destone28/Amelie2.0/docs/images/insieme.png

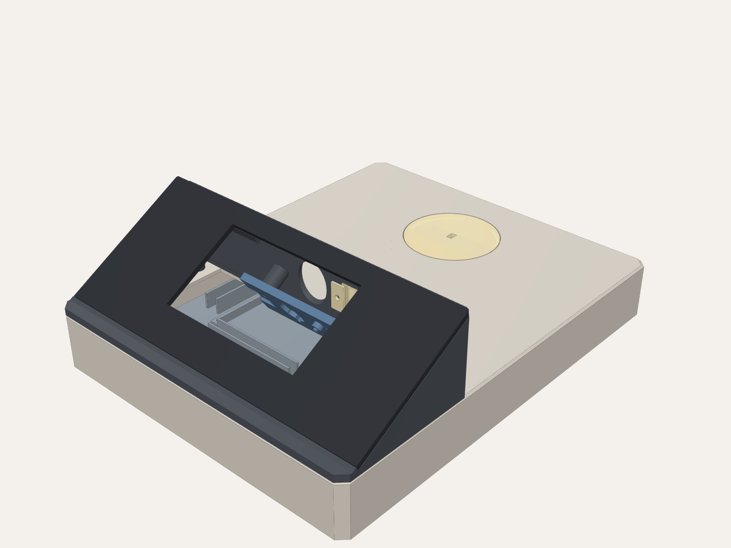
docs/images/insieme.png
