destone28/Amelie2.0/hardware/stl/FermoUno.stl

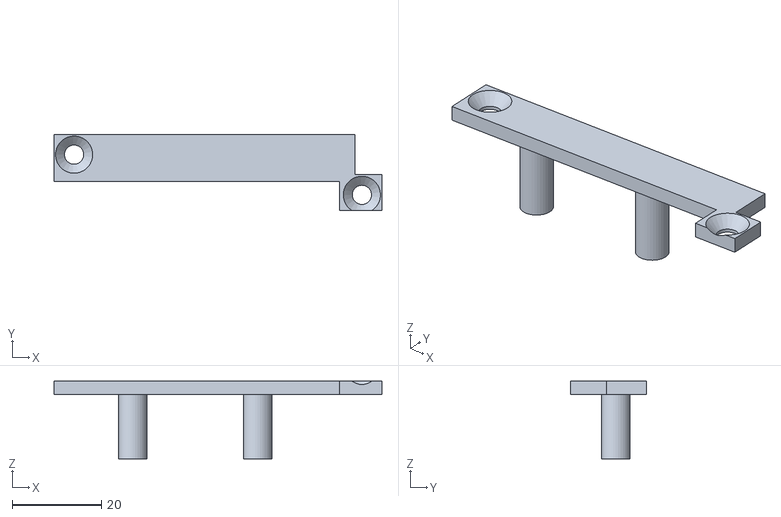
[picture p10: CAD file, 2026-09-26]
hardware/stl/FermoUno.stl
73.4 x 17.0 x 17.4
