destone28/Amelie2.0/hardware/stl/Piastra.stl

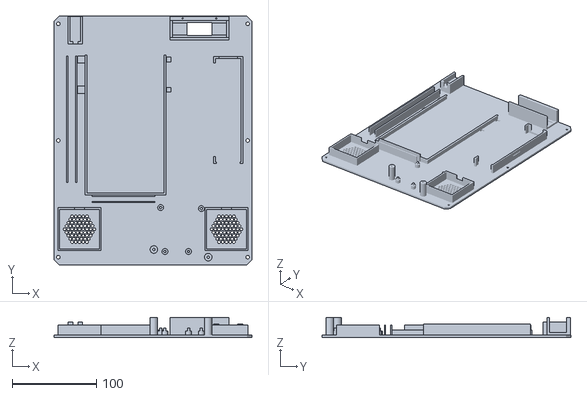
[picture p11: CAD file, 2026-09-26]
hardware/stl/Piastra.stl
234.4 x 294.4 x 24.0
