destone28/Amelie2.0/hardware/stl/FermoSwitch.stl

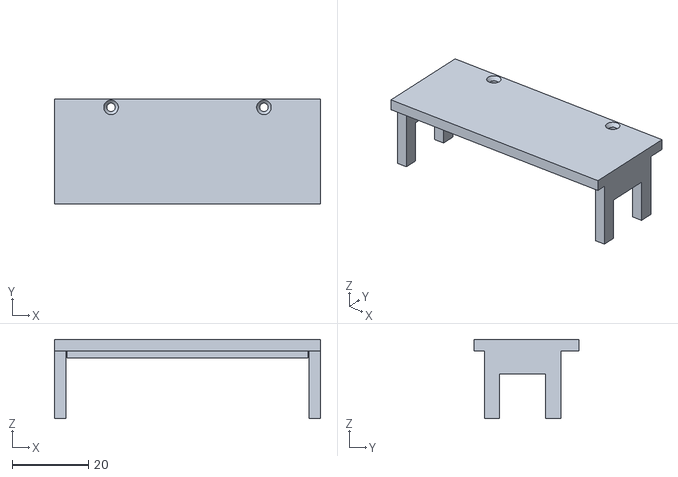
[picture p12: CAD file, 2026-09-26]
hardware/stl/FermoSwitch.stl
69.6 x 27.6 x 20.7
