destone28/Amelie2.0/hardware/stl/Frontale.stl

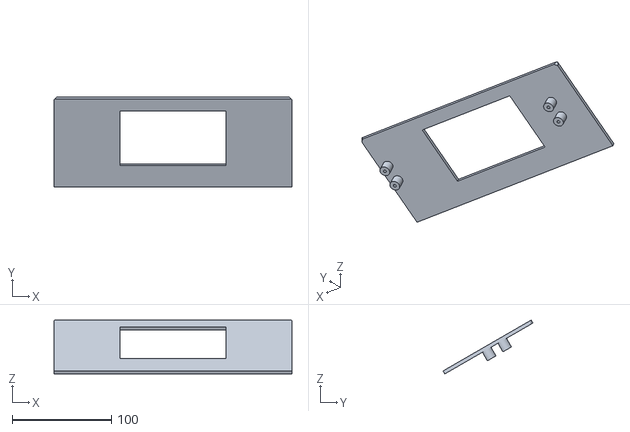
[picture p13: CAD file, 2026-09-26]
hardware/stl/Frontale.stl
239.4 x 90.4 x 54.2
