destone28/Amelie2.0/hardware/stl/VassoioLuce.stl

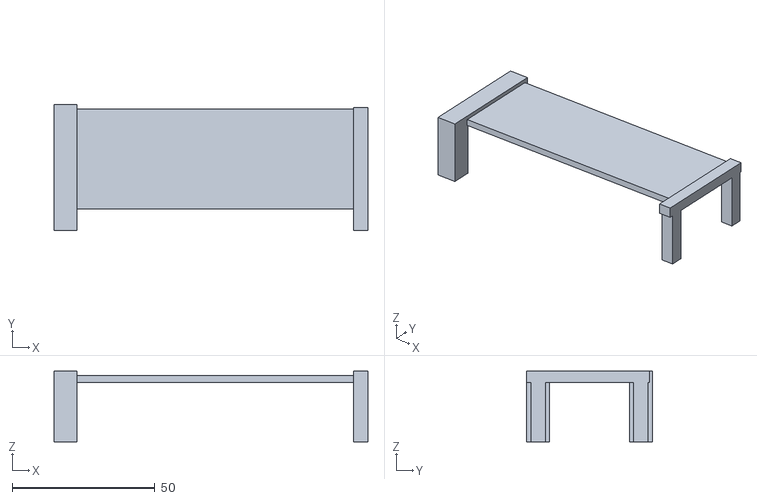
[picture p14: CAD file, 2026-09-26]
hardware/stl/VassoioLuce.stl
110.0 x 44.0 x 24.8
