destone28/Amelie2.0/hardware/stl/FermoHub.stl

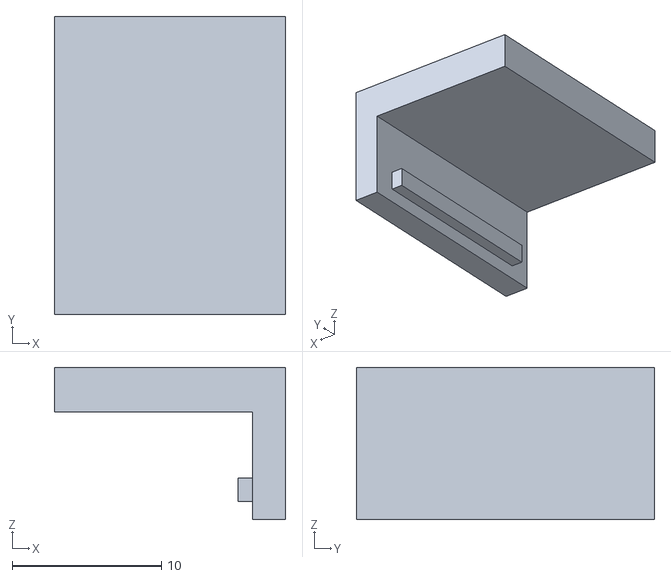
[picture p15: CAD file, 2026-09-26]
hardware/stl/FermoHub.stl
15.5 x 20.0 x 10.2
