destone28/Amelie2.0/hardware/stl/CerchioLuce.stl

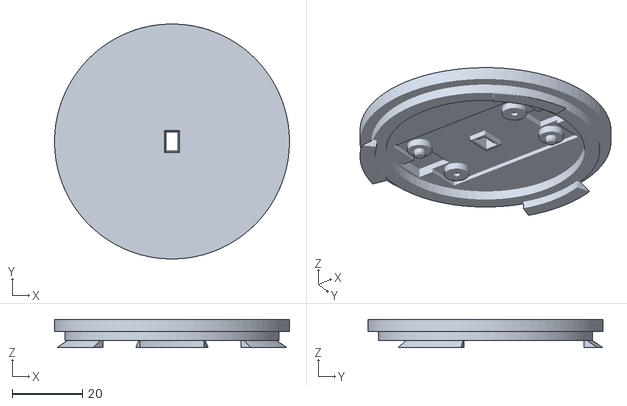
[picture p16: CAD file, 2026-09-26]
hardware/stl/CerchioLuce.stl
66.9 x 66.9 x 8.00
