destone28/Amelie2.0/hardware/stl/PlaccaLuce.stl

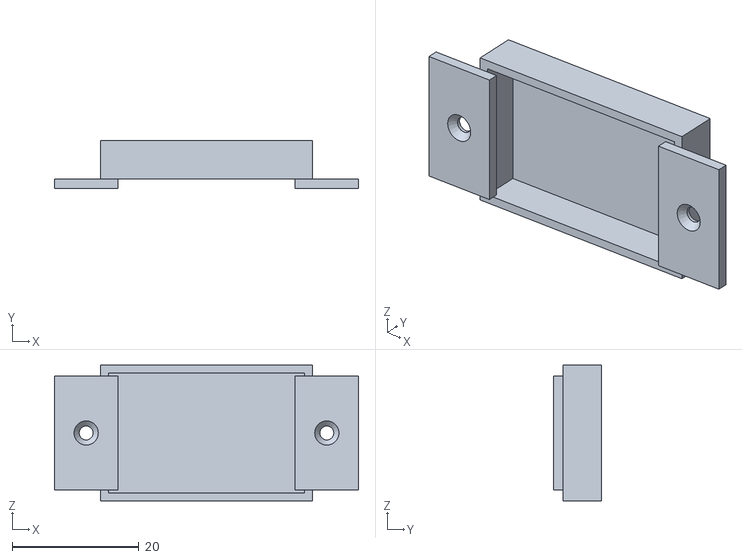
[picture p17: CAD file, 2026-09-26]
hardware/stl/PlaccaLuce.stl
48.0 x 7.50 x 21.4
