destone28/Amelie2.0/hardware/stl/Torre.stl

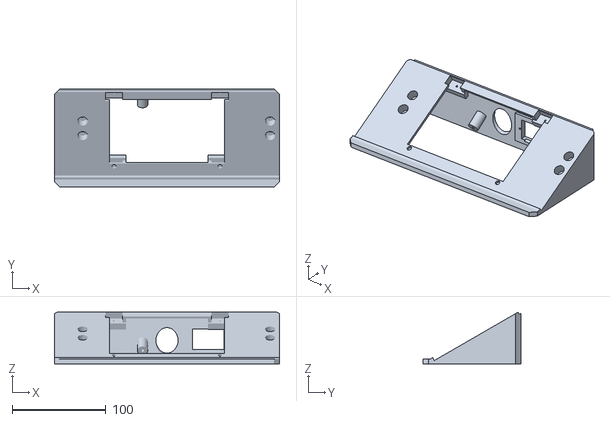
[picture p18: CAD file, 2026-09-26]
hardware/stl/Torre.stl
240.0 x 105.0 x 55.0
