destone28/Amelie2.0/hardware/stl/Base.stl

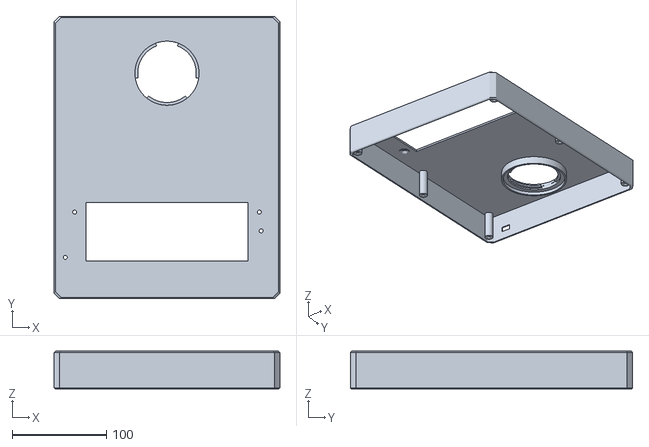
[picture p19: CAD file, 2026-09-26]
hardware/stl/Base.stl
240.0 x 300.0 x 40.0
