destone28/Amelie2.0/hardware/stl/PannelloOttico.stl

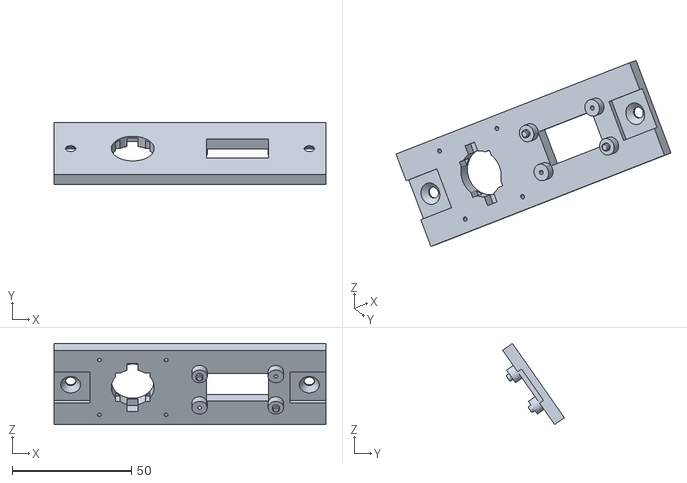
[picture p20: CAD file, 2026-09-26]
hardware/stl/PannelloOttico.stl
114.0 x 25.9 x 34.0
