destone28/Amelie2.0/src/amelie/app.py

"""L'orchestratore: mette insieme sensore, camera, riconoscimento, voce e schermo.

Un solo processo, un solo ciclo. Il lavoro pesante — cattura, OCR, generazione,
sintesi — gira in un thread separato, perché sono operazioni che bloccano per
secondi e il ciclo degli eventi deve restare libero di aggiornare lo schermo.

## La regola che decide l'architettura

**Niente gira in parallelo.** OCR, modello e voce si contendono gli stessi
quattro core, e su questa board sono tutti e tre al limite: farli concorrere li
rallenta tutti. La pipeline è quindi rigorosamente sequenziale, e questo risolve
gratis anche la contesa sul bus USB — lo stream della camera si chiude prima che
la voce cominci.

L'eccezione è una sola, ed è voluta: una bottiglia cambiata a racconto in corso
si legge mentre la voce parla ancora della precedente, per non far pesare
l'attesa (vedi `Amelie._anticipa`).

## Il tempo

Il momento in cui l'ospite appoggia la bottiglia è l'unica cosa che il
dispositivo non controlla. Da lì:

    innesco         0,15 s  il sensore di distanza, tre letture d'accordo
    scatto          ~0 s    il fotogramma si prende dal flusso gia' in moto
    OCR             0,5-1,5 s  il vero costo
    riconoscimento  ~0,05 s SQLite
    racconto        ~0 s    composto dai fatti; decine di secondi dal modello

I numeri sono misurati sul dispositivo. Lo scatto non costa quasi niente
perche' il flusso della camera e' gia' aperto, e il racconto si compone dai
fatti: il modello resta un'opzione, e costa l'attesa della generazione.
"""

from __future__ import annotations

import argparse
import asyncio
import csv
import json
import logging
import os
import threading
import time
from dataclasses import dataclass, field
from pathlib import Path
from typing import Any

from .batteria import Batteria
from .bridge import (
    LUCE, LUCE_ROSSA, LUCE_SPENTA,
    ErroreMCU, Luce, Ponte, PonteNonDisponibile, PonteSimulato,
    Presenza as PresenzaDistanza,
)
from .capture import (
    Camera, CameraNonDisponibile, PresenzaOttica, blocca_esposizione,
)
from .carta import Carta, CartaVuota
from .correzioni import Correzioni
from .giornale import Giornale
from .mirino import LetturaContinua, Mirino
from .matcher import Fatti, Livello, Matcher
from .narrator import Narratore, spezza_in_frasi, titolo_generico
from .ocr import Lettore, OCRNonDisponibile
from .speech import (
    VOCI, VOLUME_PREDEFINITO, ImpostazioniVoce, Riproduttore, Voce,
    VoceNonDisponibile, caratteri_al_secondo, per_la_voce,
)
from .state import (
    DURATE_S, EFFETTI_INGRESSO, TRANSIZIONI, Effetto, Evento, Macchina, Stato,
)

log = logging.getLogger("amelie")

RADICE = Path(__file__).resolve().parents[2]
STATICI = Path(__file__).resolve().parent / "ui" / "static"

# Come si vede ogni stato sullo schermo.
VISTA = {
    Stato.ATTESA: "attesa",
    Stato.ASSESTAMENTO: "lavoro",
    Stato.SCANSIONE: "lavoro",
    Stato.RICONOSCIMENTO: "lavoro",
    Stato.RACCONTO: "racconto",
    Stato.CONCLUSO: "racconto",
    Stato.RIPOSIZIONA: "avviso",
    Stato.GUASTO: "avviso",
}

# Dopo tre letture a vuoto si smette di riprovare.
TENTATIVI_MAX = 3
# Quanto si aspetta che finisca il lavoro precedente prima di dichiarare guasto.
ATTESA_DEL_LAVORO_S = 8.0

# Il ripristino da soli. Un guasto isolato scade in sei secondi e torna in
# attesa: non serve niente. Tre in tre minuti vogliono dire che qualcosa si e'
# inceppato davvero - la camera che non da' piu' fotogrammi, un lavoro che
# non torna - e ogni bottiglia finirebbe in guasto fino a spegnere e
# riaccendere. Allora si ripristina: vedi `Amelie.ripristina`.
GUASTI_PER_RIPRISTINO = 3
FINESTRA_GUASTI_S = 180.0
# Se i guasti tornano entro dieci minuti da un ripristino, ripristinare non e'
# bastato: si riavvia il servizio, che riparte da zero in una quarantina di
# secondi. E' quello che fa spegnere e riaccendere, senza spegnere.
DOPO_RIPRISTINO_S = 600.0

# Di quanto saltano i due pulsanti laterali. Cinque secondi: meno non si
# distingue da un tocco a vuoto, di piu' scavalca una frase intera.
SALTO_S = 5.0
# Quanto puo' durare al massimo un racconto prima che il thread di lavoro si
# liberi comunque. Serve al caso in cui qualcuno mette in pausa e si alza da
# tavola: la bottiglia tolta lo chiude subito, ma se nessuno la toglie il
# dispositivo non puo' restare occupato per sempre.
TETTO_RACCONTO_S = 900.0

# Il volume regolato a schermo sopravvive allo spegnimento: chi apre il
# ristorante non deve ritararlo ogni sera. Sta in `var`, che e' l'unica cartella
# del progetto che l'unita' systemd lascia scrivibile.
PERCORSO_VOLUME = RADICE / "var" / "volume"
# Come il dispositivo racconta. Tre modi, e la differenza fra loro non e' di
# stile: e' DA DOVE VIENE quello che dice. Il modo si ricorda come il volume,
# perche' e' una scelta di chi apre il locale, non un parametro di collaudo.
#
#   archivio    il racconto composto dai dati del registro UE e dal
#               disciplinare, senza modello. Istantaneo, e vero per
#               costruzione: e' il modo predefinito.
#   generativa  gli stessi dati, ma il testo lo scrive il modello sul momento
#               per QUELLA bottiglia. Costa l'attesa della generazione, e passa
#               dalla `verifica` del narratore.
#   carta       una carta dei vini scritta a mano, in un file. Solo i vini che
#               ci sono dentro, e per quelli il testo e' quello che ha scritto
#               una persona. Vedi `amelie.carta`.
MODI = ("archivio", "generativa", "carta")
PERCORSO_MODO = RADICE / "var" / "modo"
# L'interruttore «Aggiungi correzioni»: acceso, su ogni racconto compare il
# pulsante per correggere la bottiglia. Resta com'e' anche dopo un riavvio.
PERCORSO_CORREZIONI_ATTIVE = RADICE / "var" / "correzioni_attive"
# Il servizio di sistema che tiene su il modello linguistico. Lo accende e lo
# spegne il modo di racconto: vedi `Amelie._accendi_il_modello`.
SERVIZIO_MODELLO = "amelie-llm.service"
PERCORSO_BATTERIA = RADICE / "var" / "batteria.json"
# Il piatto vuoto, com'e' quando non c'e' niente sopra. E' una proprieta'
# dell'installazione, non del processo: senza ricordarlo, un dispositivo acceso
# con la bottiglia gia' posata imparerebbe quella come sfondo, e finche' non la
# si toglie il riquadro della sua etichetta non si troverebbe. Vedi
# `PresenzaOttica.ricorda`.
PERCORSO_SFONDO = RADICE / "var" / "sfondo.npy"
# Il giornale di bordo: una riga per scansione e il fotogramma che l'ha
# prodotta. Vedi `amelie.giornale`.
CARTELLA_GIORNALE = RADICE / "var" / "scansioni"
# Ogni quanto si puo' riscrivere lo sfondo, e di quanto deve essere cambiato
# perche' valga la pena. La memoria della board e' flash: un aggiornamento al
# minuto sarebbero settanta megabyte al giorno per un file che quasi non cambia.
RIPOSO_SFONDO_S = 600.0
# Quanto puo' restare aperto l'editor di una correzione prima che lo si chiuda
# da soli. Dieci minuti: scrivere una descrizione vera ne chiede cinque, e oltre
# c'e' un tavolo che aspetta.
CORREZIONE_TETTO_S = 600.0
# Quanto resta a schermo un racconto finito che si puo' correggere. Di norma
# sono i due secondi di CONCLUSO; ma sulla bottiglia fuori archivio l'ultima
# frase dice che la descrizione si e' fatta da se', ed e' li' che viene voglia
# di correggerla. Due secondi non bastano ad arrivare al pulsante: il tocco
# cadrebbe sulla schermata d'invito. Dodici lasciano il tempo di arrivarci.
CONCLUSO_CON_CORREZIONE_S = 12.0
# Quanto resta la schermata finale dopo un cambio di lingua: il tempo di
# annunciare la lingua e di far ripartire il racconto (`_riprendi_racconto`
# aspetta al massimo 5 + 6 secondi), con un margine.
LINGUA_A_RACCONTO_FINITO_S = 15.0
SFONDO_DA_RISCRIVERE = 0.20
# Quanti punti dell'etichetta, ritrovati nella foto nuova, bastano a dire che
# la bottiglia rimessa sul piatto e' la stessa che si sta raccontando. Misurato
# su 75 scansioni vere del dispositivo, cinque bottiglie, confrontando la zona
# dell'etichetta di una foto con l'intera foto dell'altra: fra bottiglie
# diverse mai oltre 17 punti su 4.022 coppie; fra foto della stessa bottiglia
# 25 o piu' nella meta' delle 1.528 coppie. Il contrario la foto non lo sa
# dire: una bottiglia su quattro, rimessa girata, ritrova meno di 10 punti. Per
# dire «e' un'altra» serve il testo.
STESSA_A_OCCHIO = 25
# Quanto vale una lettura fatta in anticipo, se nessuno la usa subito.
ANTICIPO_VALIDO_S = 30.0
# Quanto si aspetta prima di far sentire il colpetto di ritorno. Chi tara il
# volume preme piu' volte di fila, e un colpetto per pressione sarebbe un
# tambureggiamento: si suona quando la mano si e' fermata.
RIPOSO_VOLUME_S = 0.35

# Il tono di ogni schermata: con lo stesso oro per tutte, un guasto avrebbe
# l'aria di un invito. Il rosso e' lo stesso dell'anello.
TONO = {
    Stato.RIPOSIZIONA: "invito",     # ambra: si chiede una cosa
    Stato.GUASTO: "errore",          # rosso: qualcosa non ha funzionato
    Stato.CONCLUSO: "neutro",
}

# La luce dell'anello per ogni effetto: bianca e gialla quando il dispositivo
# lavora, rossa per un guasto. In attesa diventa rossa anche a batteria
# scarica: vedi `_luce_per`.
LUCE_ANELLO: dict[Effetto, Luce] = {
    Effetto.ANELLO_RESPIRO: LUCE,
    Effetto.ANELLO_ACCESO: LUCE,
    Effetto.ANELLO_LAVORO: LUCE,
    Effetto.ANELLO_ATTENZIONE: LUCE_ROSSA,
    Effetto.ANELLO_SPENTO: LUCE_SPENTA,
}


@dataclass
class _Anticipo:
    """Una bottiglia arrivata mentre si raccontava la precedente, e la sua lettura."""

    apparsa: float
    annullata: threading.Event = field(default_factory=threading.Event)
    scatto: Any = None
    lettura: Any = None
    allargata: Any = None
    durata_scatto: float = 0.0
    letta: float = 0.0


@dataclass
class Configurazione:
    simula_mcu: bool = False
    senza_camera: bool = False
    senza_voce: bool = False
    # Il modello linguistico e' un'opzione. Il modo predefinito e' il racconto
    # composto dai fatti, vero per costruzione e istantaneo: un modello piccolo
    # che scrive da se' puo' sbagliare un fatto o una parola, e la verifica
    # non li prende tutti. Con --con-modello il modo «generativa» diventa
    # sceglibile dalle impostazioni: il modello scrive per primo, verificato,
    # e ripiega sul racconto pronto per quel record e poi sulla composizione.
    senza_modello: bool = True
    # Il modello caricato e' quello affinato su questo progetto? Cambia la
    # FORMA del prompt, non solo il contenuto: il modello addestrato vuole i
    # fatti compatti e una riga di istruzione, quello generico le istruzioni
    # per esteso. Darne una per l'altra costa il doppio del tempo e la
    # qualita' che l'addestramento aveva comprato.
    modello_addestrato: bool = False
    device_audio: str = "plughw:0,3"
    porta: int = 8080
    # Il battito, ed e' lui a vedere arrivare la bottiglia: il sensore di
    # distanza risponde in sei millesimi e vuole tre letture d'accordo per dire
    # che c'e' qualcuno, quindi il ritardo dell'innesco e' tre battiti. A 0,05 s
    # sono centocinquanta millesimi, e costano il dodici per cento di un core a
    # non far niente; a 0,15 s sarebbero quattrocentocinquanta, meta' del
    # secondo che c'e' in tutto.
    periodo_sensore_s: float = 0.05
    # Ogni quanto si guarda il piatto. Col guardiano in moto il fotogramma c'e'
    # gia' e la sbirciata costa la conversione in grigio, una decina di
    # millesimi; a stream fermo sarebbero novanta millesimi di camera. La
    # sbirciata non decide se c'e' una bottiglia - lo dice il sensore, vedi
    # `Amelie._chi_c_e` - ma tiene aggiornati il riquadro dell'etichetta e lo
    # sfondo del piatto vuoto.
    periodo_sbirciata_s: float = 0.25
    # Una carta dei vini al posto dell'archivio: un CSV con titolo e
    # descrizione, e nel modo «carta» il dispositivo legge quella invece di
    # comporre dai dati. Vedi `amelie.carta`.
    carta: str | None = None
    # La lingua di partenza. Si cambia a schermo, con un tocco, e il
    # dispositivo torna a questa quando la bottiglia viene tolta: il tavolo
    # dopo trova il dispositivo come lo trova sempre.
    lingua: str = "it"
    # Il volume di partenza, che il file in `var` sovrascrive se c'e'. 100 e'
    # il fondo scala del PCM: sopra non si puo' andare, vedi speech.guadagno_di.
    volume: int = VOLUME_PREDEFINITO


class Amelie:
    def __init__(self, cfg: Configurazione) -> None:
        self.cfg = cfg
        self.macchina = Macchina(su_transizione=self._su_transizione)
        self.ponte: Ponte = PonteSimulato() if cfg.simula_mcu else Ponte()
        # Due modi di guardare il piatto, e fanno due lavori diversi.
        #
        # Il sensore di distanza dice SE e QUANDO, e lo dice in millesimi: e'
        # lui l'innesco, perche' e' l'unico abbastanza rapido perche' il testo
        # compaia entro un secondo da quando il vetro tocca il piatto. Vedi
        # `_chi_c_e`.
        #
        # La camera dice DOVE: e' da lei che viene il riquadro dell'etichetta,
        # che cambia con la forma della bottiglia.
        self.presenza = PresenzaOttica()
        self.distanza = PresenzaDistanza()
        # Quando la bottiglia e' comparsa: lo scatto deve essere di DOPO.
        self._apparsa = 0.0
        # C'e' una bottiglia adesso, secondo il sensore.
        self._presente = False
        # Il sensore ha visto andare via o arrivare qualcosa mentre si
        # raccontava: finito il racconto, si legge di nuovo.
        self._cambiata_durante_il_racconto = False
        self.camera = None if cfg.senza_camera else Camera()
        self.lettore = None if cfg.senza_camera else Lettore()
        self.giornale = Giornale(CARTELLA_GIORNALE)
        self.batteria = Batteria(PERCORSO_BATTERIA)
        # Com'era la batteria l'ultima volta che si e' scelta la luce: vedi
        # `_ricontrolla_la_luce`.
        self._batteria_era_scarica = False
        self.carta = self._apri_carta(cfg.carta)
        # La voce della carta scelta per questa bottiglia, in attesa di essere
        # raccontata. Sostituisce i fatti per tutto il giro.
        self._voce: object | None = None
        self.matcher = Matcher()
        # Le bottiglie corrette a mano da chi sta in sala: si riconoscono prima
        # dell'archivio e prima della carta, in qualunque modo di racconto.
        self.correzioni = Correzioni()
        # La correzione riconosciuta per la bottiglia che c'e' adesso, se c'e'.
        self._correzione = None
        # L'editor aperto: la lettura da correggere, tenuta ferma. Finche' non
        # e' None il dispositivo non guarda il piatto - vedi `_un_battito`.
        self._correggendo: dict | None = None
        # Le righe dell'OCR con il loro quadrilatero: servono a sapere dove sta
        # l'etichetta nella foto. `_righe` ne tiene solo il testo.
        self._righe_lette: list = []
        self.voce = None if cfg.senza_voce else Voce(
            ImpostazioniVoce(device_alsa=cfg.device_audio))
        self.narratore = Narratore(modello_addestrato=cfg.modello_addestrato,
                                   genera=self._genera if not cfg.senza_modello else None,
                                   lingua=cfg.lingua,
                                   # La gabbia e' spenta: su duecentodieci
                                   # bottiglie stratificate perde otto testi
                                   # e sui record poveri scrive italiano
                                   # rotto. Vedi `amelie.gabbia`.
                                   gabbia=False)
        self.lex = self.narratore.lex
        self.lingua = cfg.lingua

        self._ascoltatori: set[asyncio.Queue] = set()
        self._loop: asyncio.AbstractEventLoop | None = None
        self._lavoro: threading.Thread | None = None
        self._scadenza: float | None = None
        self._fatti: Fatti = Fatti()
        self._candidati: list[str] = []
        # I tentativi andati a vuoto con questa bottiglia: letture senza
        # parole, letture senza riscontro, rilanci dall'attesa. Senza un tetto,
        # un oggetto illeggibile lasciato sul piatto fa lampeggiare l'anello e
        # girare l'OCR per tutta la sera, su una board senza ventola.
        self._tentativi = 0
        self._ferma_voce = threading.Event()
        # Il racconto in riproduzione, se ce n'e' uno. Lo tocca il thread di
        # lavoro che lo crea e lo toccano le richieste HTTP dei pulsanti: due
        # padroni, quindi un lucchetto.
        self._lettore: Riproduttore | None = None
        self._lucchetto_lettore = threading.Lock()
        # Gli annunci si fanno UNO ALLA VOLTA, da un thread solo. Chi tocca
        # mentre uno sta parlando lo interrompe e lascia detto quale lingua
        # vuole sentire, e i tocchi che si accumulano nel frattempo si riducono
        # a quell'unica richiesta. Vedi `_chiedi_annuncio`.
        self._lucchetto_annuncio = threading.Lock()
        # I guasti recenti, e quando si e' ripristinato l'ultima volta.
        self._guasti: list[float] = []
        self._ultimo_ripristino: float | None = None
        self._da_ripristinare: str | None = None
        self._lingua_da_annunciare: str | None = None
        self._annunciatore_vivo = False
        # Il colpetto di ritorno del volume, rimandato finche' la mano si ferma.
        self._lucchetto_volume = threading.Lock()
        self._rinvio_colpetto: threading.Timer | None = None
        # Vero quando il dispositivo ha finito di prepararsi. La schermata
        # d'avvio guarda questo per sapere quando lasciare il posto: prima le
        # voci non sono caricate, e la prima frase uscirebbe con quindici
        # secondi di ritardo proprio davanti al primo ospite.
        self._pronta = False
        # Una bottiglia finta, per il banco e per i test: vedi l'endpoint
        # /prova. Quando c'e' prende il posto di quello che dice il sensore, e
        # il resto del battito la tratta come una bottiglia vera.
        self._bottiglia_finta: bool | None = None
        # Quando tocca guardare di nuovo il piatto.
        self._prossima_sbirciata = 0.0
        # Lo sfondo scritto su disco, e quando si potra' riscrivere.
        self._sfondo_scritto = None
        self._prossimo_sfondo = 0.0
        # Il mirino, quando e' acceso. Non si costruisce qui: ha bisogno del
        # matcher e del lettore gia' aperti, e finche' nessuno lo chiede non
        # deve esistere. Vedi `imposta_mirino`.
        self.mirino: Mirino | None = None
        # Quello che si sa della scansione in corso, da annotare quando
        # finisce. Vedi `_annota`.
        self._scansione: dict[str, Any] = {}
        # Questa bottiglia e' gia' stata servita: si e' raccontata fino in
        # fondo, oppure l'ospite ha annullato. Finche' e' alzata, il ciclo non
        # riparte da solo: la schermata conclusa torna da sola all'invito, e in
        # attesa, con la bottiglia ancora sul piatto, il rilancio in
        # `_un_battito` farebbe ripartire una seconda lettura, e poi una terza.
        # Si abbassa quando la bottiglia viene tolta davvero - che e' il modo
        # in cui l'ospite dice "ho finito".
        self._bottiglia_chiusa = False
        # La bottiglia arrivata a racconto in corso: la lettura in corso, e
        # quella finita e riconosciuta come un'altra bottiglia, in attesa che
        # la scansione la prenda. Vedi `_anticipa`.
        self._anticipo: _Anticipo | None = None
        self._anticipata: _Anticipo | None = None
        self.volume = self._volume_salvato(cfg.volume)
        if self.voce is not None:
            self.voce.volume = self.volume
        # Spente di partenza: un dispositivo appena acceso deve rispondere
        # subito. Chi vuole la generazione dal vivo la accende sapendo che
        # costa un'attesa.
        self.modo = self._modo_salvato()
        self.correzioni_attive = self._correzioni_attive_salvate()

    @staticmethod
    def _apri_carta(percorso: str | None):
        """La carta dei vini, se ne e' stata chiesta una.

        Un file illeggibile non deve impedire al dispositivo di accendersi: si
        dice perche', e si torna all'archivio - che c'e' sempre.
        """
        if not percorso:
            return None
        try:
            return Carta(percorso)
        except (OSError, CartaVuota, KeyError, ValueError, csv.Error) as e:
            log.error("carta dei vini non caricata (%s): uso l'archivio", e)
            return None

    # --------------------------------------------------------- comunicazione

    def _pubblica(self, messaggio: dict[str, Any]) -> None:
        """Manda un messaggio a tutte le pagine aperte. Non blocca mai."""
        if self._loop is None:
            return
        dati = json.dumps(messaggio, ensure_ascii=False)
        for coda in list(self._ascoltatori):
            try:
                self._loop.call_soon_threadsafe(coda.put_nowait, dati)
            except (asyncio.QueueFull, RuntimeError):
                pass

    def _su_transizione(self, t) -> None:
        # Anche un rientro nello stesso stato ridisegna e rimette il tetto: e'
        # una transizione dichiarata, non un evento caduto nel vuoto.
        if t.cambia_stato or t.rientro:
            log.info("%s -> %s", t.da.value, t.a.value)
            if t.a is Stato.GUASTO and t.cambia_stato:
                self._conta_il_guasto()
            self._scadenza = (time.monotonic() + t.durata_s) if t.durata_s else None
            if t.a is Stato.CONCLUSO and self._azione_correzione() is not None:
                self._scadenza = time.monotonic() + CONCLUSO_CON_CORREZIONE_S
            elif t.a is Stato.CONCLUSO and self._niente_raccontato():
                # Col pulsante per insegnarla si lascia il tempo di arrivarci;
                # senza, non c'e' niente da guardare e si torna all'invito.
                self._scadenza = time.monotonic() + (
                    CONCLUSO_CON_CORREZIONE_S if self._aiuto_possibile() else 0.0)
            # Il tavolo e' finito: si torna alla lingua di casa PRIMA di
            # ridisegnare, cosi' la schermata d'attesa esce gia' nella lingua
            # giusta invece di cambiare sotto gli occhi di chi arriva.
            # Ma solo se sul piatto non c'e' piu' niente. Un racconto finito,
            # o annullato, con la bottiglia ancora li' vuol dire le stesse
            # persone: chi ha scelto l'inglese dovrebbe ricercarsi la
            # bandierina a ogni bottiglia. La lingua torna a casa quando la
            # bottiglia viene TOLTA, che e' il momento in cui il tavolo cambia
            # davvero: qui se e' gia' stata tolta (anche durante il racconto,
            # e poi si e' annullato), in `_un_battito` se la si toglie ad
            # attesa gia' raggiunta.
            if t.cambia_stato and t.a is Stato.ATTESA and not self._presente:
                self._torna_alla_lingua_di_casa()
            # Questa bottiglia e' finita, comunque sia finita: perche' il
            # racconto e' arrivato in fondo, o perche' l'ospite ha annullato.
            # In tutti e due i casi il ciclo NON deve ripartire da solo con la
            # bottiglia ancora sul piatto - vedi il ramo di rilancio in
            # `_un_battito`, che senza questa bandiera rilancerebbe al primo
            # battito, cioe' un istante dopo il tocco.
            if t.a is Stato.CONCLUSO or t.evento is Evento.ANNULLA:
                # A meno che il sensore non abbia visto la bottiglia andare
                # via o arrivarne una mentre si raccontava: allora quella sul
                # piatto puo' essere un'altra, e in attesa la si rilegge.
                self._bottiglia_chiusa = not self._cambiata_durante_il_racconto
                self._cambiata_durante_il_racconto = False
            # Una scansione rimasta senza esito qui ha finito comunque, e va a
            # giornale con il modo in cui e' finita. Succede quando l'ospite
            # annulla, o toglie la bottiglia a meta': senza questa riga, proprio
            # i casi piu' interessanti sarebbero gli unici a non lasciare traccia.
            if self._scansione and t.a in (Stato.ATTESA, Stato.CONCLUSO):
                self._annota(f"chiuso da {t.evento.value}")
            self._mostra(t.a)
        for e in t.effetti:
            self._esegui(e)

    def _torna_alla_lingua_di_casa(self) -> None:
        """Tolta la bottiglia, la lingua torna quella di partenza.

        Il tavolo dopo deve trovare il dispositivo come lo trova sempre: chi si
        siede non ha modo di sapere che l'inglese ce l'ha lasciato qualcun
        altro, ne' che la bandierina si tocca per cambiarlo.

        Senza voce e senza annuncio: qui non c'e' nessuno a cui dirlo, e un
        dispositivo che parla da solo a tavolo vuoto in un ristorante e' una
        cosa inaccettabile in sala.
        """
        if self.lingua == self.cfg.lingua:
            return
        log.info("tavolo finito, torno alla lingua di casa: %s -> %s",
                 self.lingua, self.cfg.lingua)
        self.lingua = self.cfg.lingua
        self.narratore.lingua = self.cfg.lingua
        if self.voce is not None:
            self.voce.per_lingua(self.cfg.lingua)
        self._manda_lingua()

    def _mostra(self, stato: Stato) -> None:
        """Che cosa vede l'ospite. Le frasi vengono dal lessico, non da qui.

        Cablarle nel codice vorrebbe dire avere lo schermo in italiano e il
        racconto in inglese, che e' il modo peggiore di essere bilingui.
        """
        def frase(chiave: str) -> str:
            return self.lex.frase("schermo", chiave, lingua=self.lingua)

        if stato is Stato.CONCLUSO and self._niente_raccontato():
            # Ci si arriva dopo aver rinunciato a leggere l'etichetta: la vista
            # "racconto" mostrerebbe un titolo vuoto e nessun testo, cioe' uno
            # schermo nero con una bottiglia ancora appoggiata sopra.
            #
            # Chiedere di togliere la bottiglia non servirebbe a niente. Se la
            # bottiglia si puo' insegnare al dispositivo - correzioni accese, e
            # qualche parola letta - si dice che non la si e' riconosciuta e si
            # offre il pulsante per farlo; se no si torna subito all'invito, e
            # la macchina ci arriva un istante dopo (vedi `_su_transizione`).
            if self._aiuto_possibile():
                self._pubblica({"tipo": "stato", "vista": "avviso", "simbolo": "?",
                                "tono": "neutro", "frase": frase("non_riconosciuta"),
                                "aiuta": True,
                                "voce_muta": not self._voce_disponibile()})
            else:
                self._pubblica({"tipo": "stato", "vista": "attesa",
                                "voce_muta": not self._voce_disponibile()})
            return

        m: dict[str, Any] = {"tipo": "stato", "vista": VISTA[stato],
                             # Lo schermo e l'anello devono dire la stessa cosa:
                             # se il LED e' rosso, il simbolo a schermo non puo'
                             # essere dello stesso oro dell'invito.
                             "tono": TONO.get(stato, "invito"),
                             "voce_muta": not self._voce_disponibile()}
        if stato in (Stato.RACCONTO, Stato.CONCLUSO):
            f = self._fatti
            m["correzione"] = self._azione_correzione()
            if self._correzione_parla_ora():
                m["titolo"] = self._correzione.testo_in(self.lingua)["titolo"]
                m["sottotitolo"] = ""
            elif self._la_carta_parla_ora():
                # Quando a raccontare e' la carta, il titolo e' il suo. I fatti
                # dell'archivio, in modo carta, servono solo da ripiego per le
                # altre lingue e possono nominare un altro vino: titolo dai
                # fatti vorrebbe dire un «Garda Cabernet 2008» scritto sopra la
                # descrizione di un Lambrusco Grasparossa.
                m["titolo"] = self._voce.titolo_in(self.lingua)
                m["sottotitolo"] = ""
            else:
                m["titolo"] = f.nome or f.tipologia or f.denominazione or (
                    f.vitigni[0] if f.vitigni else "")
                if not m["titolo"]:
                    # Al livello GENERICO non c'e' nessun nome da mettere - e'
                    # il livello in cui non si e' riconosciuto il vino - e
                    # senza titolo il testo salirebbe in cima, sotto le
                    # linguette della lingua, e l'ospite leggerebbe una
                    # descrizione senza sapere di CHE COSA.
                    #
                    # Il titolo c'e' lo stesso, ed e' quello che si e' letto
                    # sul vetro: «Spumante rosato brut». Sono le stesse parole
                    # con cui il racconto apre, e non ne aggiunge nessuna.
                    m["titolo"] = titolo_generico(f, self.lex, self.lingua)
                pezzi = [x for x in (f.cantina,
                                     str(f.annata) if f.annata else None) if x]
                m["sottotitolo"] = " · ".join(pezzi)
            # CONCLUSO mostra la stessa schermata del racconto - la vista non
            # cambia - e il racconto e' lo stesso: il testo NON va svuotato.
            # Senza questa riga, alla fine di ogni racconto l'ospite
            # guarderebbe due secondi di schermo vuoto con sopra il solo
            # pulsante: titolo, testo e barra sparirebbero tutti insieme,
            # perche' il client ripulisce a ogni messaggio di stato con vista
            # «racconto».
            m["stesso_racconto"] = stato is Stato.CONCLUSO
        elif stato is Stato.SCANSIONE:
            m["frase"] = frase("sto_leggendo")
        elif stato is Stato.RICONOSCIMENTO:
            m["frase"] = frase("un_attimo")
        elif stato is Stato.ASSESTAMENTO:
            m["frase"] = frase("fammi_guardare")
        elif stato is Stato.RIPOSIZIONA:
            m["simbolo"] = "↻"
            m["frase"] = frase("invito_a_girare")
            # Fra un tentativo e l'altro si puo' gia' insegnare la bottiglia,
            # senza aspettare che il dispositivo si arrenda.
            m["aiuta"] = self._aiuto_possibile()
        elif stato is Stato.GUASTO:
            m["simbolo"] = "⚠"
            m["frase"] = frase("guasto")
        self._pubblica(m)

    def _manda_lingua(self) -> None:
        """Le scritte fisse della pagina: quelle che nessun evento porta con se'."""
        self._pubblica({
            "tipo": "lingua",
            "lingua": self.lingua,
            "disponibili": list(self.lex.lingue),
            "voce_muta": not self._voce_disponibile(),
            "avviso_muto": self.lex.frase("schermo", "voce_assente",
                                          lingua=self.lingua),
            "annulla": self.lex.frase("schermo", "annulla", lingua=self.lingua),
            # Le scritte dell'editor della correzione, e della sua tastiera.
            "correzione": {
                # `n` resta segnaposto: «altre {n}» lo riempie la pagina.
                chiave: self.lex.frase("schermo", chiave, lingua=self.lingua, n="{n}")
                for chiave in ("correggi_descrizione", "modifica_descrizione",
                               "campo_titolo", "campo_descrizione", "salva",
                               "titolo_vuoto", "descrizione_vuota",
                               "correzione_spiega", "correzione_salvata",
                               "correzione_vicine", "tasto_spazio", "annulla",
                               "correzione_collegata", "descrizione_facoltativa",
                               "nessuna_di_queste", "altre_proposte",
                               "nessuna_scrivo_io", "aiutami", "si_scrivo",
                               "no_grazie")
            },
            # La frase sotto il nome, e che cosa si fa in tre passi, sulla
            # schermata d'attesa: il verbo, che la pagina scrive in grassetto,
            # e il resto della frase.
            "motto": self.lex.frase("schermo", "motto", lingua=self.lingua),
            "passi": [
                {"verbo": self.lex.frase("schermo", f"passo_{p}", lingua=self.lingua),
                 "resto": self.lex.frase("schermo", f"passo_{p}_resto",
                                         lingua=self.lingua)}
                for p in ("scegli", "posa", "ascolta")
            ],
            # Che cosa scrivere al posto del racconto mentre lo si scrive.
            # Sta qui, con le altre scritte fisse, perche' segua la lingua da
            # sola: il messaggio si rimanda a ogni cambio.
            "sto_scrivendo": self.lex.frase("schermo", "sto_scrivendo",
                                            lingua=self.lingua),
            # Le scritte del pannello delle impostazioni stanno QUI e non nel
            # messaggio «impostazioni», che porta i valori: cosi' seguono la
            # lingua da sole, perche' questo messaggio si rimanda a ogni cambio.
            "impostazioni": {
                chiave: self.lex.frase("schermo", chiave, lingua=self.lingua)
                for chiave in ("impostazioni", "descrizioni_generate",
                               "generate_spiega", "stato_tecnico", "chiudi",
                               "mirino", "mirino_spiega", "mirino_torna",
                               "mirino_legge", "mirino_trova", "mirino_niente",
                               "modo_titolo", "modo_archivio",
                               "modo_archivio_spiega", "modo_generativa",
                               "modo_generativa_spiega", "modo_carta",
                               "modo_carta_spiega", "batteria_ricaricata",
                               "batteria_spiega", "aggiungi_correzioni",
                               "aggiungi_correzioni_spiega", "ripristina",
                               "ripristina_spiega")
            },
        })

    # -------------------------------------------------------------- volume

    def _volume_salvato(self, ripiego: int) -> int:
        """Il volume dell'ultima volta, se c'e' ed e' un numero sensato.

        Non solleva mai: un file illeggibile deve costare il volume
        predefinito, non un dispositivo che non si accende.
        """
        try:
            valore = int(PERCORSO_VOLUME.read_text(encoding="utf-8").strip())
        except (OSError, ValueError):
            return max(0, min(100, int(ripiego)))
        return max(0, min(100, valore))

    @staticmethod
    def _scrivi_durevole(percorso: Path, valore: str, cosa: str) -> None:
        """Scrive in modo che sopravviva alla spina staccata.

        Questo dispositivo non si spegne con un comando: si toglie corrente a
        fine servizio. Fra la `rename` e il disco possono passare secondi, e in
        quei secondi il valore appena regolato non esiste da nessuna parte -
        chi ha appena tarato il volume e ha spento lo ritroverebbe com'era. Da
        qui i due `fsync`: uno per il contenuto, uno per la cartella, che e'
        cio' che rende durevole il nome nuovo.
        """
        try:
            percorso.parent.mkdir(parents=True, exist_ok=True)
            # Scrittura atomica: un file troncato da uno spegnimento tornerebbe
            # come valore illeggibile, e si ripartirebbe dal predefinito.
            tmp = percorso.with_suffix(".parziale")
            with open(tmp, "w", encoding="utf-8") as f:
                f.write(f"{valore}\n")
                f.flush()
                os.fsync(f.fileno())
            tmp.replace(percorso)
            cartella = os.open(percorso.parent, os.O_RDONLY)
            try:
                os.fsync(cartella)
            finally:
                os.close(cartella)
        except OSError as e:
            log.warning("%s non salvato: %s", cosa, e)

    def _salva_volume(self, valore: int) -> None:
        self._scrivi_durevole(PERCORSO_VOLUME, str(valore), "volume")

    # ------------------------------------------------------------- sfondo

    def _sfondo_ricordato(self):
        """Il piatto vuoto dell'ultima volta, se c'è ed è ancora della forma giusta.

        Non solleva mai: un file illeggibile, o scritto quando la fascia era
        grande diversamente, deve costare uno sfondo da reimparare, non un
        dispositivo che non si accende.
        """
        try:
            import numpy as np

            sfondo = np.load(PERCORSO_SFONDO)
        except Exception as e:                              # noqa: BLE001
            log.info("nessuno sfondo ricordato (%s): si impara dal piatto vuoto", e)
            return None
        atteso = (self.camera.imp.sbirciata[1], self.camera.imp.sbirciata[0])
        if sfondo.shape != atteso:
            log.warning("sfondo ricordato di forma %s invece di %s: lo ignoro",
                        sfondo.shape, atteso)
            return None
        return sfondo.astype("float32")

    def _ricorda_sfondo(self) -> None:
        """Scrive il piatto vuoto, ma solo se è cambiato e non troppo spesso."""
        import numpy as np

        from .capture import quanto_diverso

        sfondo = self.presenza.sfondo
        if sfondo is None or time.monotonic() < self._prossimo_sfondo:
            return
        if (self._sfondo_scritto is not None
                and quanto_diverso(self._sfondo_scritto, sfondo) < SFONDO_DA_RISCRIVERE):
            return
        try:
            PERCORSO_SFONDO.parent.mkdir(parents=True, exist_ok=True)
            tmp = PERCORSO_SFONDO.with_suffix(".parziale.npy")
            with open(tmp, "wb") as f:
                np.save(f, sfondo)
                f.flush()
                os.fsync(f.fileno())
            tmp.replace(PERCORSO_SFONDO)
            cartella = os.open(PERCORSO_SFONDO.parent, os.O_RDONLY)
            try:
                os.fsync(cartella)
            finally:
                os.close(cartella)
        except OSError as e:
            log.warning("sfondo non salvato: %s", e)
            return
        self._sfondo_scritto = sfondo
        self._prossimo_sfondo = time.monotonic() + RIPOSO_SFONDO_S
        log.info("sfondo del piatto vuoto aggiornato")

    # ------------------------------------------------------- impostazioni

    @staticmethod
    def _correzioni_attive_salvate() -> bool:
        """Spento se non c'e' niente di salvato: gli ospiti non devono trovare
        un pulsante per correggere, lo accende chi gestisce il locale."""
        try:
            return PERCORSO_CORREZIONI_ATTIVE.read_text(encoding="utf-8").strip() == "1"
        except OSError:
            return False

    def imposta_correzioni(self, attive: bool) -> dict[str, Any]:
        """L'interruttore «Aggiungi correzioni», dalle impostazioni.

        Vale subito, anche sul racconto a schermo: il pulsante compare o
        sparisce senza rifare niente. Spegnendo con l'editor aperto, l'editor
        si chiude senza salvare. Le correzioni gia' salvate restano e si
        riconoscono comunque: l'interruttore decide solo se se ne possono
        scrivere.
        """
        self.correzioni_attive = bool(attive)
        self._scrivi_durevole(PERCORSO_CORREZIONI_ATTIVE,
                              "1" if attive else "0", "l'interruttore delle correzioni")
        if not attive and self._correggendo is not None:
            self.chiudi_correzione()
            self._pubblica({"tipo": "correzione", "aperta": False})
        self._manda_impostazioni()
        if self.macchina.stato in (Stato.RACCONTO, Stato.CONCLUSO):
            self._pubblica({"tipo": "correzione", "azione": self._azione_correzione()})
        log.info("correzioni dal vetro: %s", "accese" if attive else "spente")
        return {"ok": True, "correzioni": self.correzioni_attive}

    def _modo_salvato(self) -> str:
        """Come raccontava l'ultima volta.

        Come il volume, non solleva mai: un file illeggibile deve costare le
        impostazioni predefinite, non un dispositivo che non si accende. E un
        modo salvato che non si puo' servire - la carta, quando il file manca -
        torna all'archivio invece di lasciare il dispositivo muto: l'archivio
        c'e' sempre.
        """
        try:
            salvato = PERCORSO_MODO.read_text(encoding="utf-8").strip()
        except OSError:
            salvato = ""
        if salvato not in MODI:
            salvato = "archivio"
        if salvato == "carta" and self.carta is None:
            log.warning("modo «carta» salvato ma la carta non c'e': uso l'archivio")
            return "archivio"
        if salvato == "generativa" and self.narratore.genera is None:
            return "archivio"
        return salvato

    @property
    def genera_racconti(self) -> bool:
        """Il modello scrive sul momento? È il modo «generativa» detto come un
        si' o un no: lo chiedono il narratore e i test."""
        return self.modo == "generativa"

    def imposta_modo(self, modo: str) -> dict[str, Any]:
        """Il selettore di come raccontare.

        Non tocca il racconto in corso: cambiare a meta' di una lettura
        significherebbe interromperla, e chi sta ascoltando non ha chiesto
        nulla. Vale dalla bottiglia dopo.
        """
        if modo not in MODI:
            return {"ok": False, "motivo": f"modi: {', '.join(MODI)}"}
        if modo == "carta" and self.carta is None:
            return {"ok": False, "motivo": "nessuna carta caricata"}
        if modo == "generativa" and self.narratore.genera is None:
            return {"ok": False, "motivo": "nessun modello caricato"}
        self.modo = modo
        self._scrivi_durevole(PERCORSO_MODO, modo, "il modo di raccontare")
        self._manda_impostazioni()
        log.info("modo di racconto: %s", modo)
        self._accendi_il_modello(modo == "generativa")
        return {"ok": True, "modo": modo}

    def _accendi_il_modello(self, acceso: bool, riavvia: bool = False) -> None:
        """Il servizio del modello linguistico si accende solo se serve.

        Misurato sul dispositivo: `llama-server` fermo, senza nessuna richiesta,
        sta all'88% di un core - e sono i quattro core su cui l'OCR deve
        leggere un'etichetta in meno di un secondo. Tenuto acceso con la
        generazione spenta dalle impostazioni, quel core e' regalato a nessuno:
        la rilevazione del testo passa da 274 a 750 millesimi.

        Si accende e si spegne col modo, in un thread perche' avviarlo carica
        ottocento megabyte e nessuno deve aspettarlo. Se il comando fallisce si
        registra e basta: un dispositivo senza modello racconta dall'archivio,
        un dispositivo bloccato non racconta niente.

        Senza `sudo`, di proposito: l'applicazione gira sotto
        `NoNewPrivileges=yes` e `sudo` non puo' alzare niente - fallisce con
        exit 1 e nessun altro segno. Il permesso sta in una regola polkit
        (`scripts/systemd/50-amelie-llm.rules`) che lascia all'utente
        `arduino` QUESTA unita' e nessun'altra.
        """
        if self.cfg.senza_modello:
            return

        def esegui() -> None:
            import subprocess
            verbo = ("restart" if riavvia else "start") if acceso else "stop"
            try:
                subprocess.run(["systemctl", verbo, SERVIZIO_MODELLO],
                               check=True, capture_output=True, timeout=30)
                log.info("modello linguistico: %s", "acceso" if acceso else "spento")
            except Exception as e:                          # noqa: BLE001
                log.warning("modello linguistico, %s fallito: %s", verbo, e)

        threading.Thread(target=esegui, name="modello", daemon=True).start()

    # --------------------------------------------------------------- mirino

    def imposta_mirino(self, acceso: bool) -> dict[str, Any]:
        """L'interruttore del mirino: il dispositivo smette di raccontare e guarda.

        Sono due modi di usare la stessa camera e non possono convivere: la
        camera si apre un processo per volta, e mentre il mirino tiene lo
        stream per mostrare cosa vede, una scansione non può scattare. Quindi
        accendere il mirino **ferma il ciclo**: niente sbirciate al piatto,
        niente racconti, niente timer. Si spegne dallo stesso interruttore, e
        il dispositivo torna quello di prima.

        Non si ricorda fra un avvio e l'altro, ed è voluto: questa è una
        modalità di taratura, e un dispositivo che si riaccende in sala deve
        riaccendersi come un dispositivo che racconta vini. Chi l'ha lasciata
        accesa la sera prima non se ne ricorderà.

        L'anello va a bianco come durante la raffica, e la posa si cerca una
        volta all'accensione: si tara l'inquadratura con la luce e la posa che
        ci saranno davvero, non con quelle della stanza.
        """
        acceso = bool(acceso)
        if acceso == (self.mirino is not None and self.mirino.acceso):
            return self._stato_mirino()
        if acceso:
            self._accendi_mirino()
        else:
            self._spegni_mirino()
        stato = self._stato_mirino()
        # Si dichiara com'e' andata, non cosa si e' chiesto: senza camera
        # l'accensione non succede, e un giornale che dice «acceso» mentre lo
        # schermo resta nero manda a cercare il guasto dalla parte sbagliata.
        log.info("mirino: %s", "acceso" if stato["acceso"] else "spento")
        self._manda_mirino()
        return stato

    def _accendi_mirino(self) -> None:
        if self.camera is None or self.lettore is None:
            log.warning("mirino senza camera: non c'è niente da inquadrare")
            return
        # Prima si chiude quello che c'era: un racconto che continua a parlare
        # mentre lo schermo mostra il mirino è un dispositivo in due posti.
        self._ferma_racconto()
        self._bottiglia_chiusa = False
        # «La bottiglia non c'e' piu'» e' proprio la notizia giusta: e' il modo
        # in cui si dichiara che il giro e' finito, e riporta in attesa da
        # qualunque stato. Non serve una scorciatoia che gli somigli.
        self.macchina.invia(Evento.BOTTIGLIA_ASSENTE)
        try:
            self.ponte.luce(LUCE)
        except (PonteNonDisponibile, ErroreMCU):
            pass
        if self.mirino is None:
            # Il mirino apre il SUO lettore e il SUO matcher. Prestargli quelli
            # del dispositivo sembrerebbe un risparmio, ed e' una corsa: se
            # una scansione e' ancora in corso quando si accende il mirino, due
            # fili finiscono dentro allo stesso motore ONNX e alla stessa
            # connessione SQLite. Vedi `LetturaContinua`.
            self.mirino = Mirino(self.camera, LetturaContinua(),
                                 presenza=self.presenza)
        self.mirino.accendi()

    def _spegni_mirino(self) -> None:
        if self.mirino is not None:
            self.mirino.spegni()
        # Lo stream si chiude: la prima sbirciata lo riaccende, e cosi' la
        # camera riparte pulita invece che da uno stream che il mirino stava
        # leggendo a raffica.
        if self.camera is not None:
            self.camera.chiudi()
        # Il piatto vuoto si ripesca da dove sta scritto, invece di
        # reimpararlo da quello che c'e' davanti adesso. Chi tara il mirino ha
        # una bottiglia in mano: reimparando, quella bottiglia diventerebbe lo
        # sfondo, e il dispositivo resterebbe a guardarla senza vederla.
        sfondo = self._sfondo_ricordato() if self.camera is not None else None
        if sfondo is not None:
            self.presenza.ricorda(sfondo)
        else:
            self.presenza.reimposta()
        # E si torna alla schermata dello stato in cui si e', che il mirino
        # copriva. Se sul piatto c'e' una bottiglia - e chi tara l'inquadratura
        # ce l'ha davanti per definizione - non serve chiedere niente: il
        # sensore la vede, e il battito la rilegge da solo (vedi
        # `_un_battito`). E' cio' che chi ha appena spostato la camera vuole:
        # la prova che l'aggiustamento ha funzionato, senza doverla chiedere.
        self._mostra(self.macchina.stato)

    def _stato_mirino(self) -> dict[str, Any]:
        acceso = self.mirino is not None and self.mirino.acceso
        return {"ok": True, "acceso": acceso,
                "disponibile": self.camera is not None and self.lettore is not None,
                "nitidezza": round(self.mirino.nitidezza) if acceso else 0}

    def _manda_mirino(self) -> None:
        self._pubblica({"tipo": "mirino", **self._stato_mirino()})

    # -------------------------------------------------------- giornale

    def _annota(self, esito: str) -> None:
        """Mette a giornale la scansione appena conclusa, com'è andata.

        Si chiama dove la scansione FINISCE - senza niente da leggere, senza
        riscontro, con un racconto pronto, con una correzione salvata, o chiusa
        a metà - e l'esito dice quale. Quello che si sa si è accumulato per
        strada in `_scansione`.
        """
        voce = dict(self._scansione)
        self._scansione = {}
        if not voce:
            return
        voce["esito"] = esito
        voce["lingua"] = self.lingua
        self.giornale.annota(voce, getattr(self, "_ultimo_scatto", None))

    def _manda_impostazioni(self) -> None:
        self._pubblica({"tipo": "impostazioni",
                        "modo": self.modo,
                        # Un modo che non si puo' servire non si mostra: un
                        # comando che non fa niente e' peggio di nessun comando.
                        "modi": [m for m in MODI if self._modo_servibile(m)],
                        "generati": self.genera_racconti,
                        "correzioni": self.correzioni_attive,
                        # Senza un modello acceso l'interruttore non si mostra:
                        # un comando che non fa niente e' peggio di nessun
                        # comando. E' lo stesso criterio del volume senza voce.
                        "modello": self.narratore.genera is not None,
                        # Il livello della batteria viaggia anche qui perche'
                        # questo messaggio arriva a ogni pagina che si collega:
                        # la spia di salute passa ogni venti secondi, e venti
                        # secondi di icona vuota all'accensione sono un
                        # allarme falso.
                        "batteria": self._batteria_a_schermo()})

    def _modo_servibile(self, modo: str) -> bool:
        if modo == "carta":
            return self.carta is not None
        if modo == "generativa":
            return self.narratore.genera is not None
        return True

    def imposta_volume(self, valore: int) -> int:
        """Il livello scelto col cursore del volume. Restituisce quello effettivo."""
        nuovo = max(0, min(100, int(valore)))
        if nuovo == self.volume:
            # Ridare il livello che c'e' gia' - il cursore in fondo, toccato di
            # nuovo - non cambia niente, ma il colpetto si fa lo stesso: senza,
            # il tocco sembrerebbe perso invece che arrivato in fondo.
            self._programma_colpetto()
            return self.volume
        self.volume = nuovo
        if self.voce is not None:
            self.voce.volume = nuovo
        self._salva_volume(nuovo)
        self._manda_volume()
        self._programma_colpetto()
        return nuovo

    def _manda_volume(self) -> None:
        self._pubblica({"tipo": "volume", "valore": self.volume,
                        # Senza voce del tutto il comando non si mostra: un
                        # livello che non muove niente e' peggio di nessun
                        # livello.
                        "attivo": self.voce is not None})

    def _programma_colpetto(self) -> None:
        """Fa sentire il livello, ma solo quando la mano si e' fermata."""
        with self._lucchetto_volume:
            if self._rinvio_colpetto is not None:
                self._rinvio_colpetto.cancel()
            t = threading.Timer(RIPOSO_VOLUME_S, self._colpetto)
            t.daemon = True
            self._rinvio_colpetto = t
            t.start()

    def _colpetto(self) -> None:
        """Il ritorno sonoro del volume, se non c'e' gia' qualcosa da sentire.

        Mentre il dispositivo racconta o annuncia una lingua il livello si sente
        gia' da solo, e un colpetto in mezzo a una frase sarebbe un disturbo.
        """
        if self.voce is None or self._annunciatore_vivo:
            return
        with self._lucchetto_lettore:
            occupato = self._lettore is not None
        if occupato:
            return
        self.voce.colpetto()

    def _voce_disponibile(self) -> bool:
        """C'e' una voce per la lingua a schermo?

        Non e' la stessa cosa che «l'audio funziona»: la voce puo' esserci e
        l'altoparlante no. Qui si risponde solo alla prima domanda, che e'
        quella che cambia col tocco dell'ospite.
        """
        return self.voce is None or getattr(
            self.voce, "disponibile_per_lingua", True)

    def cambia_lingua(self, codice: str) -> bool:
        """L'ospite ha toccato la bandierina.

        Il dispositivo RISPONDE A VOCE - «Lingua italiana», «English language» -
        e solo dopo, se un racconto era in corso, lo rifà nella lingua nuova.
        L'annuncio non è un vezzo: è la conferma che la lingua è cambiata *e*
        che l'audio funziona, ed è il modo più rapido di provare amplificatore
        e casse senza appoggiare una bottiglia.

        Il racconto riparte SUBITO nella lingua nuova, senza chiedere di
        rimettere la bottiglia: i fatti sono già in mano e si portano dietro
        tutte le lingue proprio per questo.
        """
        if codice not in self.lex.lingue:
            return False

        if codice == self.lingua:
            # Toccare la lingua già attiva non cambia niente, ma l'annuncio si
            # fa lo stesso: è l'unico modo di riprovare l'audio con un tocco
            # solo, invece di dover alternare avanti e indietro.
            self._parla_dopo(annuncia=True, riprendi=False)
            return False

        log.info("lingua: %s -> %s", self.lingua, codice)
        self.lingua = codice
        self.narratore.lingua = codice
        if self.voce is not None:
            self.voce.per_lingua(codice)
        self._manda_lingua()
        self._mostra(self.macchina.stato)

        riprendi = self.macchina.stato in (Stato.RACCONTO, Stato.CONCLUSO)
        if riprendi:
            self._ferma_racconto()
        if self.macchina.stato is Stato.CONCLUSO:
            # Il racconto riparte solo dopo l'annuncio: senza allungare la
            # schermata finale, questa scadrebbe prima, si tornerebbe
            # all'invito e il racconto nella lingua nuova non ripartirebbe
            # piu'. Un tetto resta, se il racconto per qualche ragione non
            # riparte.
            self._scadenza = time.monotonic() + LINGUA_A_RACCONTO_FINITO_S
        self._parla_dopo(annuncia=True, riprendi=riprendi)
        return True

    def _parla_dopo(self, *, annuncia: bool, riprendi: bool) -> None:
        """Annuncia e semmai fa ripartire il racconto, fuori dal filo HTTP.

        Sono cose lente - una sintesi, l'attesa di un thread - e chi ha toccato
        lo schermo non deve aspettarle: il tocco deve rispondere subito.
        """
        if annuncia:
            self._chiedi_annuncio(self.lingua)
        if riprendi:
            threading.Thread(target=self._riprendi_racconto, daemon=True).start()

    def _chiedi_annuncio(self, lingua: str) -> None:
        """Chiede di annunciare una lingua, SUBITO, tagliando quella in corso.

        Chi tocca una bandierina mentre il dispositivo sta annunciando l'altra
        ha cambiato idea: sentirsi finire la frase di prima, e solo dopo quella
        chiesta, fa sembrare il tocco perso.

        Interrompere funziona perche' il flusso audio resta APERTO (vedi
        `speech.Uscita`). Il DSP di questa board impiega due secondi ad
        avviarsi: con un flusso aperto e chiuso a ogni frase, una frase da un
        secondo sparirebbe dentro quei due, gli annunci si taglierebbero a
        vicenda e non si sentirebbe NIENTE, come un guasto dell'amplificatore.
        Col flusso aperto, interrompere fa esattamente quello che sembra: tace
        e riparte.
        """
        with self._lucchetto_annuncio:
            self._lingua_da_annunciare = lingua
            gia_in_corso = self._annunciatore_vivo
            self._annunciatore_vivo = True
        if gia_in_corso:
            # Si butta via cio' che non e' ancora uscito: l'annuncio in corso
            # smette di aspettare la propria coda e torna, e il ciclo trova
            # subito la lingua nuova.
            if self.voce is not None:
                self.voce.zittisci()
            self._didascalia("")
            return
        threading.Thread(target=self._ciclo_annunci, daemon=True).start()

    def _ciclo_annunci(self) -> None:
        while True:
            with self._lucchetto_annuncio:
                lingua = self._lingua_da_annunciare
                self._lingua_da_annunciare = None
                if lingua is None:
                    self._annunciatore_vivo = False
                    return
            self._annuncia_lingua(lingua)

    def _riprendi_racconto(self) -> None:
        # Il thread del racconto vecchio deve essere USCITO prima di chiedere
        # quello nuovo: se ne trova uno vivo, `_avvia` mette il nuovo in coda
        # dietro al vecchio, e se il vecchio non esce in tempo dichiara guasto.
        # Un cambio di lingua non deve mai finire cosi'.
        self._attendi_lavoro(5.0)
        # E l'annuncio deve aver FINITO DI PARLARE. Scrivono tutti e due nello
        # stesso flusso audio: partendo insieme, «English language» e la prima
        # frase del racconto uscirebbero sovrapposte, e non si capirebbe ne'
        # l'una ne' l'altra. L'ordine giusto e' quello che ci si aspetta
        # sentendolo: prima la lingua, poi il vino in quella lingua.
        self._attendi_annuncio(6.0)
        self.macchina.invia(Evento.RIPETI)

    def _attendi_annuncio(self, secondi: float) -> None:
        """Aspetta che l'annunciatore abbia smesso di parlare. Mai per sempre."""
        scadenza = time.monotonic() + secondi
        while self._annunciatore_vivo and time.monotonic() < scadenza:
            time.sleep(0.05)

    def _prepara(self) -> None:
        """Scalda le voci, e in ogni caso dichiara finita la preparazione.

        La rete di sicurezza sotto la schermata d'avvio: se il caricamento va
        storto - un modello mancante, il disco pieno - il dispositivo deve
        arrivare comunque alla sua schermata e dire li' cosa non va, invece di
        restare sul marchio a tempo indeterminato senza spiegare niente.
        """
        try:
            self._scalda_voci()
        finally:
            self._pronta = True
            # Il respiro dell'accensione dice «mi sto avviando»: da pronti, la
            # luce e' quella fissa dell'attesa, senza aspettare la prima
            # bottiglia per prendere il comando.
            if self.macchina.stato is Stato.ATTESA:
                self._esegui(Effetto.ANELLO_RESPIRO)

    def _scalda_voci(self) -> None:
        """Carica le voci e pre-sintetizza le frasi che si dicono sempre.

        L'annuncio della lingua è una frase fissa, e sintetizzarla al momento
        costerebbe un secondo di silenzio proprio dopo il tocco: la si mette in
        cache all'avvio, dove il tempo non lo vede nessuno.
        """
        if self.voce is None:
            self._pronta = True
            return
        # Il flusso audio si apre ADESSO e non si chiude piu'. Il DSP di questa
        # board impiega circa due secondi a cominciare a rendere il suono dopo
        # l'apertura, e pagarli qui - all'accensione, mentre nessuno ascolta -
        # e' l'unico modo perche' ogni frase dopo esca all'istante.
        try:
            self.voce.uscita()
        except Exception as e:                              # noqa: BLE001
            log.warning("uscita audio non aperta: %s", e)
        self.voce.scalda()
        for lingua in self.lex.lingue:
            frase = self.lex.frase("voce", "conferma_lingua", lingua=lingua)
            if not frase or not self.voce.per_lingua(lingua):
                continue
            # Una frase per volta, come le dice `_annuncia_lingua`: la cache e'
            # per frase, e l'annuncio intero come chiave non servirebbe a
            # niente - il primo tocco sintetizzerebbe al momento.
            for pezzo in spezza_in_frasi(frase):
                try:
                    self.voce.sintetizza(pezzo)
                except Exception as e:                      # noqa: BLE001
                    log.warning("frase fissa non pre-sintetizzata (%s): %s",
                                lingua, e)
        self.voce.per_lingua(self.lingua)      # si torna alla lingua a schermo
        # Da adesso il dispositivo e' pronto davvero: le voci sono in memoria e
        # la prima frase esce subito. La schermata d'avvio aspetta questo, non
        # il server che risponde: fra le due cose ci sono trenta secondi di
        # caricamento, e sono esattamente quelli in cui il dispositivo sembra
        # pronto e non lo e'.
        self._pronta = True

    def _annuncia_lingua(self, lingua: str | None = None) -> None:
        lingua = lingua or self.lingua
        frase = self.lex.frase("voce", "conferma_lingua", lingua=lingua)
        if not frase or self.voce is None:
            return
        # La voce si allinea qui: fra il tocco e il turno di parola la lingua
        # puo' essere gia' cambiata di nuovo.
        if not self.voce.per_lingua(lingua):
            return
        log.info("annuncio [%s]: %r", lingua, frase)
        try:
            # Le frasi si dicono una per volta perche' la didascalia le segua:
            # una frase intera a schermo mentre se ne sente mezza non e'
            # sincronia, e' un sottotitolo scritto in anticipo.
            self.voce.parla(spezza_in_frasi(frase), su_frase=self._didascalia)
        except Exception as e:                              # noqa: BLE001
            log.warning("annuncio della lingua non riuscito: %s", e)
        finally:
            self._didascalia("")
            # Si torna alla lingua a schermo, che puo' essere un'altra.
            self.voce.per_lingua(self.lingua)

    def _didascalia(self, testo: str) -> None:
        """Che cosa il dispositivo sta dicendo, adesso."""
        self._pubblica({"tipo": "didascalia", "testo": testo})

    def _ferma_racconto(self) -> None:
        """Ferma la riproduzione in corso e chi la stava aspettando.

        La bandiera si alza SOTTO il lucchetto del riproduttore, non prima: e'
        cio' che rende impossibile passare fra il controllo e l'assegnazione in
        `_racconta` e lasciar partire un racconto gia' annullato.
        """
        with self._lucchetto_lettore:
            self._ferma_voce.set()
            lettore, self._lettore = self._lettore, None
        if lettore is not None:
            lettore.ferma()
        if self.voce is not None:
            self.voce.zittisci()

    # ------------------------------------------------------------ ripristino

    def _conta_il_guasto(self) -> None:
        ora = time.monotonic()
        self._guasti = [t for t in self._guasti if ora - t < FINESTRA_GUASTI_S] + [ora]
        if len(self._guasti) >= GUASTI_PER_RIPRISTINO and self._da_ripristinare is None:
            log.warning("%d guasti in %.0f s: ripristino al prossimo battito",
                        len(self._guasti), FINESTRA_GUASTI_S)
            self._da_ripristinare = f"{len(self._guasti)} guasti di fila"

    def _ripristina_da_solo(self, motivo: str) -> None:
        """Il primo passo e' il ripristino; se i guasti tornano subito, il
        riavvio del servizio."""
        if (self._ultimo_ripristino is not None
                and time.monotonic() - self._ultimo_ripristino < DOPO_RIPRISTINO_S):
            self.riavvia_servizio(f"{motivo}, anche dopo un ripristino")
            return
        self.ripristina(motivo)

    def ripristina(self, motivo: str = "a mano") -> dict[str, Any]:
        """Rimette in moto il dispositivo senza spegnerlo.

        Contro un guasto che si ripete rifa', pezzo per pezzo, cio' che
        farebbe staccare la corrente:

        - si ferma il racconto, l'annuncio e l'editor aperto;
        - il lavoro in corso ha cinque secondi per uscire, e se non esce lo si
          lascia andare: un thread non si uccide, ma non deve piu' tenere
          occupata la pipeline (vedi `_avvia`, che con un lavoro «in corso»
          dichiara guasto a ogni bottiglia);
        - la camera torna come all'accensione: stream spento, posa di
          partenza, device ricercato. E' il pezzo che conta di piu': una posa
          che ferma la camera basta a tenere il dispositivo in guasto per ore
          (vedi `ImpostazioniCamera.posa_massima`);
        - l'uscita audio si chiude e si riapre;
        - la connessione col router si chiude, e la prossima chiamata la riapre;
        - col modo generativo, il modello si riavvia;
        - i contatori dei tentativi si azzerano, e si torna all'invito: una
          bottiglia gia' sul piatto si rilegge.

        Lo si chiama dalle impostazioni, o da soli dopo tre guasti in tre
        minuti (vedi `_conta_il_guasto`).
        """
        log.warning("ripristino (%s)", motivo)
        self._ultimo_ripristino = time.monotonic()
        self._guasti.clear()
        self._scadenza = None
        self._ferma_racconto()
        with self._lucchetto_annuncio:
            self._lingua_da_annunciare = None
        if self._correggendo is not None:
            self._correggendo = None
            self._pubblica({"tipo": "correzione", "aperta": False})
        if self.mirino is not None and self.mirino.acceso:
            self._spegni_mirino()
        self._attendi_lavoro(5.0)
        lavoro = self._lavoro
        if (lavoro is not None and lavoro.is_alive()
                and lavoro is not threading.current_thread()):
            log.warning("il lavoro non e' uscito: lo si lascia andare")
            self._lavoro = None
        if self.camera is not None:
            try:
                self.camera.ripristina()
            except Exception as e:                          # noqa: BLE001
                log.warning("camera non ripristinata: %s", e)
        if self.voce is not None:
            try:
                self.voce.chiudi()
                self.voce.uscita()
            except Exception as e:                          # noqa: BLE001
                log.warning("uscita audio non riaperta: %s", e)
        try:
            self.ponte.chiudi()
        except Exception as e:                              # noqa: BLE001
            log.warning("connessione col router non chiusa: %s", e)
        if self.modo == "generativa":
            self._accendi_il_modello(True, riavvia=True)
        self._tentativi = 0
        self._bottiglia_chiusa = False
        self._cambiata_durante_il_racconto = False
        self._annulla_anticipo()
        self.macchina.reimposta()
        self._mostra(Stato.ATTESA)
        for e in EFFETTI_INGRESSO[Stato.ATTESA]:
            self._esegui(e)
        return {"ok": True, "motivo": motivo}

    def riavvia_servizio(self, motivo: str) -> None:
        """L'ultimo passo prima di spegnere: il processo esce, e systemd lo
        riavvia (Restart=always) in una quarantina di secondi, voci comprese.
        Solo sotto systemd - che lo fa sapere con INVOCATION_ID -: lanciato a
        mano, uscire vorrebbe dire spegnersi e basta, e si ripristina e basta."""
        import os
        if not os.environ.get("INVOCATION_ID"):
            log.warning("riavvio chiesto (%s) ma non sotto systemd: ripristino", motivo)
            self.ripristina(motivo)
            return
        log.error("riavvio del servizio: %s", motivo)
        self._ferma_racconto()
        if self.camera is not None:
            try:
                self.camera.chiudi()
            except Exception:                               # noqa: BLE001
                pass
        os._exit(75)

    def _attendi_lavoro(self, secondi: float) -> None:
        """Aspetta che il thread di lavoro esca. Mai se stessi."""
        lavoro = self._lavoro
        if lavoro is not None and lavoro is not threading.current_thread():
            lavoro.join(timeout=secondi)
            if lavoro.is_alive():
                log.warning("il lavoro precedente non è uscito in %.0f s", secondi)

    # -------------------------------------------------------------- effetti

    def _luce_per(self, effetto: Effetto) -> Luce:
        """La luce di un effetto, adesso.

        L'attesa e' l'unico stato in cui la luce dice anche come sta la
        batteria: e' quando il dispositivo e' fermo sul tavolo e chi lavora in
        sala lo guarda passando. Negli stati della lettura resta bianca e
        gialla anche a batteria scarica, perche' illumina l'etichetta.
        """
        if effetto is Effetto.ANELLO_RESPIRO and self.batteria.scarica:
            return LUCE_ROSSA
        return LUCE_ANELLO[effetto]

    def _ricontrolla_la_luce(self) -> None:
        """Rimette la luce dello stato se la batteria e' diventata scarica, o e'
        stata ricaricata, mentre il dispositivo era fermo in attesa: senza un
        cambio di stato nessuno la riaccenderebbe del colore giusto."""
        scarica = self.batteria.scarica
        if scarica == self._batteria_era_scarica:
            return
        self._batteria_era_scarica = scarica
        if scarica:
            log.warning("batteria quasi scarica: in attesa la luce e' rossa")
        if self.macchina.stato is Stato.ATTESA:
            self._esegui(Effetto.ANELLO_RESPIRO)

    def _esegui(self, e: Effetto) -> None:
        try:
            if e in LUCE_ANELLO:
                self.ponte.luce(self._luce_per(e))
            elif e is Effetto.ILLUMINA_E_SCATTA:
                self._avvia(self._scatta_e_leggi)
            elif e is Effetto.INTERROGA_DATABASE:
                self._avvia(self._riconosci)
            elif e is Effetto.AVVIA_RACCONTO:
                # Lo stream della camera si spegne PRIMA di parlare. Con il
                # DisplayPort attivo il link USB scende a 2.0 e camera e audio
                # si dividono un bus solo: la camera resta accesa per guardare
                # il piatto, ma non mentre si parla. Si riaccende da sola alla
                # prima sbirciata dopo il racconto.
                if self.camera is not None:
                    self.camera.chiudi()
                self._avvia(self._racconta)
            elif e is Effetto.FERMA_RACCONTO:
                # Non una copia: la fermata e' UNA, e alza la bandiera DENTRO
                # il lucchetto del riproduttore. Una seconda copia qui - la via
                # dell'annullamento e del cambio di bottiglia - che la alzasse
                # fuori riaprirebbe la finestra descritta in `_racconta`. Una
                # sola copia, un solo invariante.
                self._ferma_racconto()
        except Exception as ex:                             # noqa: BLE001
            # Un effetto che fallisce non deve MAI fermare la macchina a stati:
            # un errore dell'MCU deve costare un anello spento, non il
            # dispositivo.
            log.warning("effetto %s fallito: %s", e.value, ex)

    def _avvia(self, funzione) -> None:
        """Esegue in un thread. Uno alla volta: la pipeline è sequenziale."""
        # Il passo successivo della pipeline viene avviato DAL thread di lavoro
        # stesso: _scatta_e_leggi manda LETTURA_RIUSCITA, che innesca
        # INTERROGA_DATABASE, che richiama _avvia mentre siamo ancora dentro
        # quel thread. Confrontare con `is_alive()` senza escludere il chiamante
        # significa trovarsi sempre occupati, e quindi non raccontare mai nulla.
        occupato = (self._lavoro is not None
                    and self._lavoro.is_alive()
                    and self._lavoro is not threading.current_thread())
        if occupato:
            # Succede quando la bottiglia «sparisce» per un istante durante una
            # lettura e torna: la lettura precedente sta ancora finendo, e
            # subito dopo un riavvio - OCR da caricare, tre secondi di scatto -
            # capita spesso. Non e' un guasto: si aspetta che finisca, in un
            # thread per non fermare il battito; se non finisce, e solo
            # allora, e' un guasto. Ignorare e basta lascerebbe la macchina ad
            # aspettare un evento che nessuno mandera' mai.
            precedente, stato = self._lavoro, self.macchina.stato
            self._lavoro = threading.Thread(
                target=self._dopo_il_precedente, args=(precedente, stato, funzione),
                daemon=True)
            self._lavoro.start()
            return
        self._lavoro = threading.Thread(target=self._protetto, args=(funzione,),
                                        daemon=True)
        self._lavoro.start()

    def _dopo_il_precedente(self, precedente, stato, funzione) -> None:
        precedente.join(timeout=ATTESA_DEL_LAVORO_S)
        if precedente.is_alive():
            log.warning("lavoro già in corso da troppo, dichiaro guasto invece di %s",
                        funzione.__name__)
            self.macchina.invia(Evento.ERRORE)
            return
        if self.macchina.stato is not stato:
            # Nel frattempo la bottiglia e' stata tolta, o si e' annullato:
            # quel lavoro non lo aspetta piu' nessuno.
            return
        self._protetto(funzione)

    def _protetto(self, funzione) -> None:
        try:
            funzione()
        except Exception:                                   # noqa: BLE001
            log.exception("errore in %s", funzione.__name__)
            self.macchina.invia(Evento.ERRORE)

    # ------------------------------------------------------------- pipeline

    # ------------------------------------------------------- cambio bottiglia

    def _anticipa(self) -> None:
        """Una bottiglia e' arrivata mentre si raccontava la precedente.

        La si legge subito, SENZA fermare la voce: quando la bottiglia cambia,
        la descrizione deve cambiare subito, e per non far pesare l'attesa si
        comincia a leggere la nuova mentre si sta ancora parlando della
        vecchia. Ma sollevarla per versare e rimetterla e' il gesto piu' comune
        di un tavolo, e interrompere li' vorrebbe dire ricominciare da capo la
        storia che si stava ascoltando.

        Quindi si decide prima di interrompere, e si decide in fretta dove si
        puo'. La foto dice «e' la stessa» in un secondo circa, quando ritrova
        abbastanza punti dell'etichetta di prima (`STESSA_A_OCCHIO`); «e'
        un'altra» invece non lo sa dire, e lo dice il testo, qualche secondo
        dopo: le parole lette, e cosa se ne riconosce. Solo allora la voce
        tace e parte la bottiglia nuova, gia' letta - la scansione non rifa'
        niente, vedi `_scatta_e_leggi`.

        Se dalla lettura non si capisce niente - nessuna parola - si lascia
        finire il racconto, e la bottiglia si rilegge a racconto finito.
        """
        if self.camera is None or self.lettore is None:
            return
        self._annulla_anticipo()
        a = _Anticipo(apparsa=self._apparsa)
        self._anticipo = a
        threading.Thread(target=self._leggi_in_anticipo, args=(a,),
                         name="anticipo", daemon=True).start()

    def _annulla_anticipo(self) -> None:
        """La bottiglia letta in anticipo non c'e' piu': se ne dimentica tutto."""
        a, self._anticipo = self._anticipo, None
        if a is not None:
            a.annullata.set()
        self._anticipata = None

    def _prendi_anticipata(self) -> _Anticipo | None:
        """La lettura fatta in anticipo, se c'e' ed e' ancora buona. Una volta sola."""
        a, self._anticipata = self._anticipata, None
        if (a is None or a.annullata.is_set() or a.lettura is None
                or time.monotonic() - a.letta > ANTICIPO_VALIDO_S):
            return None
        return a

    def _leggi_in_anticipo(self, a: _Anticipo) -> None:
        try:
            self._decidi_in_anticipo(a)
        except Exception:                                   # noqa: BLE001
            # Una lettura in anticipo che fallisce non costa niente di piu': la
            # bottiglia si rilegge a racconto finito.
            log.exception("lettura in anticipo")
        finally:
            if self._anticipo is a:
                self._anticipo = None

    def _decidi_in_anticipo(self, a: _Anticipo) -> None:
        # Il tempo perche' la mano esca dall'inquadratura, come nell'assestamento.
        if a.annullata.wait(DURATE_S[Stato.ASSESTAMENTO]):
            return
        inizio = time.perf_counter()
        self.camera.sorveglia()
        scatto = self.camera.al_volo(dopo=a.apparsa, attesa=1.5)
        if scatto is None:
            try:
                scatto = self.camera.scatta()
            except CameraNonDisponibile as e:
                log.warning("lettura in anticipo senza camera: %s", e)
                return
        a.durata_scatto = time.perf_counter() - inizio
        if self.macchina.stato in (Stato.RACCONTO, Stato.CONCLUSO):
            # Mentre si parla lo stream resta spento, e la foto c'e' gia'.
            # Vedi `_va_sorvegliata`.
            self.camera.chiudi()
        if a.annullata.is_set():
            return
        a.scatto = scatto
        punti = self.correzioni.punti_in_comune(
            getattr(self, "_ultimo_scatto", None), self._righe_lette, scatto.immagine)
        if punti >= STESSA_A_OCCHIO:
            self._e_la_stessa(f"{punti} punti dell'etichetta ritrovati")
            return
        try:
            a.lettura, a.allargata = self._leggi_scatto(scatto)
        except OCRNonDisponibile as e:
            log.warning("lettura in anticipo senza OCR: %s", e)
            return
        a.letta = time.monotonic()
        if a.annullata.is_set():
            return
        altra = self._e_un_altra(a.lettura,
                                 scatto.immagine if a.allargata is None else a.allargata)
        if altra is None:
            log.info("bottiglia rimessa: dalla lettura non si capisce se e' un'altra, "
                     "la si rileggera' a racconto finito")
            if self.macchina.stato in (Stato.CONCLUSO, Stato.ATTESA):
                # Il racconto e' gia' finito: la bottiglia si rilegge adesso.
                self._bottiglia_chiusa = False
            return
        if not altra:
            self._e_la_stessa("le stesse parole")
            return
        log.info("un'altra bottiglia sul piatto: il racconto si ferma e parte la nuova")
        self._anticipata = a
        self._cambiata_durante_il_racconto = False
        # Se il racconto e' gia' finito e si e' tornati all'invito, il cambio
        # non ha piu' niente da interrompere e la macchina lo ignora: la
        # bottiglia la raccoglie il rilancio del battito, che trova la lettura
        # pronta. Senza questa riga resterebbe segnata come gia' raccontata.
        self._bottiglia_chiusa = False
        self._tentativi = 0
        self.macchina.invia(Evento.CAMBIO_BOTTIGLIA)

    def _e_la_stessa(self, perche: str) -> None:
        """La bottiglia rimessa sul piatto e' quella di prima: non si rilegge."""
        log.info("la bottiglia rimessa sul piatto e' la stessa (%s): il racconto continua",
                 perche)
        self._cambiata_durante_il_racconto = False
        if self.macchina.stato in (Stato.CONCLUSO, Stato.ATTESA):
            # Il racconto e' gia' finito, e la bottiglia e' quella raccontata.
            self._bottiglia_chiusa = True

    def _e_un_altra(self, lettura, immagine) -> bool | None:
        """La bottiglia letta in anticipo e' un'altra? `None` se non si capisce.

        Prima le parole, con la regola delle correzioni: le stesse parole
        identificanti rilette sono la stessa etichetta. Poi quello che se ne
        riconosce: due etichette diverse dello stesso vino - fronte e retro -
        raccontano la stessa storia, e non c'e' niente da interrompere.
        """
        from .correzioni import REGOLA, parole_identificanti, parole_in_comune

        righe = [r.testo for r in lettura.righe]
        nuove = parole_identificanti(righe)
        if not nuove:
            return None
        quota, prese = parole_in_comune(
            parole_identificanti(getattr(self, "_righe", [])), nuove)
        if prese >= REGOLA.parole_minime and quota >= REGOLA.parole:
            return False
        prima = self._chiave_attuale()
        return prima is None or prima != self._chiave_di(righe, lettura.righe, immagine)

    def _chiave_attuale(self) -> tuple | None:
        """Che cosa si sta raccontando, in una forma che si puo' confrontare."""
        if self._correzione is not None:
            return ("correzione", self._correzione.id)
        if self.modo == "carta" and self._voce is not None:
            return ("carta", self._voce.titolo)
        f = self._fatti
        return ("archivio", tuple(f.origine)) if f.origine and not f.vuoto else None

    def _chiave_di(self, righe, righe_lette, immagine) -> tuple | None:
        """Che cosa si racconterebbe di questa lettura: la stessa strada di
        `_riconosci`, senza toccare niente di quello che si sta raccontando."""
        try:
            r = self.correzioni.cerca(righe_lette, immagine)
        except Exception as e:                              # noqa: BLE001
            log.warning("correzioni: confronto non riuscito (%s)", e)
            r = None
        if r is not None:
            return ("correzione", r.correzione.id)
        if self.modo == "carta" and self.carta is not None:
            v = self.carta.cerca(righe)
            return ("carta", v.titolo) if v is not None else None
        f = self.matcher.cerca(righe)
        if f.dubbio:
            f = self.matcher.il_piu_generico(f, righe)
        return ("archivio", tuple(f.origine)) if f.origine and not f.vuoto else None

    def _scatta_e_leggi(self) -> None:
        if self.camera is None or self.lettore is None:
            self.macchina.invia(Evento.LETTURA_FALLITA)
            return
        # La bottiglia cambiata a racconto in corso e' gia' stata fotografata e
        # letta, mentre la voce parlava ancora della precedente: rifarlo
        # vorrebbe dire far aspettare di nuovo quello che si e' gia' pagato.
        anticipata = self._prendi_anticipata()
        if anticipata is not None:
            self._dopo_la_lettura(anticipata.scatto, anticipata.lettura,
                                  anticipata.allargata, anticipata.durata_scatto,
                                  anticipata=True)
            return
        # La luce dello scatto è quella di sempre, già accesa dallo stato: la
        # raffica non la alza e non la rimette. Cambiarla proprio adesso
        # renderebbe sbagliata la posa che la camera ha trovato a riposo, e lo
        # scatto si pagherebbe con una ricerca della luce a bottiglia posata.
        # In ogni via d'errore la luce la decide la macchina a stati, che è
        # l'unica a sapere dove si sta andando.
        inizio_scatto = time.perf_counter()
        scatto = self.camera.al_volo(dopo=self._apparsa)
        if scatto is None:
            try:
                scatto = self.camera.scatta()
            except CameraNonDisponibile as e:
                log.error("camera: %s", e)
                self.macchina.invia(Evento.ERRORE)
                return

        durata_scatto = time.perf_counter() - inizio_scatto
        try:
            lettura, allargata = self._leggi_scatto(scatto)
        except OCRNonDisponibile as e:
            log.error("OCR: %s", e)
            self.macchina.invia(Evento.ERRORE)
            return
        self._dopo_la_lettura(scatto, lettura, allargata, durata_scatto)

    def _leggi_scatto(self, scatto):
        """L'OCR su uno scatto: la lettura, e l'immagine allargata se serviva."""
        # Il guardiano si ferma per il tempo della lettura: il fotogramma
        # buono c'e' gia', e decodificare MJPEG mentre l'OCR gira
        # vuol dire toglierle un core su quattro.
        with self.camera.in_pausa():
            lettura = self.lettore.leggi_comunque(scatto.immagine)
            allargata = None
            if scatto.intero is not None:
                # Una riga che tocca il bordo del ritaglio e' un'etichetta
                # tagliata: si rilegge piu' largo. Vedi `Lettore.allarga`.
                lettura, allargata = self.lettore.allarga(
                    lettura, scatto.intero, scatto.posto)
        return lettura, allargata

    def _dopo_la_lettura(self, scatto, lettura, allargata, durata_scatto: float,
                         *, anticipata: bool = False) -> None:
        """Quello che si e' letto diventa la bottiglia sul piatto, e si va avanti."""
        self._righe = [r.testo for r in lettura.righe]
        self._righe_lette = list(lettura.righe)
        # Si tiene l'ultimo scatto: e' la foto che una correzione a mano
        # conserva, e l'unica cosa che permette di capire un errore dopo. Se
        # si e' riletto piu' largo, e' quella allargata: e' li' che stanno le
        # righe lette, ed e' quella che l'OCR ha guardato davvero.
        self._ultimo_scatto = scatto.immagine if allargata is None else allargata
        log.info("scatto in %.2f s, lette %d righe in %.2f s (nitidezza %.0f)",
                 durata_scatto, len(self._righe), lettura.durata_s,
                 scatto.nitidezza)
        self._scansione = {
            "righe": list(self._righe),
            # Due numeri e non uno: quando la scansione e' lenta, il primo dice
            # se il tempo se n'e' andato davanti alla camera o dentro l'OCR, e
            # da qui non si puo' guardare il dispositivo per capirlo.
            "scatto_s": round(durata_scatto, 2),
            "ocr_s": round(lettura.durata_s, 2),
            "nitidezza": round(scatto.nitidezza),
            "posa": self.camera.imp.esposizione,
            "tentativo": self._tentativi + 1,
        }
        if allargata is not None:
            self._scansione["allargata"] = True
        if anticipata:
            self._scansione["anticipata"] = True
        if lettura.utile:
            self.macchina.invia(Evento.LETTURA_RIUSCITA)
            return
        # Righe senza parole - cifre, frammenti - non sono una lettura: si
        # conta il tentativo, come se non si fosse letto niente, e si chiede di
        # girare l'etichetta. I numeri di un calendario non vanno a cercare un
        # vino nell'archivio.
        self._tentativi += 1
        self._annota("niente da leggere")
        self.macchina.invia(Evento.LETTURA_FALLITA)
        if self._tentativi >= TENTATIVI_MAX:
            # Si e' provato abbastanza: si mostra il messaggio e si tace, invece
            # di riaccendere la luce ogni quattro secondi finche' qualcuno non
            # toglie l'oggetto dal piatto.
            log.info("rinuncio dopo %d tentativi", self._tentativi)
            # E si impara: tre volte con la luce accesa senza trovare una
            # parola vuol dire che quel che si vede non e' un'etichetta. Se lo
            # sfondo era sbagliato - ricaricato da un'altra installazione,
            # imparato con una bottiglia davanti - questo lo rimette a posto:
            # con uno sfondo sbagliato la sagoma della bottiglia non si trova,
            # e all'OCR arriva il ritaglio fisso con dentro mezza stanza.
            if self.camera is not None:
                fascia = self.camera.sbircia()
                if fascia is not None:
                    self.presenza.non_e_una_bottiglia(fascia)
                    # Senza aspettare il riposo: questo e' proprio il caso in
                    # cui lo sfondo su disco e' quello sbagliato, e deve
                    # smettere di esserlo anche dopo un riavvio.
                    self._prossimo_sfondo = 0.0
                    self._ricorda_sfondo()
            self.macchina.invia(Evento.RINUNCIA)

    def _riconosci(self) -> None:
        # Niente di questa bottiglia si eredita dalla precedente. Ogni via
        # riempie una delle due - i fatti dell'archivio o la voce della carta -
        # e l'altra deve restare vuota, perche' lo schermo guarda tutt'e due.
        self._voce = None
        self._fatti = Fatti()
        # Prima di tutto: e' una bottiglia che qualcuno ha corretto a mano? Vale
        # in qualunque modo di racconto - archivio, generativa, carta - perche'
        # chi l'ha scritta ne sa piu' di tutte e tre.
        self._correzione = self._cerca_correzione()
        c = self._correzione
        if c is not None and (self._correzione_parla_ora() or c.riferimento):
            # Il vino a cui e' stata collegata, se c'e'; altrimenti i fatti
            # dell'archivio si cercano lo stesso: se l'ospite cambia lingua e
            # la correzione in quella lingua non c'e', si racconta da li'.
            self._fatti, self._voce = self._della_correzione(c)
            self._candidati = []
            self._scansione.update({
                "livello": "correzione", "sicurezza": 100,
                "correzione": self._correzione.id,
                "titolo": c.titolo()})
            self.macchina.invia(Evento.MATCH_SICURO)
            return
        if self.modo == "carta" and self.carta is not None:
            self._riconosci_dalla_carta()
            return
        self._fatti = self.matcher.cerca(getattr(self, "_righe", []))
        self._candidati = self._fatti.candidati
        log.info("livello %s, sicurezza %.0f", self._fatti.livello.value,
                 self._fatti.sicurezza)
        self._scansione.update({
            "livello": self._fatti.livello.value,
            "sicurezza": round(self._fatti.sicurezza),
            "nome": self._fatti.nome or "",
            "cantina": self._fatti.cantina or "",
            "annata": self._fatti.annata or "",
            # A livello di tipologia o denominazione il `nome` e' vuoto, e
            # senza questi due il giornale direbbe «riconosciuto» senza dire
            # CHE COSA. Il colore sta qui perche' e' il vincolo che non si puo'
            # sbagliare: nessuna descrizione di un bianco vale per un rosato.
            "tipologia": self._fatti.tipologia or "",
            "denominazione": self._fatti.denominazione or "",
            "colore": self._fatti.colore or "",
            "candidati": list(self._candidati),
        })
        if self._fatti.dubbio:
            # Non si chiede all'ospite di scegliere fra tre nomi quasi uguali:
            # si dice il candidato meno specifico, che e' quello che si puo'
            # sostenere. Vedi `Matcher.il_piu_generico`.
            self._fatti = self.matcher.il_piu_generico(
                self._fatti, getattr(self, "_righe", []))
            self._scansione["scelto_il_piu_generico"] = self._fatti.livello.value
        if self._fatti.certo or self._fatti.dubbio:
            self.macchina.invia(Evento.MATCH_SICURO)
        elif self._fatti.vuoto:
            self._annota("letto ma non riconosciuto")
            self._tentativo_fallito()
        else:
            self.macchina.invia(Evento.MATCH_ASSENTE)

    def _cerca_correzione(self):
        """La correzione di questa bottiglia, o None. Non deve mai fermare il giro:
        una correzione illeggibile vale quanto nessuna correzione."""
        try:
            r = self.correzioni.cerca(self._righe_lette,
                                      getattr(self, "_ultimo_scatto", None))
        except Exception as e:                              # noqa: BLE001
            log.warning("correzioni: confronto non riuscito (%s)", e)
            return None
        if r is None:
            return None
        self._scansione["perche_correzione"] = r.perche
        return r.correzione

    def _della_correzione(self, c, righe=None):
        """I fatti, e la voce della carta, della bottiglia a cui una correzione
        e' collegata. Senza collegamento, quelli che l'archivio trova da se'."""
        from .text import estrai_annata
        if righe is None:
            righe = getattr(self, "_righe", [])
        rif = c.riferimento or {}
        if rif.get("tipo") == "archivio":
            try:
                f = self.matcher.fatti_di(rif["ambito"], int(rif["id"]))
            except (KeyError, ValueError, TypeError) as e:
                log.warning("collegamento illeggibile in %s: %s", c.id, e)
            else:
                if not f.vuoto:
                    f.annata = estrai_annata(righe)
                    return f, None
        voce = None
        if rif.get("tipo") == "carta" and self.carta is not None:
            voce = self.carta.voce(rif.get("titolo", ""))
        return self.matcher.cerca(righe), voce

    def _correzione_parla_ora(self) -> bool:
        """C'e' una correzione per questa bottiglia E sa dirla in questa lingua?

        Lo stesso criterio della carta: una descrizione scritta in italiano non
        si legge con la voce inglese, che la storpierebbe. Nell'altra lingua si
        racconta come se la correzione non ci fosse, e lo schermo offre di
        aggiungerla.
        """
        return (self._correzione is not None
                and self._correzione.testo_in(self.lingua) is not None)

    def _azione_correzione(self) -> str | None:
        """Quale pulsante offrire sopra il racconto: correggere, modificare, niente.

        Niente, se l'interruttore «Aggiungi correzioni» e' spento: gli ospiti
        non vedono nessun pulsante per correggere. Acceso, c'e' su OGNI
        racconto, riconosciuto o no: «Modifica» su una bottiglia gia'
        corretta, anche in un'altra lingua, «Correggi» su tutte le altre.
        """
        if not self.correzioni_attive:
            return None
        if self._correzione is not None:
            return "modifica"
        if self._fatti.vuoto and self._voce is None:
            return None
        return "correggi"

    def _niente_raccontato(self) -> bool:
        """Questa bottiglia non e' stata raccontata: non la si e' riconosciuta.

        Non basta guardare i fatti dell'archivio. In modo carta, o con una
        correzione scritta senza collegamento, il racconto viene da li' e i
        fatti possono restare vuoti lo stesso.
        """
        return self._fatti.vuoto and self._voce is None and self._correzione is None

    def _aiuto_possibile(self) -> bool:
        """Si puo' offrire di insegnare questa bottiglia al dispositivo?

        Solo con «Aggiungi correzioni» acceso, come il pulsante di correzione:
        gli ospiti non scrivono descrizioni. E solo se dall'etichetta si e'
        letta almeno una parola che identifica: una correzione si riconosce
        la volta dopo dalle parole e dalla foto insieme, e senza parole non
        si ritroverebbe mai - si insegnerebbe una bottiglia che non tornera'.
        """
        from .correzioni import parole_identificanti
        if not self.correzioni_attive or getattr(self, "_ultimo_scatto", None) is None:
            return False
        return bool(parole_identificanti(getattr(self, "_righe", [])))

    def _tentativo_fallito(self) -> None:
        """Letto, ma senza trovare un vino: si chiede di girare l'etichetta,
        e dopo tre volte si tace finche' la bottiglia non viene tolta.

        Il contatore conta anche le letture senza riscontro. Senza, un'etichetta
        che non si trova in carta verrebbe rifotografata ogni sei secondi
        finche' qualcuno non la toglie: anello e schermo che lampeggiano davanti
        al tavolo, e la CPU a tre di carico.
        """
        self._tentativi += 1
        self.macchina.invia(Evento.LETTURA_FALLITA)
        if self._tentativi >= TENTATIVI_MAX:
            log.info("rinuncio dopo %d tentativi senza riscontro", self._tentativi)
            self.macchina.invia(Evento.RINUNCIA)

    def _riconosci_dalla_carta(self) -> None:
        """Il riconoscimento quando al posto dell'archivio c'e' un file di testo.

        Si cerca il titolo e basta: niente cascata, niente candidati da
        proporre. Una carta dei vini o ce l'ha, quella bottiglia, o non ce
        l'ha - e quando non ce l'ha lo si dice, invece di scendere a qualcosa
        di piu' generico che nel file non esiste.
        """
        righe = getattr(self, "_righe", [])
        self._voce = self.carta.cerca(righe)
        self._candidati = []
        if self._voce is None:
            self._scansione["vicine"] = self.carta.vicine(righe)
            log.info("carta: nessun titolo per %s", righe)
            self._annota("non in carta")
            self._tentativo_fallito()
            return
        self._scansione.update({
            "livello": "carta",
            "sicurezza": round(self._voce.somiglianza),
            "titolo": self._voce.titolo,
        })
        # E si cerca ANCHE in archivio, che costa cinquanta millesimi e parla
        # tutte le lingue. Serve quando l'ospite chiede l'inglese e la carta e'
        # scritta solo in italiano: senza, gli arriverebbe la prima frase
        # tradotta e tutto il resto in italiano, scritto e letto dalla voce
        # inglese.
        self._fatti = self.matcher.cerca(righe)
        self.macchina.invia(Evento.MATCH_SICURO)

    def _aspetta_il_modello(self, secondi: float = 45.0) -> None:
        from .llm import Modello
        if not hasattr(self, "_modello"):
            self._modello = Modello()
        if not self._modello.attendi(secondi):
            log.warning("il modello non risponde: racconto dall'archivio")

    def _si_generera(self) -> bool:
        """Questo racconto passera' dal modello, cioe' fara' aspettare?

        Le stesse condizioni che `Narratore.racconta` applica per primo: il
        modello acceso dalle impostazioni, un modello davvero disponibile, e un
        livello in cui ci sia qualcosa da raccontare. Duplicarle qui non e'
        bello, ma la decisione va presa PRIMA della chiamata che dura secondi,
        e chiederla al narratore vorrebbe dire aver gia' aspettato.
        """
        from .narrator import _abbastanza_per_il_modello
        return (self.genera_racconti
                and self.narratore.genera is not None
                and not self._fatti.vuoto
                and self._fatti.livello is not Livello.GENERICO
                and _abbastanza_per_il_modello(self._fatti))

    def _la_carta_parla_ora(self) -> bool:
        """La carta ha questa bottiglia E sa dirla in questa lingua?

        Due condizioni, e la seconda cambia mentre il dispositivo e' acceso:
        l'ospite tocca la bandierina e la carta, che era la voce giusta un
        istante prima, smette di esserlo.
        """
        return (self._voce is not None
                and self._voce.testo_in(self.lingua) is not None)

    def _racconta_dalla_carta(self):
        """Il racconto e' la descrizione scritta nel file, letta com'e'.

        Davanti si mette il titolo, perche' il dispositivo deve prima dire
        CHE COSA ha in mano: la descrizione lo spiega, ma non lo nomina.
        """
        from .narrator import Racconto, _con_articolo
        from .matcher import Livello

        import zlib

        v = self._voce
        titolo = v.titolo_in(self.lingua)
        # Col seme del titolo, come fa il narratore col vino: stessa voce,
        # stesse parole, e voci diverse non aprono tutte allo stesso modo.
        apre = self.lex.frase("apertura", "tipologia_nota", lingua=self.lingua,
                              seme=zlib.crc32(titolo.encode("utf-8")),
                              cosa=_con_articolo(titolo, self.lingua))
        return Racconto(testo=f"{apre} {v.testo_in(self.lingua)}",
                        origine="carta", livello=Livello.TIPOLOGIA)

    def _racconta_dalla_correzione(self):
        """Il racconto e' quello scritto a mano, detto com'e'.

        Davanti si mette il titolo, come per la carta: il dispositivo deve
        prima dire CHE COSA ha in mano. Non passa dal modello e non passa dalla
        verifica: e' la parola di chi conosce quella bottiglia.
        """
        from .narrator import Racconto, _con_articolo

        import zlib

        t = self._correzione.testo_in(self.lingua)
        apre = self.lex.frase("apertura", "tipologia_nota", lingua=self.lingua,
                              seme=zlib.crc32(t["titolo"].encode("utf-8")),
                              cosa=_con_articolo(t["titolo"], self.lingua))
        return Racconto(testo=f"{apre} {t['descrizione']}", origine="correzione",
                        livello=Livello.TIPOLOGIA)

    def _racconta(self) -> None:
        self._ferma_voce.clear()
        if self._correzione_parla_ora():
            racconto = self._racconta_dalla_correzione()
        elif self._la_carta_parla_ora():
            racconto = self._racconta_dalla_carta()
        else:
            # Generare costa secondi, e in quei secondi lo schermo mostrerebbe
            # il titolo e sotto il vuoto: sembrerebbe rotto. Si dice che si sta
            # scrivendo, e lo si dice PRIMA - non e' una decorazione, e'
            # l'unica differenza fra un dispositivo che lavora e uno fermo.
            if self._si_generera():
                self._pubblica({"tipo": "scrivendo"})
                # Il servizio puo' essere stato acceso un attimo fa, dal
                # selettore, e carica ottocento megabyte: si aspetta che
                # risponda, con la scritta gia' a schermo. Se non arriva si
                # racconta dall'archivio, come se il modo fosse l'altro.
                self._aspetta_il_modello()
            racconto = self.narratore.racconta(
                self._fatti, preferisci_modello=self.genera_racconti)
        log.info("racconto da %s (%d parole)", racconto.origine,
                 len(racconto.testo.split()))
        frasi = racconto.frasi
        # La scansione finisce qui: si e' letto, si e' cercato, e c'e' un
        # racconto pronto. Si mette a giornale con dentro anche COSA si e'
        # detto: un riconoscimento giusto puo' produrre un testo sbagliato, e
        # senza il testo quel caso non si vede.
        self._scansione["racconto_da"] = racconto.origine
        self._scansione["racconto"] = racconto.testo
        self._annota("raccontato")

        # Il testo arriva TUTTO INSIEME, e la frase in ascolto si illumina.
        # Farlo comparire un pezzo alla volta, al ritmo stimato della lettura,
        # e' una finzione che regge finche' si va dritti, ma con un pulsante di
        # pausa e uno di riavvolgimento si sfalda al primo tocco. E con un
        # player davanti, chi guarda vuole vedere quanto manca.
        self._pubblica({"tipo": "racconto", "frasi": frasi,
                        "origine": racconto.origine})

        if self.voce is None or not self.voce.disponibile_per_lingua:
            # Nessuna voce per questa lingua: il racconto si legge soltanto, e
            # allora e' giusto che scorra da solo al ritmo di una lettura.
            self._scorri_senza_voce(frasi)
            return

        try:
            lettore = Riproduttore(
                self.voce, frasi,
                su_avanzamento=lambda i: self._pubblica({"tipo": "riproduzione", **i}))
        except Exception as e:                              # noqa: BLE001
            log.warning("riproduttore non avviabile: %s", e)
            self._scorri_senza_voce(frasi)
            return

        # Fra la generazione del testo e questa riga puo' essere passato un
        # minuto, e in quel minuto `_lettore` e' vuoto: un annullamento caduto
        # li' non troverebbe niente da fermare, e il dispositivo comincerebbe a
        # parlare sopra la schermata d'invito.
        #
        # Il controllo sta DENTRO il lucchetto, insieme all'assegnazione, e
        # `_ferma_racconto` alza la bandiera dentro lo stesso lucchetto: senza,
        # fra il controllo e l'assegnazione restano pochi bytecode in cui un
        # annullamento passa in mezzo, non trova nessun riproduttore da fermare
        # e ne lascia partire uno subito dopo. Stretta quanto si vuole, resta
        # una finestra, ed e' quella che il lucchetto chiude.
        with self._lucchetto_lettore:
            if self._ferma_voce.is_set():
                log.info("racconto annullato prima di cominciare")
                return
            self._lettore = lettore
        lettore.avvia()
        finito = lettore.attendi(timeout=TETTO_RACCONTO_S)
        # Se e' finito da solo, si aspetta che l'ULTIMO SUONO sia uscito davvero
        # prima di fermare: `ferma()` svuota la coda, e fra l'ultimo pezzo
        # passato all'uscita e l'orecchio ci sono la riserva dell'uscita e la
        # latenza di ALSA. Senza questa attesa si perderebbero tre quarti di
        # secondo in fondo a ogni racconto, in tutte e due le lingue.
        #
        # Se invece l'hanno fermato - un annullamento, un'altra bottiglia - si
        # tronca eccome: e' esattamente quello che serve.
        if finito and not self._ferma_voce.is_set():
            lettore.attendi_la_coda()
        with self._lucchetto_lettore:
            if self._lettore is lettore:
                self._lettore = None
        lettore.ferma()

        if finito and not self._ferma_voce.is_set():
            self.macchina.invia(Evento.RACCONTO_FINITO)

    def _scorri_senza_voce(self, frasi: list[str]) -> None:
        """Il ripiego quando non c'e' voce: il testo si illumina da solo.

        Il ritmo e' quello di una lettura ad alta voce, ed e' il ritmo MISURATO
        della voce che sta imitando - 17,2 caratteri al secondo in italiano,
        14,4 in inglese - cosi' il testo scorre come sarebbe stato letto.

        E pubblica una quota vera: con la sola `durata: 0` il client
        salterebbe l'aggiornamento. Quando la lingua non ha voce la barra e'
        nascosta dal foglio di stile, ma a questo ripiego ci si arriva ANCHE
        quando la voce per la lingua c'e' e il riproduttore non parte. Li' la
        barra e' bene in vista, e senza quota resterebbe ferma a zero per tutto
        il racconto.
        """
        pesi = [max(1, len(per_la_voce(f, self.lingua))) for f in frasi]
        totale = sum(pesi)
        fatto = 0
        # Il ritmo della lingua che si sta MOSTRANDO. Non `voce.imp.modello`:
        # quando la lingua scelta non ha voce, `Voce.per_lingua` esce prima di
        # cambiare il modello, e li' resta quello dell'ultima lingua che una
        # voce ce l'aveva. Il testo inglese sarebbe scorso al ritmo italiano -
        # cioe' proprio nel caso per cui questo ripiego esiste.
        car_s = caratteri_al_secondo(VOCI.get(self.lingua, ""))
        for i, frase in enumerate(frasi):
            if self._ferma_voce.is_set():
                return
            self._pubblica({"tipo": "riproduzione", "frase": i,
                            "posizione": 0.0, "durata": 0.0,
                            "quota": round(fatto / totale, 3),
                            "in_pausa": False, "completo": False,
                            "senza_voce": True})
            # `wait` e non `sleep`: la bandiera e' un Event, e aspettarci
            # sopra fa tornare il thread nell'istante in cui viene alzata.
            # Dormendo, chi annulla lascerebbe il thread di lavoro vivo fino a
            # sei secondi dopo che lo schermo e' gia' tornato all'invito - e
            # una bottiglia rimessa dentro quella finestra troverebbe il lavoro
            # ancora in corso, e dovrebbe aspettarlo.
            if self._ferma_voce.wait(min(6.0, max(1.0, pesi[i] / car_s))):
                return
            fatto += pesi[i]
        if not self._ferma_voce.is_set():
            self._pubblica({"tipo": "riproduzione", "frase": len(frasi) - 1,
                            "posizione": 0.0, "durata": 0.0, "quota": 1.0,
                            "in_pausa": False, "completo": True,
                            "senza_voce": True})
            self.macchina.invia(Evento.RACCONTO_FINITO)

    # ------------------------------------------------------------- comandi

    def comanda_racconto(self, azione: str) -> dict:
        """I pulsanti sotto il racconto. Nient'altro sullo schermo reagisce.

        Se non c'e' niente in riproduzione si risponde e basta: un tocco che
        arriva mentre il racconto sta finendo non deve sollevare nulla.
        """
        with self._lucchetto_lettore:
            lettore = self._lettore
        # `esaurito` e non solo `None`: il riproduttore resta agganciato ancora
        # mezzo secondo dopo la fine, il tempo che l'ultimo suono esca davvero.
        # In quella finestra i suoi thread sono gia' morti, e un tocco su
        # «indietro» farebbe arretrare la barra lasciandocela, perche' nessuno
        # pubblica piu' niente.
        if lettore is None or lettore.esaurito:
            return {"ok": False}
        if azione == "alterna":
            lettore.alterna()
        elif azione == "pausa":
            lettore.pausa()
        elif azione == "riprendi":
            lettore.riprendi()
        elif azione == "avanti":
            lettore.salta(SALTO_S)
        elif azione == "indietro":
            lettore.salta(-SALTO_S)
        elif azione == "ricomincia":
            lettore.ricomincia()
        else:
            return {"ok": False, "motivo": "azione sconosciuta"}
        return {"ok": True, **lettore.istantanea()}

    def annulla(self) -> dict:
        """Il tocco su «annulla»: si chiude e si torna all'invito.

        Senza, l'unico modo di finire sarebbe aspettare la fine del racconto:
        togliere la bottiglia non lo ferma, perche' chi la alza per versare non
        ha chiesto silenzio. E far aspettare chi ha gia' versato, solo per far
        tacere il dispositivo, e' una cosa che non si chiede a un ospite.

        Quasi tutto lo spegne la macchina, e va lasciato fare a lei: uscendo da
        RACCONTO scatta FERMA_RACCONTO, entrando in ATTESA tornano l'ambra
        dell'anello e la schermata d'invito; la lingua resta quella scelta (vedi
        `_su_transizione`). Scrivere l'annullamento fuori dalla macchina
        significa dimenticarsene meta': la voce tace e l'anello resta verde
        sopra la schermata d'invito.

        Restano due cose che la macchina non puo' sapere, ed e' per quelle che
        questo metodo esiste.

        La PRIMA e' l'annuncio della lingua, che vive in un thread suo: chi
        tocca una bandierina e subito annulla non deve sentirsi finire
        «English» sopra la schermata d'invito.

        La SECONDA e' il racconto non ancora cominciato. Fra la generazione del
        testo e l'avvio del riproduttore c'e' una finestra in cui `_lettore` e'
        ancora vuoto: un FERMA_RACCONTO che cade li' non trova niente da
        fermare, e il dispositivo comincia a parlare a schermata d'invito gia'
        disegnata. Con i testi in archivio la finestra e' quasi nulla, col
        modello linguistico acceso arriva a un minuto - e ci mette tanto
        proprio quando qualcuno ha voglia di annullare. `_ferma_voce` resta
        alzata, e `_racconta` la rilegge prima di dare fiato.

        Non promette silenzio istantaneo: i due decimi di secondo gia' passati
        ad ALSA escono comunque.
        """
        stato = self.macchina.stato
        # Si guarda PRIMA se c'e' qualcosa da annullare, e nel dubbio non si
        # tocca niente. Zittendo prima di sapere, un tocco caduto nel vuoto -
        # arrivato mentre la schermata stava gia' cambiando - lascerebbe
        # `_ferma_voce` alzata addosso al racconto che sta per partire; e
        # riabbassarla dopo sarebbe peggio, perche' potrebbe averla alzata
        # qualcun altro un istante prima, per esempio chi ha tolto la
        # bottiglia. Meglio non entrarci affatto.
        if (stato, Evento.ANNULLA) not in TRANSIZIONI:
            log.info("annulla ignorato: la macchina e' in %s", stato.value)
            return {"ok": False, "stato": stato.value}
        # Ora si puo'. Prima si zittisce e poi si manda l'evento: al contrario,
        # fra l'ingresso in ATTESA e il silenzio ci sarebbe una frase intera.
        self._ferma_voce.set()
        with self._lucchetto_annuncio:
            self._lingua_da_annunciare = None
        if self.voce is not None:
            self.voce.zittisci()
        t = self.macchina.invia(Evento.ANNULLA)
        log.info("annullato da %s", stato.value)
        return {"ok": True, "stato": t.a.value}

    def apri_correzione(self) -> dict:
        """Si apre l'editor: si ferma la voce e si tiene ferma la lettura.

        La lettura - foto e righe dell'OCR - si copia ADESSO: se mentre si
        scrive qualcuno cambia bottiglia, la correzione deve restare attaccata
        alla bottiglia che si stava correggendo, non a quella nuova.
        """
        if not self.correzioni_attive:
            return {"ok": False}
        if getattr(self, "_ultimo_scatto", None) is None:
            return {"ok": False}
        # Dal racconto, per correggerlo; o da una bottiglia che non si e'
        # riconosciuta - fra un tentativo e l'altro, o a tentativi finiti -
        # per insegnarla al dispositivo. Li' il pulsante e' «Mi aiuti a
        # riconoscerla», e la regola per mostrarlo e' la stessa che si
        # controlla qui.
        stato = self.macchina.stato
        aiuto = (stato is Stato.RIPOSIZIONA
                 or (stato is Stato.CONCLUSO and self._niente_raccontato()))
        if aiuto:
            if not self._aiuto_possibile():
                return {"ok": False}
        elif stato not in (Stato.RACCONTO, Stato.CONCLUSO):
            return {"ok": False}
        self._ferma_racconto()
        self._correggendo = {"righe": list(self._righe_lette),
                             "immagine": self._ultimo_scatto,
                             "lingua": self.lingua, "quando": time.monotonic()}
        c = self._correzione
        t = (c.testi.get(self.lingua) or {}) if c is not None else {}
        if c is not None:
            riferimento = c.riferimento
            # Il titolo si propone anche da un'altra lingua: il nome di un vino
            # di solito non si traduce.
            titolo = t.get("titolo") or c.titolo()
        else:
            riferimento = self._riferimento_attuale()
            # Il nome del vino riconosciuto, gia' collegato; fuori archivio il
            # campo resta vuoto: «Vino rosato» andrebbe solo cancellato.
            titolo = riferimento["titolo"] if riferimento else ""
        return {
            "ok": True, "lingua": self.lingua, "aiuto": aiuto,
            "id": c.id if c is not None else None,
            "titolo": titolo,
            # Il vino a cui la bottiglia e' collegata: quello della correzione,
            # o quello che il dispositivo ha appena riconosciuto. Lasciando la
            # descrizione vuota si racconta la sua scheda.
            "riferimento": riferimento,
            "descrizione": t.get("descrizione", ""),
            # Se questa bottiglia somiglia a una gia' corretta ma non abbastanza
            # da riconoscerla, si chiede a chi scrive se e' lei.
            "vicine": [] if c is not None else [
                {"id": v.id, "titolo": v.titolo(),
                 "descrizione": (v.testo_in(self.lingua) or {}).get("descrizione", "")}
                for v in self.correzioni.vicine(self._righe_lette)],
        }

    def salva_correzione(self, titolo: str, descrizione: str,
                         ident: str | None = None,
                         riferimento: dict | None = None,
                         scollega: bool = False) -> dict:
        """Scrive la correzione e la racconta subito: e' la prova che ha funzionato.

        `riferimento` e' la bottiglia scelta dalla ricerca (archivio o carta):
        con quella la descrizione e' facoltativa. `ident` e' una correzione gia'
        esistente a cui aggiungere questa foto.
        """
        g = self._correggendo
        if g is None or g.get("domanda"):
            return {"ok": False, "motivo": "editor chiuso"}
        if not str(titolo or "").strip():
            return {"ok": False, "campo": "titolo"}
        riferimento = self._riferimento_valido(riferimento)
        if g.get("seconda"):
            # La descrizione nell'altra lingua: stessa correzione, stesso
            # collegamento, e nessuna foto in piu' - la bottiglia e' quella
            # appena salvata, e una seconda vista identica non insegna niente.
            ident, riferimento, scollega = g["id"], None, False
        if ident is None and self._correzione is not None:
            ident = self._correzione.id
        esistente = self.correzioni.trova(ident) if ident else None
        descrizione = str(descrizione or "").strip()
        if not descrizione and esistente is not None and riferimento is None:
            # Aggiungendo una foto a una correzione gia' fatta senza riscriverla,
            # la descrizione resta quella che c'era.
            descrizione = esistente.descrizione_in(g["lingua"])
        # `scollega`: chi corregge ha tolto il collegamento che c'era.
        collegata = None if scollega else (
            riferimento or (esistente.riferimento if esistente else None))
        if not descrizione and not collegata:
            return {"ok": False, "campo": "descrizione"}
        try:
            c = self.correzioni.salva(
                righe=[] if g.get("seconda") else g["righe"],
                immagine=None if g.get("seconda") else g["immagine"],
                titolo=titolo, descrizione=descrizione,
                lingua=g["lingua"], ident=ident, riferimento=collegata)
        except (OSError, ValueError) as e:
            log.warning("correzione non salvata: %s", e)
            return {"ok": False, "motivo": str(e)}
        self._correzione = c
        # Il racconto che riparte deve essere gia' quello della bottiglia
        # corretta: collegata a un altro vino, si racconta quello. Senza questa
        # riga ripartirebbe la scheda di prima: un Asti collegato al Moscato
        # d'Asti della carta verrebbe raccontato come Asti.
        if c.riferimento or not self._correzione_parla_ora():
            self._fatti, self._voce = self._della_correzione(
                c, [getattr(r, "testo", r) for r in g["righe"]])
        self._annota("corretta a mano")
        # Scritta una descrizione, si chiede se la si vuole anche nell'altra
        # lingua: chi la scrive in italiano spesso sa scriverla in inglese, ed
        # e' il momento in cui ce l'ha in testa. L'editor resta aperto intanto,
        # cosi' il dispositivo non torna a guardare il piatto e il racconto non
        # riparte sotto la domanda.
        altra = self._altra_lingua(g["lingua"])
        if descrizione and altra and not g.get("seconda"):
            g.update(domanda=altra, id=c.id, quando=time.monotonic())
            return {"ok": True, "id": c.id, "altra_lingua": altra,
                    "domanda": self.lex.frase("schermo", "altra_lingua_domanda",
                                              lingua=self.lingua,
                                              nome=self._nome_lingua(altra))}
        self._finisci_correzione()
        return {"ok": True, "id": c.id}

    def _altra_lingua(self, lingua: str) -> str | None:
        """La lingua in cui la descrizione non si e' appena scritta."""
        return next((l for l in self.lex.lingue if l != lingua), None)
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
