destone28/Amelie2.0/src/amelie/narrator.py

"""Il racconto: dai fatti alla prosa, senza inventare.

Un modello piccolo non sa nulla di vino. Se gli si chiede di raccontare un
Sagrantino, inventa premi, punteggi e note di degustazione che suonano
benissimo e sono false. In sala, davanti a un ospite, è una figuraccia.

Per questo il modello **non è la fonte dei fatti**, e nel modo predefinito non
è nemmeno la fonte delle parole. Due modi, e la differenza fra loro è DA DOVE
VENGONO le parole:

1. **Composizione dai fatti** — il modo «archivio», quello predefinito. Ogni
   frase nasce da un campo dell'archivio o da una citazione del disciplinare,
   dentro una forma del lessico scelta da un seme stabile per vino. Non c'è
   nessun passaggio in cui una parola possa nascere altrove, ed è l'unica
   garanzia che regge: istantanea, e vera per costruzione. Vedi `template`.
2. **Il modello** — il modo «generativa», dichiarato sperimentale. Riceve solo
   il blocco dei fatti e un divieto di aggiungerne; ciò che scrive passa da
   `verifica`, e se inventa due volte di fila si scende al testo pronto per
   quel record, se qualcuno l'ha scritto, e poi alla composizione. Misurato
   sul dispositivo: cinque testi su dodici con un errore di fatto, e la
   verifica non li prende tutti. Ogni regola in più scopre una forma nuova
   di errore: per questo non è il modo predefinito.

`verifica` è un controllo deterministico in Python — numeri, nomi propri,
colori, rapporti fra nomi veri — che il modello non può aggirare, e che si
applica anche ai racconti pronti del database, che nel modo generativo fanno
da ripiego.

Il tono cambia con il livello raggiunto dalla cascata del riconoscimento:
sotto il primo gradino non si attribuisce mai a un produttore sconosciuto ciò
che non si è verificato.
"""

from __future__ import annotations

import functools
import logging
import re
import sqlite3
import threading
import unicodedata
from dataclasses import dataclass
from pathlib import Path
from typing import Callable, Iterator

from .lessico import Lessico, carica, elenca_in_lingua
from .matcher import SOGLIA_DUBBIA, Fatti, Livello

log = logging.getLogger(__name__)

# Un vitigno finto del registro detto come se fosse un'uva: vedi
# `matcher.VITIGNI_FINTI` e `Narratore._dalla_cache`.
_UVA_FINTA = re.compile(r"\b(?:da|from)\s+(?:na|n\.a\.|n/a|nd|n\.d\.)(?=[\s.,;]|$)", re.I)

# Un racconto piu' lungo di così non lo ascolta nessuno in piedi davanti a un
# tavolo, e ogni parola in piu' costa ~0,2 s di generazione sui Cortex-A53.
PAROLE_MAX = 130


@dataclass
class Racconto:
    testo: str
    origine: str          # 'cache' | 'modello' | 'template'
    livello: Livello
    verificato: bool = True

    @property
    def frasi(self) -> list[str]:
        """Spezza in frasi, che è l'unità con cui il TTS può iniziare a parlare
        prima che il testo sia finito."""
        return spezza_in_frasi(self.testo)


# Si spezza dopo un punto SOLO se quello che segue comincia come una frase:
# maiuscola, virgoletta o parentesi. Altrimenti «Un Barolo D.O.C.G. del 2016»
# si spaccherebbe dentro la sigla e ne uscirebbe un frammento che comincia in
# minuscolo - una pausa sbagliata nella voce, e una didascalia a meta'.
# E non dopo un'iniziale puntata: «di M. Marengo», «Abbazia di S. Gaudenzio»,
# «F.lli Vincenzi» sono nomi di cantina, e la voce ci farebbe una pausa in
# mezzo - «...di emme.» «Marengo.» - con la frase sbagliata illuminata a
# schermo. Sono centinaia di cantine.
_FINE_FRASE = re.compile(
    r"""(?<=[.!?…])(?<!\b[A-ZÀ-Ý].)\s+(?=[A-ZÀ-Ý«"“'(])""")


def spezza_in_frasi(testo: str) -> list[str]:
    """La frase è l'unità con cui il dispositivo parla e con cui si legge.

    Serve in due posti: al racconto, che comincia a parlare prima di aver
    finito di scrivere, e alla didascalia, che deve cambiare quando cambia la
    voce e non prima.

    Diverso da `a_frasi`, che fa lo stesso su un FLUSSO di token mentre il
    modello scrive: qui il testo c'è già tutto.
    """
    return [f.strip() for f in _FINE_FRASE.split(testo) if f.strip()]


_SCHEDE_VITIGNI = Path(__file__).resolve().parents[2] / "data" / "vitigni.json"


@functools.lru_cache(maxsize=None)
def _in_minuscolo(lingua: str) -> frozenset[str]:
    """Le parole che nelle schede dei vitigni compaiono anche in minuscolo."""
    import json
    try:
        schede = json.loads(_SCHEDE_VITIGNI.read_text(encoding="utf-8"))
    except (OSError, ValueError):
        return frozenset()
    campo = "descrizione" if lingua == "it" else f"descrizione_{lingua}"
    parole: set[str] = set()
    for scheda in schede.get("vitigni", []):
        if isinstance(scheda, dict):
            parole.update(re.findall(r"\b[a-zà-ÿ]\w*", scheda.get(campo) or ""))
    return frozenset(parole)


def dopo_i_due_punti(testo: str, lingua: str) -> str:
    """Il seguito dopo i due punti comincia in minuscolo - «Nasce da
    Chardonnay: borgognone, ovunque nel mondo» - tranne quando la prima parola
    è un nome: in inglese «Sicilian» resta maiuscolo. È un nome se nelle schede
    dei vitigni non compare mai in minuscolo."""
    parola = re.match(r"\w+", testo)
    if not parola or parola.group(0).lower() not in _in_minuscolo(lingua):
        return testo
    return testo[:1].lower() + testo[1:]


# ---------------------------------------------------------------- verifica

_NUMERO = re.compile(r"\d+(?:[.,]\d+)?")
# Un nome proprio: maiuscola iniziale, almeno tre lettere, non a inizio frase
# - e nemmeno dopo i due punti, dove la maiuscola e' d'uso: «Molinara: Vitigno
# veronese» non nomina nessuno.
_PROPRIO = re.compile(r"(?<![.!?…:]\s)(?<!^)\b([A-ZÀ-Ý][a-zà-ÿ']{2,})\b")

# Parole che iniziano per maiuscola senza essere nomi propri di vino: mesi,
# regioni generiche del discorso, e l'inizio di ogni frase.
_MAIUSCOLE_INNOCENTI = frozenset("""
    Il Lo La I Gli Le Un Uno Una Questo Questa Queste Questi Nel Nella Nelle Nei
    Dal Dalla Dalle Dai Del Della Delle Dei Con Per Tra Fra Ma Se Come Quando
    Dove Ogni Anche Ancora Oggi Qui Si No Non Suo Sua Sue Suoi Loro
    Gennaio Febbraio Marzo Aprile Maggio Giugno Luglio Agosto Settembre Ottobre
    Novembre Dicembre Italia Italiano Italiana
""".split())


def _senza_accenti(s: str) -> str:
    return "".join(
        c for c in unicodedata.normalize("NFKD", s) if not unicodedata.combining(c)
    ).lower()


def _regione_in(fatti: Fatti, lingua: str) -> str | None:
    """La regione dei fatti come la dice il racconto in questa lingua."""
    if not fatti.regione:
        return None
    return carica().traduci("regione", fatti.regione, lingua=lingua)


def verifica(testo: str, fatti: Fatti, lingua: str = "it") -> tuple[bool, list[str]]:
    """Il testo afferma solo cose presenti nei fatti?

    Restituisce (va bene, elenco delle invenzioni). Il controllo è volutamente
    grossolano ma **deterministico**: cerca numeri e nomi propri che non
    compaiano da nessuna parte nel blocco dei fatti. Preferisce un falso
    allarme — che costa una rigenerazione — a una bugia detta all'ospite.

    **La lingua conta**: i fatti si compongono nella lingua del racconto,
    perché un racconto inglese confrontato con parole italiane non torna mai.
    «Tuscany» non sta in un blocco che dice «Toscana», e nemmeno «Italy»,
    «Piedmont», «Bordeaux»: confrontando in italiano, sui 9.660 racconti in
    archivio la verifica ne boccia 3.401, quasi tutti per questo. Un controllo
    che grida sempre non è un controllo severo, è un controllo spento.

    >>> f = Fatti(livello=Livello.VINO, nome="Cannubi", cantina="Marchesi")
    >>> verifica("Il Cannubi di Marchesi.", f)[0]
    True
    >>> verifica("Il Cannubi ha vinto tre stelle Gambero Rosso.", f)[0]
    False
    """
    # L'apostrofo tipografico vale come quello dritto: il modello lo scrive,
    # e senza normalizzarlo «dall’incontro» non troverebbe il contesto delle uve.
    testo = testo.replace("’", "'").replace("‘", "'")
    # E lo stesso dall'altra parte: «Valled’aosta» sta nel registro con
    # l'apostrofo tipografico, e il testo normalizzato non lo ritroverebbe.
    ammesso = _senza_accenti(
        " ".join(filter(None, [
            fatti.blocco_fatti(lingua=lingua),
            " ".join(fatti.vitigni),
            fatti.nota_in(lingua) or "",
            fatti.note_vitigno or "",
            " ".join(fatti.sensoriali_in(lingua)),
            " ".join(fatti.abbinamenti_in(lingua)),
            fatti.denominazione or "",
            fatti.tipologia or "",
            fatti.nome or "",
            fatti.cantina or "",
            fatti.regione or "",
            _regione_in(fatti, lingua) or "",
            str(fatti.annata or ""),
            fatti.temperatura_c or "",
            " ".join(fatti.note_sensoriali),
        ])).replace("’", "'").replace("‘", "'")
    )
    invenzioni = []

    for m in _NUMERO.finditer(testo):
        n = m.group(0).replace(",", ".")
        if n not in ammesso and n.replace(".", ",") not in ammesso:
            invenzioni.append(n)

    for m in _PROPRIO.finditer(testo):
        parola = m.group(1)
        if parola in _MAIUSCOLE_INNOCENTI:
            continue
        if _senza_accenti(parola) not in ammesso:
            invenzioni.append(parola)

    # Contraddizioni di colore. Sono l'errore che si nota di piu' e il piu'
    # facile da intercettare: se i fatti dicono bianco e il testo dice rosso,
    # e' falso e basta. Un modello piccolo ci casca spesso, perche' "vino" e
    # "rosso" stanno vicini nella sua testa.
    if contraddizione := _colore_sbagliato(testo, fatti, ammesso):
        invenzioni.append(contraddizione)

    # Le quattro classi che seguono sono errori tipici del modello addestrato
    # che un controllo sui soli nomi propri non vede: e cio' che la verifica
    # non vede diventa un'abitudine del modello.
    invenzioni.extend(_gradi_sbagliati(testo, fatti))
    if "disciplinar" in _senza_accenti(testo) and not fatti.disciplinare:
        invenzioni.append("disciplinare invocato senza citazioni")
    invenzioni.extend(_cibi_inventati(testo, ammesso))
    invenzioni.extend(_provenienze_inventate(testo, ammesso))
    # Le due classi che seguono non inventano NOMI, inventano RAPPORTI fra
    # nomi veri, e un controllo sui nomi le promuove: su dodici testi generati
    # sul dispositivo, cinque sbagliano cosi'. «Sangiovese e Amarena, i
    # vitigni piu' coltivati d'Italia» - tre volte su dodici: l'amarena e' una
    # nota olfattiva dei fatti, non un'uva. «Amarone della Valpolicella, un
    # vitigno compagno dei Rondinella»: e' il vino, non un vitigno. E «questa
    # spumante» detto di un Amarone.
    invenzioni.extend(_vitigni_che_non_lo_sono(testo, fatti, lingua))
    if contraddizione := _categoria_sbagliata(testo, fatti, ammesso):
        invenzioni.append(contraddizione)
    # Le classi che seguono guardano il POSTO delle parole: «da servire con
    # amarena, prugna o tannino morbido», «nasce dall'incontro di mela verde e
    # fiori bianchi, il vitigno Prosecco», «gradevole, fine, delicato,
    # delicate». Le note olfattive finiscono nei posti delle uve e dei cibi,
    # in minuscolo, dove il controllo sui nomi propri non guarda.
    invenzioni.extend(_produttore_al_posto_del_luogo(testo, fatti))
    invenzioni.extend(_colore_al_posto_del_gusto(testo, fatti))
    invenzioni.extend(_uve_al_posto_del_produttore(testo, fatti))
    invenzioni.extend(_scheda_attaccata_al_vino(testo, fatti, lingua))
    invenzioni.extend(_note_al_posto_sbagliato(testo, fatti, lingua))
    invenzioni.extend(_cibi_al_posto_dei_profumi(testo, fatti, lingua))
    # Le ripetizioni che stanno dentro una citazione del registro non sono
    # del racconto: il registro enumera le sfumature ammesse - «rosso rubino
    # piu' o meno intenso, rosa piu' o meno intenso» - e il racconto le
    # riporta. Si riprende quel che si e' ripetuto, non chi l'ha scritto.
    citazioni = _citazioni_come_si_dicono(fatti, lingua)
    invenzioni.extend(x for x in _parole_ripetute(testo)
                      if x.removeprefix("ripetizione: ") not in citazioni)

    return (not invenzioni), invenzioni


# I numeri che il modello addestrato dice a voce sono scritti in lettere - e'
# cosi' che il corpus glieli ha insegnati, perche' una voce sintetica legge
# «17-19» come «diciassette trattino diciannove». Il controllo sulle cifre non
# li vede. Si guardano solo nelle frasi che parlano di gradi: «due vitigni»
# e' un conteggio, non un fatto da verificare.
_IN_LETTERE = {
    "cinque": 5, "sei": 6, "sette": 7, "otto": 8, "nove": 9, "dieci": 10,
    "undici": 11, "dodici": 12, "tredici": 13, "quattordici": 14, "quindici": 15,
    "sedici": 16, "diciassette": 17, "diciotto": 18, "diciannove": 19, "venti": 20,
}
_NUMERO_IN_LETTERE = re.compile(
    r"\b(" + "|".join(sorted(_IN_LETTERE, key=len, reverse=True)) + r")\b(\s+gradi)?(\s+e\s+mezzo)?",
    re.I)


def _gradi_sbagliati(testo: str, fatti: Fatti) -> list[str]:
    """Gradazione e temperatura dette in lettere, confrontate coi fatti.

    Un intervallo si dice coi suoi estremi: «fra i sedici e i diciotto». Il
    punto medio - «diciassette» - non e' scritto da nessuna parte, e il mezzo
    grado va confrontato come mezzo: «tredici gradi e mezzo» di un 12,5% e'
    sbagliato anche se l'intero torna."""
    permessi: set[float] = set()
    if fatti.abv:
        permessi.add(float(fatti.abv))
    for n in re.findall(r"\d+(?:[.,]\d+)?", fatti.temperatura_c or ""):
        permessi.add(float(n.replace(",", ".")))
    if not permessi:
        return []
    fuori = []
    for frase in spezza_in_frasi(testo):
        if "grad" not in _senza_accenti(frase):
            continue
        for m in _NUMERO_IN_LETTERE.finditer(_senza_accenti(frase)):
            detto = _IN_LETTERE[m.group(1).lower()] + (0.5 if m.group(3) else 0.0)
            if detto not in permessi:
                fuori.append(f"{m.group(0).strip()} (nei fatti: "
                             f"{', '.join(f'{p:g}' for p in sorted(permessi))})")
    return fuori


_CIBI = re.compile(
    r"\b(manzo|agnello|maiale|vitello|pollame|pollo|cacciagione|selvaggina|salumi|"
    r"formagg\w*|pesc[ei]|crostacei|molluschi|frutti di mare|antipasti|stuzzichini|"
    r"risott\w*|zupp[ae]|verdure|dolci|pasticceria|dessert|cioccolato|funghi|tartufo|"
    r"pizza|carni? (?:rosse|bianche)|arrost\w*|brasat\w*|grigliat\w+|ostriche|"
    r"primi piatti|pasta)\b", re.I)


def _cibi_inventati(testo: str, ammesso: str) -> list[str]:
    """Abbinamenti che i fatti non danno: «formaggi» nei fatti copre
    «formaggio» nel testo, per questo si confronta la radice."""
    return [m.group(0) for m in _CIBI.finditer(_senza_accenti(testo))
            if m.group(0)[:5] not in ammesso]


# Un modello piccolo non sa da dove venga un vitigno, ma impara benissimo la
# forma «il vitigno <aggettivo> di <denominazione>» e riempie l'aggettivo a
# caso: «Catarratto, un grande abruzzese del Piemonte». E' siciliano.
_PROVENIENZA = re.compile(
    r"\b(piemontes|toscan|sicilian|abruzzes|puglies|venet|umbr|lazial|marchigian|"
    r"sard|calabres|campan|lombard|ligur|friulan|trentin|altoatesin|emilian|"
    r"romagnol|borgognon|bordoles|frances|spagnol|tedesc|austriac)\w*", re.I)


def _provenienze_inventate(testo: str, ammesso: str) -> list[str]:
    return [m.group(0) for m in _PROVENIENZA.finditer(_senza_accenti(testo))
            if m.group(0)[:6] not in ammesso]


# Dove un testo dichiara i vitigni: quel che segue fino alla fine della frase
# e' un elenco di uve, e ogni nome proprio li' dentro dev'essere un'uva.
_CONTESTO_VITIGNI = re.compile(
    # «dall'incontro»: dopo l'apostrofo non c'e' spazio, e l'espressione non
    # lo pretende.
    # L'elenco delle uve finisce alla prima virgola o a un «con»/«che»: dopo
    # comincia un'altra cosa - «Nasce dal Sangiovese, con note di amarena» ha
    # l'amarena al posto giusto, e il controllo non deve leggerla come uva.
    # «vitigno» e «uve» aprono un elenco solo se seguono con un nome proprio:
    # «vitigno veronese dal colore tenue» e' un aggettivo, non un elenco, e
    # altrimenti la scheda della Molinara verrebbe bocciata per «acidita'
    # viva detta come uva». E l'elenco continua oltre una virgola solo se dopo
    # la virgola viene un altro nome proprio: «Sangiovese, Amarena e Canaiolo»
    # e' un elenco intero e va guardato tutto; «Isabella, ibrido americano dal
    # profumo di fragola» finisce a Isabella, e la fragola non e' un'uva
    # detta male, e' un profumo detto bene.
    # Anche il «da» liscio, oltre a «dal», «dalla», «dall'», «dai»: in
    # «nasce da Barbaresco», Barbaresco e' il vino.
    r"(?:nasce\s+(?:dall'|dalla\s+|dalle\s+|dal\s+|dai\s+|da\s+)\s*(?:solo\s+|incontro\s+di\s+)?"
    # «Nasce dall'incontro di tre vitigni: Trebbiano, Toscano, Abruzzese e
    # Soave»: se i due punti chiudessero il pezzo catturato, l'elenco vero -
    # quello dopo - non si leggerebbe affatto.
    r"|vitign[oi]\s*:?\s*(?=(?-i:[A-ZÀ-Ý]))|uv[ae]\s+(?:di\s+)?(?=(?-i:[A-ZÀ-Ý]))"
    # «It comes from Ripa Teatina», «It is made from Nebbiolo»: sono le frasi
    # inglesi del lessico, e quel che segue sono uve. Senza, un luogo detto
    # al posto di un vitigno passerebbe.
    # Non «from the»: e' troppo generico, e dentro la scheda di un vitigno
    # - «Arneis: Piedmontese, from the Roero» - direbbe che il Roero e' un'uva.
    # «Si ottiene da {vitigni}» e' una frase del lessico, quindi il modello
    # l'ha imparata: e quel che segue sono uve per definizione. Senza,
    # «Si ottiene da Restivo» - il produttore - passerebbe.
    r"|si\s+ottien(?:e|gono)\s+(?:da(?:i|l|lla|lle|gli)?\s*)(?=(?-i:[A-ZÀ-Ý]))"
    r"|ottenut[oaie]\s+(?:da(?:i|l|lla|lle|gli)?\s*)(?=(?-i:[A-ZÀ-Ý]))"
    r"|grapes?\s+(?=(?-i:[A-Z]))"
    r"|(?:comes?|made|is\s+made)\s+from\s+(?=(?-i:[A-Z])))"
    # I due punti chiudono il pezzo - «Si ottiene da Zibibbo: Il Moscato
    # d'Alessandria» ha la scheda dopo, non un'altra uva - tranne quando
    # davanti c'e' la parola che annuncia l'elenco: «tre vitigni: Trebbiano,
    # Toscano, Abruzzese e Soave». Li' l'elenco comincia dopo.
    r"((?:[^.;:!?,]|,(?=\s+(?-i:[A-ZÀ-Ý]))"
    r"|(?<=vitigni):|(?<=vitigno):|(?<=uve):|(?<=grapes):|(?<=varieties):)*)", re.I)
_UN_VITIGNO = re.compile(r"\b(un|a)\s+(?:grande\s+)?(vitigno|grape)\b", re.I)
# «Nebbiolo in purezza» e' l'apertura che il corpus insegna, e quel che sta
# davanti DEVE essere un'uva. «Etna in purezza, il vitigno siciliano di
# Sicilia»: l'Etna e' la denominazione, e un controllo sui soli nomi
# promuove la frase perche' «Etna» sta nei fatti.
_IN_PUREZZA = re.compile(
    r"([A-ZÀ-Ý][\w'’ -]{2,40}?)\s+in\s+(?:purezza|pura\s+essenza)\b")


def _vitigni_che_non_lo_sono(testo: str, fatti: Fatti, lingua: str) -> list[str]:
    """Nomi detti come uve che nei fatti sono altro.

    Il modello impara la forma «nasce da X e Y» e la riempie con due nomi
    propri qualunque presi dai fatti: il vitigno vero e la prima nota
    olfattiva che trova. Ogni nome proprio in un contesto da vitigno deve
    stare fra i vitigni dei fatti; se invece sta fra le note sensoriali, o e'
    il nome del vino stesso, e' una bugia con parole vere.
    """
    uve = {_senza_accenti(v).lower() for v in fatti.vitigni + fatti.vitigni_ammessi}
    note = {_senza_accenti(n).lower()
            for n in list(fatti.note_sensoriali) + list(fatti.sensoriali_in(lingua))}
    # La cantina c'e' dentro, e non e' un di piu': in «Si ottiene da Restivo»
    # Restivo e' il produttore. Il nome sta nei fatti, e lo tradisce solo il
    # posto in cui e' finito.
    vino = {_senza_accenti(x).lower() for x in (fatti.nome, fatti.tipologia,
                                                  fatti.denominazione,
                                                  fatti.cantina) if x}
    # I luoghi in un elenco di uve capitano per il verso giusto - «Nasce dal
    # Sangiovese, Toscana» - e non sono un'uva detta male.
    luoghi = {_senza_accenti(x).lower() for x in (fatti.regione, fatti.denominazione,
                                                    _regione_in(fatti, lingua)) if x}
    # Quel che sta fra virgolette e' il nome sull'etichetta, e la scheda del
    # vitigno e' roba dei fatti riportata: nessuno dei due afferma che quelle
    # parole siano uve di questo vino. Guardarci dentro da' sedici allarmi
    # falsi sui racconti composti - «Da Uve Garganega Monte Fiorentine»,
    # «Fragolino: nome popolare dell'uva Isabella».
    pulito = re.sub(r"[«“\"][^»”\"]*[»”\"]", " ", testo)
    for pezzo in (fatti.note_vitigno, fatti.nota_in(lingua)):
        # La scheda si riporta anche a pezzi - il racconto composto ne prende
        # la prima frase - quindi si toglie frase per frase. Ma solo quando e'
        # ATTRIBUITA, cioe' preceduta dai due punti: «Trebbiano: Non un
        # vitigno solo ma una famiglia...» e' la scheda del Trebbiano, mentre
        # «Nasce da Siciliano, chiamato Ansonica in Toscana» e' la stessa
        # scheda messa dove vanno le uve - e «Siciliano» un vitigno non e'.
        for frase in spezza_in_frasi(pezzo or ""):
            if len(frase) > 12:
                pulito = re.sub(r":\s*" + re.escape(frase), ": ", pulito, flags=re.I)

    # Per l'elenco voce per voce si tolgono anche i NOMI: la cantina «Uva Mia
    # di Luisella» e la tipologia «San Severo Uva di Troia» aprono un elenco
    # di uve che non esiste. Sono etichette, non affermazioni. Restano visibili
    # agli altri due controlli, che cercano proprio i nomi finiti fra le uve.
    per_voci = pulito
    for pezzo in (fatti.cantina, fatti.nome, fatti.tipologia, fatti.denominazione):
        if pezzo and len(pezzo) > 3:
            per_voci = re.sub(re.escape(pezzo), " ", per_voci, flags=re.I)
    fuori: list[str] = []
    for m in _CONTESTO_VITIGNI.finditer(pulito):
        for nome in re.findall(r"\b([A-ZÀ-Ý][a-zà-ÿ']{2,})\b", m.group(1)):
            n = _senza_accenti(nome).lower()
            if any(n in u or u in n for u in uve):
                continue
            if any(n in x for x in note):
                fuori.append(f"{nome} detto vitigno, ma e' una nota olfattiva")
    # Il nome del vino, o della sua denominazione, messo dove vanno le uve:
    # «It comes from Ripa Teatina», che e' un paese. Quel nome STA nei fatti
    # - e' la denominazione - e lo tradisce solo il posto in cui e' finito.
    # Si flagga solo se nell'elenco non compare nessuna delle uve vere:
    # «Brachetto d'Acqui» contiene il Brachetto, ed e' un modo legittimo di
    # dirlo.
    # «It comes from Trentino-Alto Adige» dice da DOVE viene, ed e' vero: in
    # inglese la stessa apertura serve alle uve e alla provenienza. Se nel
    # pezzo c'e' la regione dei fatti, si sta parlando di quella.
    regione = _senza_accenti(fatti.regione or "").lower()
    regione_detta = _senza_accenti(_regione_in(fatti, lingua) or "").lower()
    # Ogni VOCE dell'elenco deve contenere un'uva vera. «Brachetto d'Acqui»
    # e' una voce sola e contiene il Brachetto: legittimo. «Trebbiano,
    # Toscano, Abruzzese e Soave» sono quattro voci, e tre non sono uve - la
    # scheda del Trebbiano dice che la famiglia comprende «il Toscano,
    # l'Abruzzese, quello di Soave», e il modello ne fa quattro vitigni di
    # questo vino. Parole vere, fatto falso.
    for m in _CONTESTO_VITIGNI.finditer(per_voci):
        for voce in re.split(r",|\be\b|\bed\b|\band\b", m.group(1)):
            if not re.search(r"[A-ZÀ-Ý]", voce):
                continue
            v = _senza_accenti(voce).lower()
            if any(u and (u in v or v.strip() in u) for u in uve):
                continue
            if any(x and x in v for x in luoghi | note):
                continue
            nomi = re.findall(r"\b[A-ZÀ-Ý][a-zà-ÿ']{2,}\b", voce)
            if nomi:
                fuori.append(f"«{voce.strip()}» detto vitigno, ma fra le uve non c'e'")

    for m in _CONTESTO_VITIGNI.finditer(pulito):
        elenco = _senza_accenti(m.group(1)).lower()
        if any(re.search(r"\b" + re.escape(u) + r"\b", elenco) for u in uve if u):
            continue
        if (regione and regione in elenco) or (regione_detta and regione_detta in elenco):
            continue
        for v in vino:
            if v and len(v) > 4 and v in elenco:
                fuori.append(f"«{v}» messo fra le uve, ma e' il vino")
                break

    for m in _IN_PUREZZA.finditer(testo):
        nome = _senza_accenti(m.group(1)).strip().lower()
        if nome and not any(nome in u or u in nome for u in uve):
            fuori.append(f"«{m.group(1).strip()}» detto in purezza, ma non e' un vitigno")
    # «Amarone della Valpolicella, un vitigno compagno...»: il vino stesso
    # presentato come uva. Il nome deve stare ATTACCATO a «un vitigno»: una
    # finestra dei sessanta caratteri prima boccerebbe la scheda del vitigno
    # che dice «Non un vitigno ma una famiglia numerosa» subito dopo il nome
    # del vino - su 360 racconti composti, 7 falsi allarmi cosi'.
    piano = _senza_accenti(testo).lower()
    for v in vino:
        if not v or any(v in u for u in uve):
            continue
        # «X, un vitigno», «X è un vitigno», «X, che è un vitigno»: dopo
        # `_senza_accenti` la «è» e' una «e», e «e'» e' ammessa anche lei.
        if re.search(re.escape(v) + r"\s*(?:,\s*(?:che\s+)?(?:e'?\s+)?|\s+(?:e'?|is)\s+)?"
                     r"(?:un|a)\s+(?:grande\s+)?(?:vitigno|grape)\b", piano):
            fuori.append(f"«{v}» detto vitigno, ma e' il vino")
    return fuori


# Dove un testo dice che cosa si sente in bocca: li' il colore non c'entra.
_CONTESTO_GUSTO = re.compile(
    r"(?:il\s+gusto\s+è|al\s+palato|in\s+bocca\s+è|il\s+sapore\s+è"
    r"|the\s+taste\s+is|on\s+the\s+palate|in\s+the\s+mouth)([^.!?]*)", re.I)
# Solo parole che descrivono un colore e nient'altro: «secco» o «pieno» in
# bocca ci stanno, «rubino» no.
_PAROLA_DEL_COLORE = re.compile(
    r"\b(?:di\s+colore\s+\w+|rubino|granato|paglierino|verdognol\w+|violacei"
    r"|ambrat\w+|dorat\w+|salmone|ramat\w+|buccia\s+di\s+cipolla"
    r"|ruby|garnet|straw[- ]colou?red|golden[- ]yellow|amber)\b", re.I)


def _colore_al_posto_del_gusto(testo: str, fatti: Fatti) -> list[str]:
    """Il colore detto dove va il gusto.

    «In bocca è asciutto, armonico, di colore bianco e con acidità alta»,
    «On the palate, bright ruby red». Il modello ha tre citazioni del
    disciplinare - colore, odore, sapore - e ogni tanto mette quella del
    colore nel giro di frase del gusto. Le parole sono tutte vere, il posto
    no: per questo si guarda il posto.

    Misurato sui racconti salvati: succede nel 3-9% dei testi scritti dal
    modello, in tutte e due le lingue.
    """
    fuori = []
    for m in _CONTESTO_GUSTO.finditer(testo):
        if (x := _PAROLA_DEL_COLORE.search(m.group(1))):
            fuori.append(f"«{x.group(0)}» detto del gusto, ma e' il colore")
    return fuori


# Dopo il nome fra virgolette, «di» e «by» introducono chi l'ha fatto.
_CONTESTO_PRODUTTORE = re.compile(r"[»”\"']\s+(?:di|by)\s+([^.;:!?]*)", re.I)


def _uve_al_posto_del_produttore(testo: str, fatti: Fatti) -> list[str]:
    """I vitigni messi dove va la cantina.

    «This is the "Barbera del Monferrato" by Grignolino, Freisa, Dolcetto and
    Barbera»: quelle sono le uve, e quel record una cantina non ce l'ha
    nemmeno - e' una denominazione.
    """
    uve = [_senza_accenti(v).lower() for v in fatti.vitigni + fatti.vitigni_ammessi
           if len(v) > 3]
    if not uve:
        return []
    cantina = _senza_accenti(fatti.cantina or "").lower()
    fuori = []
    for m in _CONTESTO_PRODUTTORE.finditer(testo):
        chi = _senza_accenti(m.group(1)).lower()
        if cantina and cantina in chi:
            continue
        if any(re.search(r"\b" + re.escape(u) + r"\b", chi) for u in uve):
            fuori.append(f"«{m.group(1).strip()}» detto come produttore, ma sono le uve")
    return fuori


def _scheda_attaccata_al_vino(testo: str, fatti: Fatti, lingua: str) -> list[str]:
    """La scheda del vitigno appesa al nome del vino.

    «Morellino di Scansano: Italy's most planted grape and the soul of
    Tuscany»: quella e' la scheda del Sangiovese, e il Morellino e' il vino.
    La forma «{vitigno}: {scheda}» e' giusta e la composizione la usa; qui il
    nome davanti ai due punti e' quello sbagliato.
    """
    scheda = _senza_accenti(fatti.nota_in(lingua) or "").lower().strip()
    if len(scheda) < 24:
        return []
    inizio = re.escape(scheda[:24])
    fuori = []
    for nome in (fatti.nome, fatti.tipologia, fatti.denominazione):
        if not nome or len(nome) <= 4:
            continue
        n = _senza_accenti(nome).lower()
        if any(n in _senza_accenti(v).lower() or _senza_accenti(v).lower() in n
               for v in fatti.vitigni + fatti.vitigni_ammessi):
            continue        # un vino che si chiama come la sua uva: e' giusto
        if re.search(re.escape(n) + r"\s*:\s*" + inizio, _senza_accenti(testo).lower()):
            fuori.append(f"«{nome}» con la scheda del vitigno, ma e' il vino")
            break
    return fuori


# Dove un testo dice DOVE si fa: quel che segue e' un luogo.
_CONTESTO_LUOGO = re.compile(
    r"(?:si\s+produce\s+(?:in|a|nel|nella|nelle|nei|negli)\s+"
    r"|nasce\s+(?:in|a|nel|nella)\s+"
    r"|(?:is\s+)?produced\s+in\s+|made\s+in\s+|grown\s+in\s+)([^.;:!?]*)", re.I)


def _produttore_al_posto_del_luogo(testo: str, fatti: Fatti) -> list[str]:
    """Il nome della cantina messo dove va la regione.

    «Si produce in Produttori di Manduria»: quello e' chi lo fa, non dove si
    fa. Il modello impara la frase «Si produce in
    {regione}» e, quando la regione nei fatti non c'e', la riempie col primo
    nome proprio che trova.

    Si guarda solo la cantina, e solo se nel pezzo la regione non c'e': una
    denominazione E' quasi sempre anche un luogo - «si produce a Montalcino» -
    e bocciarla sarebbe un allarme falso.
    """
    cantina = _senza_accenti(fatti.cantina or "").lower().strip()
    if len(cantina) <= 4:
        return []
    regione = _senza_accenti(fatti.regione or "").lower()
    fuori = []
    for m in _CONTESTO_LUOGO.finditer(testo):
        dove = _senza_accenti(m.group(1)).lower()
        if regione and regione in dove:
            continue
        if cantina in dove:
            fuori.append(f"«{fatti.cantina}» detto come luogo, ma e' chi lo produce")
    return fuori


# Dove un testo dice con che cosa si beve: quel che segue e' un elenco di cibi.
_CONTESTO_ABBINAMENTI = re.compile(
    r"(?:si\s+accompagna\s+(?:bene\s+)?(?:a|con)\s+|da\s+(?:servire|accompagnare|abbinare)\s+con\s+"
    r"|(?:ideale|perfett[oa]|adatt[oa])\s+(?:per|su|a|con)\s+|abbinat[oa]\s+a\s+"
    r"|pairs?\s+(?:well\s+)?with\s+|serve\s+with\s+)([^.;:!?]*)", re.I)
_TANNINO = re.compile(r"\btannin\w*", re.I)


# Dove un testo dice che cosa si sente: quel che segue sono profumi, non cibi.
_CONTESTO_NOTE = re.compile(
    r"(?:note\s+(?:sensoriali\s+)?(?:tipiche\s+)?(?:di\s+)?|sentori\s+di\s+"
    r"|profuma\s+di\s+|al\s+naso\s+|aromi\s+di\s+|notes?\s+of\s+|aromas?\s+of\s+"
    r"|on\s+the\s+nose\s+)([^.;:!?]*)", re.I)


def _citazioni_come_si_dicono(fatti: Fatti, lingua: str) -> str:
    """Le citazioni del registro nella lingua in cui il racconto le dira'.

    In italiano sono quelle, parola per parola; in inglese sono una resa
    propria (vedi `amelie.organolettico`), e confrontare un testo inglese con
    la citazione italiana non trova niente: «from pale straw yellow to straw
    yellow» viene da «da giallo paglierino scarico a giallo paglierino», e
    senza la resa la ripetizione risulterebbe del racconto.
    """
    pezzi = list((fatti.disciplinare or {}).values())
    if lingua != "it" and fatti.disciplinare:
        from .organolettico import carica as carica_organolettico

        vocabolario = carica_organolettico()
        for ambito, testo in fatti.disciplinare.items():
            if (reso := vocabolario.rendi(testo, ambito, lingua=lingua)):
                pezzi.append(reso.testo)
    return _senza_accenti(" ".join(pezzi)).lower()


def _cibi_al_posto_dei_profumi(testo: str, fatti: Fatti, lingua: str) -> list[str]:
    """Piatti detti come profumi: «note sensoriali tipiche di manzo,
    cacciagione, agnello e pasta».

    Un controllo sui nomi lo promuove, perche' quelle parole stanno nei
    fatti - sono gli abbinamenti - ed e' l'errore che questo controllo
    cerca: un rapporto sbagliato fra parole vere. Lo specchio di
    `_note_al_posto_sbagliato`.
    """
    # Tradotti: in `fatti.abbinamenti` stanno le CHIAVI del vocabolario, che
    # sono inglesi («Beef»), e il testo dice «manzo».
    lex = carica()
    crudi = list(fatti.abbinamenti) + list(fatti.abbinamenti_in(lingua))
    piatti = {_senza_accenti(x).lower() for x in
              crudi + lex.traduci_molti("abbinamento", crudi, lingua=lingua)}
    piatti = {p for p in piatti if len(p) >= 4}
    fuori = []
    for m in _CONTESTO_NOTE.finditer(testo):
        pezzo = _senza_accenti(m.group(1)).lower()
        for p in piatti:
            if re.search(r"\b" + re.escape(p) + r"\b", pezzo):
                fuori.append(f"«{p}» detto come profumo, ma e' un piatto")
    return fuori


def _note_al_posto_sbagliato(testo: str, fatti: Fatti, lingua: str) -> list[str]:
    """Note olfattive dette come uve o come cibi.

    In minuscolo: il controllo sui nomi propri non le vede, e il modello le
    scrive cosi'. «Nasce dall'incontro di mela verde e fiori bianchi» e «da
    servire con amarena, prugna o tannino morbido» sono frasi fatte di parole
    dei fatti, messe dove non possono stare.
    """
    note = {_senza_accenti(n).lower()
            for n in list(fatti.note_sensoriali) + list(fatti.sensoriali_in(lingua))}
    note = {n for n in note if len(n) >= 4}
    fuori: list[str] = []
    for contesto, dove in ((_CONTESTO_VITIGNI, "vitigno"),
                           (_CONTESTO_ABBINAMENTI, "cibo")):
        for m in contesto.finditer(testo):
            pezzo = _senza_accenti(m.group(1)).lower()
            for n in note:
                if re.search(r"\b" + re.escape(n) + r"\b", pezzo):
                    fuori.append(f"«{n}» detta come {dove}")
            if dove == "cibo" and _TANNINO.search(pezzo):
                fuori.append("tannino servito come cibo")
    return fuori
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
