destone28/Amelie2.0/(commit log)

2026-09-05 Impianto del progetto: struttura, licenze, collaudo board, testo OCR e cattura
    - struttura del repository (src/amelie, firmware, data, scripts, docs, tests)
    - doppia licenza: GPL-3.0 sul codice, CC BY 4.0 su documentazione e file di stampa
    - scripts/00_diagnostica.sh: collaudo della UNO Q, verifica i quattro rischi
    che possono cambiare il progetto (alimentazione, video, audio, CPU)
    - docs/01-PRIMO-AVVIO.md: flash con rootfs ampia, rete, accesso, collaudo
    - amelie.text: normalizzazione del testo OCR, riparazione delle cifre
    travestite nell'annata, filtro delle parole presenti su ogni etichetta
    - amelie.capture: raffica con scarto dei fotogrammi vecchi del buffer UVC,
    selezione per varia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
2026-09-05 Macchina a stati dell'interazione
    Logica pura, senza I/O: riceve eventi e produce transizioni ed effetti che
    l'orchestratore esegue. Cosi' l'intera interazione si collauda senza hardware.
    - nove stati, dal respiro dell'anello in attesa al racconto concluso
    - togliere la bottiglia ha la precedenza su tutto e zittisce il racconto
    - un evento senza senso non e' un errore: il sensore rimbalza e l'utente tocca
    a caso, la macchina non deve piantarsi
    - match assente non e' un fallimento: si racconta comunque, a scendere
    - 152 test, inclusa la matrice completa stato x evento
2026-09-05 Lettura dell'etichetta con RapidOCR
    - immagine a COLORI nativa, non un canale singolo: su etichetta oro su rosso
    scuro il canale blu produce zero rilevamenti, perche' oro e rosso scuro
    riflettono entrambi poco blu
    - classificatore di orientamento disattivato: sul supporto l'etichetta e'
    sempre dritta
    - caricamento pigro del motore, cosi' l'avvio non paga i secondi di ONNX
    - accetta entrambi i formati di uscita di RapidOCR (3.x a oggetto e il
    precedente a tuple): il pacchetto sulla board puo' non essere quello del PC
    - righe_grandi() isola il testo scritto in grande, dove sta la denominazione
2026-09-05 Prova dell'audio HDMI: la voce puo' uscire dal jack dello schermo
    Il percorso audio HDMI esiste gia' nell'immagine della UNO Q: il kernel ha
    CONFIG_SND_SOC_HDMI_CODEC, il DTB caricato al boot contiene 'hdmi-i2s-dai-link'
    e 'HDMI/I2S Playback', e il pacchetto ALSA del costruttore porta un profilo
    UCM dedicato per qcm2290. Nessuno pero' ha mai dimostrato pubblicamente che
    funzioni: la issue e' aperta e senza seguito. Non e' rotto, e' non provato.
    Lo script decide in dieci minuti, senza comprare niente:
    - verifica profilo UCM del costruttore, DMI, device tree e stato del DisplayPort
    - alza 'SEC_MI2S_RX Audio Mixer MultiMedia4', il gate che con lo 0 fa uscire
    silenzio mentre aplay riporta suc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
2026-09-05 Riconoscimento del kernel Arduino: servono 8 cifre esadecimali
    Il glob '-g*' catturava anche '-generic', dando per Arduino qualunque kernel.
2026-09-05 Fonti dati sul vino: snapshot versionati e attribuzioni
    Il dispositivo e' offline e il repo deve poter ricostruire il database anche
    fra un anno, quando un endpoint potrebbe non rispondere piu': gli snapshot
    delle fonti si versionano, il database si ricostruisce.
    - data/sources/PDO_wine_data_IT_FR.csv (CC BY 4.0): 4.308 righe italiane con
    la TIPOLOGIA di ogni denominazione - colore, categoria, vitigni principali,
    vitigni ammessi, rese. E' la granularita' giusta: e' quella che si legge
    sull'etichetta. Tipologie distinte reali 4.078, le righe hanno duplicati.
    - data/sources/EU_PDO_id_varieties.csv (CC BY 4.0)
    - docs/ATTRIBUZIONI.md: ogni fonte con la sua licenza, e le quattro scartate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
2026-09-05 X-Wines: sottoinsieme italiano, contenuti bilingui e set di prova OCR
    Il repository X-Wines scaricato pesa 1,9 GB, di cui 1,1 GB sono 21 milioni di
    valutazioni utente destinate ai sistemi di raccomandazione: non servono. Si
    versiona il derivato, non la sorgente.
    - data/estrai_xwines.py estrae i 19.358 vini italiani (6,5 MB) e il manifesto
    delle 139 etichette italiane fotografate, con la scheda nota accanto: e' il
    primo set di regressione OCR su etichette VERE che abbiamo. Le fotografie
    non si ridistribuiscono - sono opere grafiche di produttori terzi - ma
    chiunque abbia scaricato X-Wines le ricostruisce con --estrai-immagini.
    - data/lessico/vocabolari.json: 85 termini in italiano e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
2026-09-05 Banco di prova OCR su etichette vere, e due difetti che ha trovato
    Le 139 etichette italiane di X-Wines hanno la scheda nota accanto, quindi si
    misura invece di stimare. Prima avevamo solo estrapolazioni su immagini
    sintetiche.
    Difetto 1 - 'boxes' e 'scores' di RapidOCR sono array numpy: il costrutto
    'getattr(...) or default' solleva ValueError perche' la verita' di un array
    con piu' elementi e' ambigua. Confronto con None esplicito.
    Difetto 2, il piu' insidioso - da 'Grigio' veniva estratta l'annata 1910.
    La riparazione delle cifre travestite trasforma G->6, i->1, g->9, i->1, o->0,
    e dentro '6r1910' compare un anno che non esiste: il dispositivo avrebbe detto
    «Pinot Grigio 1910». Sul te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
2026-09-05 Collaudo sulla board vera: tre correzioni agli script
    Prima volta sull'hardware. Gli script vanno corretti su tre punti che solo la
    board poteva rivelare.
    1. Il controllo del device tree cercava la stringa 'HDMI/I2S' dentro il file
    /boot/efi/dtb/qcom/qrb2210-arduino-imola.dtb. Su questa immagine quel file
    NON ESISTE: /boot/efi/dtb/qcom contiene la collezione DTB completa di
    upstream (apq8016, apq8096...). Il controllo dava quindi un falso negativo
    su una board dove l'audio HDMI e' perfettamente cablato. Ora si interroga
    /proc/device-tree, cioe' l'albero effettivamente caricato, che elenca
    'HDMI/I2S Playback' insieme agli altri dai-link.
    2. Il nome del controllo mixer non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
2026-09-05 Video: leggere da sysfs, non da xrandr
    Via SSH xrandr non ha l'autorizzazione X del greeter e fallisce anche quando
    lo schermo funziona perfettamente: la diagnostica dava 'DP-1 non connesso' su
    una board dove il DisplayPort era connesso, abilitato e con 21 modalita'
    disponibili. /sys/class/drm e' il kernel e non dipende da chi sta guardando.
    Il controllo ora elenca le modalita' e dice esplicitamente se 800x480 c'e'.
    Sulla board reale c'e', ed e' la prima della lista: la previsione della
    ricerca - '800x480 va considerata non disponibile, pilotare 1280x720 e
    lasciare scalare il pannello' - era pessimistica. L'EDID resta vuoto in
    sysfs, ma le modalita' sono popolate lo stesso, quindi non serve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
2026-09-05 La camera si cerca per nome, non per numero
    Sulla board l'ordine di /dev/videoN cambia da un avvio all'altro: il codec
    Venus del SoC si prende volentieri video0 e video1 e la camera finisce piu' in
    la'. In un avvio la InnoMaker era su video0, in quello dopo il Venus se l'era
    preso. Hardcodare /dev/video0 significa, un avvio su due, fare l'OCR
    sull'uscita di un decoder video.
    Ora si risolve per nome fra i collegamenti stabili di /dev/v4l/by-id, che sono
    costruiti su vendor, modello e numero di serie e sopravvivono ai riavvii. Si
    prende l'index0, che e' il nodo di cattura: l'index1 dei dispositivi UVC porta
    solo metadati e non produce fotogrammi. Se by-id non c'e' ancora (udev non
    ancora gira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
2026-09-05 Comando di riserva per la prova audio
    scripts/suona.sh: alza il gate del mixer, sceglie da sola la scheda e suona sul
    PCM 3. Quando l'audio 'non va', dice in dieci secondi se il problema e' la
    catena hardware o il software sopra; se la scheda manca del tutto riconosce la
    corsa all'avvio e lo dichiara.
    STATO DELLA PROVA: sul lato software la catena regge - il PCM hw:0,3 accetta lo
    stream, il tono viene riprodotto su entrambi i canali senza errori, il gate
    'SEC_MI2S_RX Audio Mixer MultiMedia4' e' alzato. Se il suono esca davvero dal
    jack del pannello NON e' ancora verificato: serve l'ascolto con una cassa
    collegata. Finche' non c'e', l'audio HDMI resta NON PROVATO - non rotto, non
    funzionante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
2026-09-05 Video: 1280x720 e' la modalita' di produzione, e lo schermo non deve dormire
    Verificato guardando il pannello, che e' l'unico criterio che conta.
    800x480 NON FUNZIONA, benche' xrandr la elenchi per prima e la marchi come
    preferita: si attiva senza errori e il pannello resta nero. E' il modo di
    fallire documentato su questa board, e la conclusione precedente - '800x480
    disponibile, la previsione della ricerca era pessimista' - era sbagliata: si
    era preso cio' che dice il software per cio' che fa l'hardware. La ricerca
    aveva ragione, e anche sulla cura: pilotare 1280x720 e lasciare che sia il
    pannello a scalare sui suoi 800x480 fisici.
    1920x1080 funziona ma il testo risulta minuscolo. 1280x7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
2026-09-05 Esclusioni locali fuori dal .gitignore versionato
    Il repository diventera' pubblico: le directory degli strumenti di sviluppo di
    chi ci lavora non hanno ragione di comparirci. Stanno in .git/info/exclude, che
    resta sulla macchina.
2026-09-05 Database dei vini, conoscenza enologica, e documento di ripresa
    data/build_db.py costruisce l'intero sapere del dispositivo dagli snapshot
    versionati: 408 denominazioni, 4.301 tipologie, 19.358 vini commerciali
    italiani, 619 vitigni, 31,6 MB. Il dispositivo non si connette mai, quindi
    tutto cio' che sa deve stare li' dentro.
    La scelta di schema che regge tutto e' 'tipologia_vitigno.ruolo': il
    disciplinare dell'Amarone IMPONE Corvina, Corvinone e Rondinella e AMMETTE
    anche Croatina, Barbera, Cabernet e altri quarantatre'. Appiattirli in una
    lista sola farebbe dire al modello che quell'Amarone contiene Croatina.
    Verificato sul database costruito: Croatina risulta fra gli ammessi e NON fra
    i p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
2026-09-06 Riconoscimento: la sicurezza e' una proprieta' dell'affermazione
    amelie.matcher porta dal testo OCR al record con una cascata che scende finche'
    trova qualcosa di vero da dire: vino -> tipologia -> denominazione -> vitigno.
    Non risponde mai 'non lo so'.
    Misurato sul testo OCR reale delle 139 etichette: 96,4% coerente con
    l'etichetta, 2,9% incoerente, e di questi tre casi su quattro restano sotto
    soglia - il dispositivo chiede conferma invece di sbagliare.
    DUE DIFETTI TROVATI DALLA MISURA, entrambi della stessa famiglia.
    'Monte Antico' diventava il vino 'Monte Giove' con sicurezza 88, cioe' CERTO.
    E 'Rosso' da solo diventava 'Appassimento Rosso Passito' di 'Falco Rosso' con
    sicurezza 100.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
2026-09-06 Guardia audio: il guasto e' misurato, il recupero e' provato
    MISURA: 2 avvii muti su 6, il 33%. Il softdep upstream non basta - aiuta, ma il
    device ausiliario del pd-mapper nasce dentro rproc_boot(), quindi l'ADSP puo'
    interrogarlo prima che il driver si sia agganciato.
    RECUPERO PROVATO SUL GUASTO VERO: riavviare il solo remoteproc dell'ADSP
    riporta i device aprbus in UN secondo e la scheda audio torna. Nessun riavvio
    del dispositivo necessario.
    Tre correzioni imposte dalla verifica avversariale, tutte su codice tenuto in
    quarantena e che NON e' stato installato:
    1. 'modprobe -r apr' e l'unbind del driver apr possono far cadere il kernel.
    Eliminati, non declassati. L'unico percorso pul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
2026-09-06 Il racconto: i fatti dal database, lo stile dal modello
    amelie.narrator, difesa a quattro strati contro l'invenzione:
    cache pre-generata -> modello vincolato -> verifica deterministica -> template.
    La verifica non e' una preferenza espressa nel prompt, e' codice Python che il
    modello non puo' aggirare: ogni numero e ogni nome proprio del testo generato
    deve comparire nei fatti, altrimenti il testo si scarta e si rigenera una volta
    sola. Provato: 'ha vinto i Tre Bicchieri del Gambero Rosso' e 'sulle colline di
    Serralunga, a 400 metri' vengono entrambi scartati.
    Il tono cambia con il livello della cascata, ed e' il punto che rende onesto il
    dispositivo. Al primo gradino afferma: «Questo e'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
2026-09-06 Modello linguistico: misurato, e il prefill e' il vincolo vero
    MISURA SULLA BOARD, Gemma 3 1B Q4_K_M sui quattro Cortex-A53:
    prefill ~8 token/s
    generazione ~4,2 token/s
    Il prefill e' la sorpresa. Un prompt da 270 token costa 34 secondi PRIMA di
    produrre una parola, e una generazione completa a freddo ne ha richiesti 55.
    Con il prefisso in cache la stessa richiesta scende a 0,8 s.
    Da qui tre conseguenze di progetto:
    - le istruzioni fisse stanno all'inizio del prompt e i fatti in fondo, cosi'
    --cache-reuse riconosce il prefisso gia' elaborato;
    - llama-server gira come servizio residente con MemoryMax=1400M: il tetto fa
    fallire il servizio invece di mandare tutto in swap su eMMC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
2026-09-06 Ponte verso l'MCU e firmware
    Il Qwiic della UNO Q sta sull'I2C4 dello STM32U585, non di Linux: i due anelli
    di LED e il sensore di distanza li vede solo il microcontrollore. Il protocollo
    del router e' MessagePack-RPC standard su /run/arduino-router.sock, verificato
    sondandolo: una richiesta [0, msgid, metodo, parametri] riceve
    [1, msgid, errore, risultato].
    amelie.bridge parla quel protocollo direttamente, senza il pacchetto Python di
    Arduino che non e' installabile fuori dai container di App Lab. C'e' anche un
    PonteSimulato che registra i comandi invece di inviarli, per collaudare
    orchestratore e interfaccia su un portatile.
    La classe Presenza filtra il sensore con isteresi ASIMMETRICA,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
2026-09-06 Interfaccia kiosk e orchestratore
    L'interfaccia e' disegnata per 1280x720 scalati sui 800x480 fisici del pannello,
    quindi tutto e' grande: 32 px qui diventano 20 reali, che a mezzo metro si
    leggono. Sotto i 28 px non si scende. Fondo caldo, serif, nessun puntatore.
    Il testo del racconto compare frase per frase al ritmo della voce, non tutto
    insieme: se arrivasse in blocco mentre la voce comincia, si leggerebbe la fine
    mentre si ascolta l'inizio.
    L'orchestratore tiene insieme sensore, camera, riconoscimento, voce e schermo in
    un solo processo. La regola che decide l'architettura: NIENTE gira in parallelo.
    OCR, modello e voce si contendono gli stessi quattro core e sono tutti e tre al
    limite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
2026-09-06 Kiosk, servizio principale e installazione riproducibile
    Non esiste un modo affidabile di clonare la eMMC di una UNO Q: il dd
    ripristinato su un'altra board va in kernel panic. scripts/install.sh E' il
    modo di riprodurre il dispositivo.
    Chromium in chiosco con tetto di memoria: su 3,6 GiB condivisi con un modello
    da 800 MB non c'e' margine per un browser lasciato libero, e Chromium e'
    adattivo - con un tetto si comporta da dispositivo piccolo.
    Il servizio dell'applicazione ha Restart=always ma nessuna dipendenza dura dal
    modello o dall'MCU: un Amelie che non parte e' peggio di un Amelie parziale.
    Se manca qualcosa si avvia lo stesso e lo dichiara sulla pagina di stato.
    Il kiosk aspetta ch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
2026-09-06 README, e la cache separa il corpo dall'apertura
    Difetto trovato al primo testo pre-generato: in cache finiva la frase «Del
    produttore non sono sicuro, ma il vitigno si'», che e' una frase DI RUNTIME. Un
    testo pre-generato non puo' sapere se l'etichetta e' stata letta bene: se poi la
    bottiglia viene riconosciuta con certezza, quella apertura e' falsa.
    Ora in cache va solo il CORPO neutro, e l'apertura - che dice quanto siamo
    sicuri - si compone al momento. Il prompt di pre-generazione lo dice al modello,
    cosi' non ripete il nome del vino che l'apertura ha gia' detto.
    Corretto anche il registro: il modello apriva con «La vostra visita e' un
    piacere» e si rivolgeva all'ospite. Le istruzi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
2026-09-06 Il colore contraddetto: l'errore che un sommelier coglie all'istante
    Generando sul serio, il modello ha scritto che la Falanghina - vitigno a bacca
    BIANCA - e' «un vino rosso di campagna, con tannicita' bassa». Non e'
    un'imprecisione: e' falso, e in sala e' esattamente la figura che il progetto
    deve evitare.
    Due cause.
    La prima: nei fatti di livello vitigno NON c'era il colore della bacca. Il
    modello non poteva saperlo, e ha tirato a indovinare nella direzione piu'
    probabile - «vino» e «rosso» stanno vicini nella testa di un modello piccolo.
    Ora il colore c'e'.
    La seconda: la verifica cercava numeri e nomi propri, e «rosso» non e' ne'
    l'uno ne' l'altro. Aggiunto un controllo deter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
2026-09-06 OCR alla risoluzione reale: 5,2 s, e la contesa sulla CPU raddoppia tutto
    Rimisurato alla dimensione che la camera produce davvero - 1920x1080 ritagliato
    al 58%, cioe' 1114x626 - l'OCR costa 5,2 s, non i 3,75 misurati sulle immagini
    di prova da 480x640. Ridimensionare non aiuta: il costo non sta nella dimensione
    dell'immagine, e 520 px danno lo stesso tempo di 1114.
    Il fattore che conta e' un altro: con il lotto di pre-generazione in corso le
    stesse misure davano 11-12 secondi, PIU' DEL DOPPIO. OCR e modello si contendono
    gli stessi quattro core, e il carico medio era 6,4 su 4.
    Da qui una correzione al progetto: la pre-generazione interroga /stato
    dell'applicazione e si ferma da sola appen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
2026-09-06 Il modello e' spento in modo predefinito, e il perche' e' documentato
    Tre strade provate sulla board, tre fallimenti, tutti misurati.
    Gemma 3 1B da zero: 456 testi, 103 scartati dalla verifica. Dei 353 passati,
    'La Falanghina e' un'annata di media eta'', 'Il colore della bacca e' bianco'
    - recita l'etichetta del campo - e 'leggera effervescenza' inventata.
    Qwen 2.5 1.5B: peggiore e piu' lento. 'Nell'acqua di questo vino', frasi
    ripetute due volte, e '*Barolo**' su una richiesta semplice.
    Riscrittura del template - la strada su cui si contava di piu', perche' chiede
    stile e non conoscenza: ha letto 'Campana' come uno strumento musicale, ha
    INVERTITO il colore del Nebbiolo (il template dice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
2026-09-06 Le correzioni della verifica avversariale
    Un difetto BLOCCANTE e due che si sarebbero visti in sala. Nessuno dei 313 test
    li vedeva.
    1. SQLITE ATTRAVERSO I THREAD. Matcher e Narratore creavano la connessione nel
    thread principale e la usavano nel thread di lavoro. check_same_thread e'
    True per difetto, quindi ogni ricerca sollevava ProgrammingError, _protetto
    la catturava e la macchina finiva in GUASTO: NESSUN VINO SAREBBE MAI STATO
    RICONOSCIUTO. Il test che attraversa il thread passava righe vuote e cerca()
    ritornava prima di toccare la connessione: passava per la ragione sbagliata.
    Ora check_same_thread=False piu' un lock, che non costa nulla perche' la
    pipeline e' gi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
2026-09-06 Attribuzioni: X-Wines e i Gemma Terms
    Due obblighi mancanti che avrebbero reso la pubblicazione scorretta.
    X-WINES era assente da docs/ATTRIBUZIONI.md mentre xwines_italia.csv e'
    tracciato e sta per diventare pubblico. Il README del dataset impone la
    citazione del paper a chiunque pubblichi materiale che ne derivi. Aggiunta la
    citazione completa e il chiarimento sulla licenza, che diverge davvero a
    seconda di dove si guarda: CC0 nel file LICENSE, ODbL sulla pagina Kaggle,
    'free license' nel pacchetto scaricabile. Il progetto si comporta come se fosse
    ODbL, l'ipotesi piu' restrittiva, cosi' soddisfa tutte e tre senza dover
    stabilire quale valga.
    GEMMA non e' open source: e' sotto i Gemma Te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
2026-09-06 Il ciclo arriva in fondo: correzioni dalla verifica avversariale
    Il difetto che contava piu' di tutti: ogni passo della pipeline e' avviato dal
    passo precedente, cioe' DAL thread di lavoro. Il controllo `is_alive()` in
    _avvia trovava quindi vivo un thread che era se' stesso, si dichiarava occupato
    e mandava tutto in guasto. Su ogni bottiglia, sempre: il dispositivo non
    raccontava nulla. Nessun test lo vedeva perche' tutti spingevano gli eventi a
    mano dal thread del test, dove il difetto non si manifesta.
    TestCicloCompleto percorre ora il ciclo come lo percorre una bottiglia vera,
    con camera e OCR finti che restituiscono righe vere: rimettendo il difetto,
    quattro dei suoi test falliscono.
    G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
2026-09-06 Il vino generico che ogni bottiglia sa raggiungere, in due lingue
    Una bottiglia di cui non si conosce il produttore deve comunque avere qualcosa
    di vero da dire: il suo vino generico. Perche' funzioni servono tre cose, e
    mancavano tutte e tre.
    L'impalcatura delle frasi era italiana cablata. I vocabolari traducevano le
    PAROLE, ma i periodi che le tengono insieme no: con lingua="en" il dispositivo
    avrebbe detto parole inglesi dentro frasi italiane. Ora le frasi stanno in
    data/lessico/frasi.json, una per lingua, e nel narratore resta solo la logica
    di quale dire.
    Se ne approfitta per uniformare il registro, che era incoerente: lo schermo
    dava del lei ("Provi a girarla") e il racconto del tu (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
2026-09-06 Il ripiego sul vino generico, e il corpus in italiano e inglese
    Una bottiglia di cui non si riconosce il produttore deve ricadere sulla
    descrizione del suo vino generico. Il Primitivo di Manduria della Cooperativa
    Produttori Vini Manduria, se non ha un testo suo, si racconta col Primitivo di
    Manduria e basta.
    Il ripiego scende per IDENTIFICATIVO, non ricercando il nome. Cercare
    "Primitivo di Manduria" fra i nomi puo' riportare al vino di un altro
    produttore - e' lo stesso errore che c'era in `scegli`, dove toccare un
    candidato rifaceva la ricerca invece di comporre il record scelto. La catena la
    costruisce il matcher, che e' l'unico a sapere come sono legate le tabelle; il
    narratore si limi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
2026-09-06 La lingua si sceglie a schermo, con un tocco
    Due bandierine in alto a sinistra, dove non coprono ne' il titolo ne' il testo.
    Il bersaglio e' 64x44 nello spazio scalato, cioe' 40x28 fisici: e' il minimo
    che un dito centra al primo colpo su un pannello da cinque pollici. Le scritte
    sono piccole di proposito - la lingua non e' la scena, la bottiglia lo e' - il
    bersaglio no.
    Si puo' cambiare ANCHE a racconto in corso, e la storia riparte subito nella
    lingua nuova senza chiedere di rimettere la bottiglia: i fatti sono gia' in
    mano e si portano dietro tutte le lingue proprio per questo. Serviva una
    transizione nuova, (RACCONTO, RIPETI): senza, l'evento cadeva nel vuoto e
    cambiare lingua mentre pa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
2026-09-06 Una voce inglese con la licenza pulita, e nessuna attesa nel cambio
    La voce inglese non si sceglie a gusto. Le piu' diffuse di Piper poggiano tutte,
    direttamente o per rifinitura, sul dataset Blizzard Challenge 2013, che vieta
    esplicitamente "any commercial purpose, including the development, marketing,
    commercialisation, sale or licencing of voice synthesis products". E' la stessa
    ragione per cui questo progetto usa `serena` e non `paola`.
    Sull'inglese la trappola e' piu' insidiosa: le schede di `en_GB-alba` e
    `en_US-libritts_r` dichiarano entrambe CC BY 4.0 - ma e' la licenza del dataset
    di RIFINITURA, e piu' sotto entrambe dicono "Finetuned from ... lessac".
    Guardare la riga della licenz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
2026-09-06 Chiudere il database sotto chi ci legge era un segmentation fault
    Si vedeva solo sulla board, perche' li' i test girano nell'ambiente vero: un
    thread di lavoro era ancora dentro `_dalla_cache` quando la fixture chiudeva la
    connessione SQLite, e il processo moriva. Non un'eccezione che si cattura, un
    crash: nove moduli di test interrotti in blocco.
    Il lucchetto c'era gia' - serve perche' la connessione nasce nel thread
    principale e viene usata in quello di lavoro - ma era stato messo a pezzi, e
    meta' delle query lo scavalcava: la ricerca FTS, tutta la composizione dei
    fatti, la chiusura. Ora e' RIENTRANTE, perche' questi metodi si chiamano fra
    loro, e sta su un decoratore invece che su un ri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
2026-09-06 Un racconto che si comanda, e un'interfaccia rifatta per il dito
    IL PLAYER. Play/pausa, avanti e indietro di cinque secondi, da capo. Il resto
    dello schermo non reagisce: su un tavolo di ristorante un tocco accidentale e'
    la norma, non l'eccezione.
    Il pezzo che rende possibile il resto e' `Riproduttore`. Il PCM e' lineare, e
    un secondo di parlato sono sempre gli stessi byte: saltare avanti di cinque
    secondi e' aritmetica su un offset. C'e' una sola verita', la POSIZIONE dentro
    il buffer, e tutto si ricava da li' - i secondi trascorsi, la frase da
    illuminare, dove ripartire dopo una pausa.
    Prima il testo a schermo avanzava a stima, con uno sleep proporzionale alla
    lunghezza della frase, men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
2026-09-07 Il marchio: la A dentro una bottiglia, inquadrata
    Tre segni e nient'altro: i quattro mirini agli angoli, la bottiglia al centro,
    la A dentro la bottiglia - dove sta l'etichetta. Letto tutto insieme dice cosa
    fa l'oggetto: inquadra una bottiglia e la legge. E il nome ci sta dentro.
    Tratti, non contorni pieni: resta nitido a ogni misura e non dipende da nessun
    font installato.
    Il banco di prova delle schermate passa da una cartella temporanea, che si
    svuota, a scripts/anteprima_ui.py: quello strumento e' l'unico modo per
    guardare le viste che dal vetro non si raggiungono a comando - il racconto col
    player, la conferma, il guasto, il caso senza voce.
2026-09-07 La rotta audio, e perche' non usciva un suono
    Il suono non esce finche' un solo controllo del mixer resta chiuso, e quel
    controllo torna a zero a ogni avvio: non e' memorizzato da nessuna parte.
    MultiMedia4 (hw:0,3) -> SEC_MI2S_RX -> I2S -> ANX7625 -> HDMI
    -> schermo -> jack 3,5 mm
    Il tempo perso e' andato quasi tutto sui due impostori. La scheda espone anche
    "DISPLAY_PORT_RX Audio Mixer MultiMedia4" e "HDMI Mixer MultiMedia4": hanno il
    nome giusto, si aprono senza protestare, e non servono a niente su questa
    board. Con quelli aperti il PCM si apre lo stesso e poi il DSP rifiuta la
    registrazione dello stream con "q6asm_dai_prepare: stream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
2026-09-07 La lingua si annuncia a voce, e il racconto riparte davvero
    Toccando la bandierina il dispositivo dice "Lingua italiana" o "English
    language". Serve a due cose insieme: conferma che la lingua e' cambiata, e
    conferma che l'audio funziona - che e' il modo piu' rapido di provare
    amplificatore e casse senza appoggiare una bottiglia. Per questo l'annuncio si
    fa anche toccando la lingua GIA' attiva, che non cambia niente: altrimenti per
    riprovare l'audio bisognerebbe alternare avanti e indietro.
    Le due frasi sono fisse e si pre-sintetizzano all'avvio insieme alle voci:
    escono all'istante invece di costare un secondo di silenzio dopo il tocco. Due
    tocchi ravvicinati si accavallano invece di accoda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
2026-09-07 Un annuncio alla volta, e per intero
    Toccando le bandierine non si sentiva niente, ne' in cuffia ne' in cassa,
    mentre il test diretto con aplay si sentiva. Il registro ha dato la risposta:
    otto tocchi in nove secondi, molti a mezzo secondo l'uno dall'altro.
    Le frasi durano un secondo abbondante, e ogni tocco zittiva quella in corso -
    comportamento scritto apposta perche' due tocchi non si accodassero. Il
    risultato e' che nessuno degli otto annunci ha mai avuto il tempo di uscire.
    Sembrava un guasto dell'amplificatore, ed era il software.
    Ora gli annunci si fanno UNO ALLA VOLTA e per INTERO. Il primo tocco parla
    subito; chi tocca mentre quello parla non lo interrompe, lascia detto cosa
    vuol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
2026-09-07 Silenzio davanti e dietro, o le frasi corte spariscono
    Toccando le bandierine si sentiva "un piccolo rumore senza voce", mentre i
    nove secondi del racconto sul vino si sentivano. Quella differenza era il
    sintomo, e misurandola si e' visto perche'.
    Misurato sulla board, su quattro durate diverse:
    atteso 3,0 s -> aplay ha impiegato 2,69 s (-0,31)
    atteso 1,5 s -> aplay ha impiegato 1,13 s (-0,37)
    atteso 1,0 s -> aplay ha impiegato 0,65 s (-0,35)
    Sempre 0,35 s in meno, qualunque sia la durata: `aplay` esce prima che
    l'ultimo pezzo sia stato reso davvero, e il DSP comincia a rendere qualche
    decimo dopo l'apertura del flusso. Su nove secondi di racconto sono briciole;
    su una f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
2026-09-07 Il flusso audio non si chiude mai: il DSP ci mette due secondi ad avviarsi
    Si sentiva solo l'ultima sillaba: "a" di "Lingua italiana", forse la coda di
    "language". Di sei bip a un secondo l'uno dall'altro se ne sono sentiti
    QUATTRO, e quel conto e' la misura che serviva: il DSP di questa board impiega
    circa DUE SECONDI a cominciare a rendere il suono dopo l'apertura del flusso.
    Imbottire di silenzio era un cerotto, e si toglie: con due secondi da coprire
    ogni annuncio sarebbe partito con due secondi di ritardo, e i primi due
    secondi del racconto - quelli che dicono che vino e' - sarebbero spariti lo
    stesso.
    Ora il flusso si apre all'accensione e non si chiude piu'. Quando non c'e'
    niente d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
2026-09-07 Un test che guardava un dettaglio interno in corsa
    test_si_puo_cambiare_lingua_mentre_parla asseriva che _ferma_voce fosse
    acceso subito dopo il cambio lingua. Ma il racconto nuovo lo azzera appena
    riparte, quindi a seconda di come si incastrano i thread lo si trova acceso o
    spento: verde qui, rosso sulla board sotto carico. Ora si guarda il fatto - che
    la storia sia ripartita - invece dell'istante.
2026-09-07 La didascalia segue la voce, non la scrittura
    In basso compare cio' che il dispositivo sta dicendo, una frase per volta, coi
    caratteri e i colori del resto dell'interfaccia.
    Il punto delicato e' QUANDO cambiarla. Fra lo scrivere una frase nel flusso e
    il sentirla ci sono la riserva dell'uscita e il buffer di ALSA - mezzo secondo -
    e agganciarla alla scrittura la farebbe correre avanti alla voce di quel mezzo
    secondo. Su una frase da un secondo si vede. Il server la manda quando la frase
    precedente e' uscita DAVVERO. Verificato a schermo: al secondo dal tocco si
    legge la prima frase, a tre secondi e mezzo la seconda.
    L'attesa che serve a sincronizzarla si paga solo se qualcuno la sta guarda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
2026-09-07 Il testo compariva uno o due secondi prima della voce
    Lo scarto si notava subito. L'errore stava in un punto gia' incontrato e poi
    dimenticato.
    Si aspettava che la PROPRIA coda si svuotasse per dire "questa frase e' stata
    sentita". Ma i byte usciti dalla coda non sono usciti dalle casse: finiscono
    nella pipe del sistema, che a 22050 mono tiene 64 KB, cioe' UN SECONDO E MEZZO
    di parlato, e poi nel buffer di ALSA. "Uscito dalla coda" non voleva dire
    "sentito", e la differenza era esattamente il ritardo che si vedeva.
    Due correzioni, e servono entrambe.
    Il flusso ora scorre a PASSO D'OROLOGIO invece che a riempimento: si scrive al
    ritmo del suono, tenendo un vantaggio dichiarato di 0,25 s, e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
2026-09-07 Il primo assemblaggio da banco, e tre cose scoperte provandolo
    docs/06-ASSEMBLAGGIO-BANCO.md: come mettere Distance e i due Pixels sul tavolo
    per provare il giro completo prima di chiudere tutto nella scocca. Le distanze
    non sono a occhio: vengono dalle soglie che il codice usa davvero - sotto 40 mm
    per tre letture la bottiglia c'e', sopra 70 mm per cinque non c'e' - e
    l'inquadratura dal ritaglio centrale al 58%, oltre il quale non si legge nulla.
    Scrivendola si e' provato ogni comando invece di ricordarlo, e sono usciti tre
    difetti.
    1. LO SKETCH NON ERA MAI STATO COMPILATO. Include ModulinoPixels.h e
    ModulinoDistance.h, che Arduino_Modulino 0.9.0 NON espone: c'e' solo
    Modulino.h. Il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
2026-09-07 Il firmware cerca i moduli invece di darli per collegati
    Con lo sketch corretto caricato, `distanza` smetteva di dire «method not
    available» e cominciava a dire «timed out»: i metodi si registravano, ma il
    loop si fermava su `tof.available()` con nessun sensore attaccato. Un progresso
    solo apparente — il dispositivo restava muto, e per un motivo diverso.
    Ora il microcontrollore sonda il bus prima di parlarci: `Wire1` interrogato
    all'indirizzo, e `begin()` chiamato solo su chi risponde. Il sondaggio si
    ripete ogni due secondi, così durante il montaggio si collega un pezzo per
    volta e prende vita da solo, senza riavviare niente.
    Da qui il metodo nuovo, `moduli()`, che risponde quali d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
2026-09-08 Il volume dal vetro, e uno schermo che non mostra altro
    Tre cose che si tengono: regolare il volume toccando lo schermo, coprire i
    quaranta secondi dell'accensione, e non far comparire mai nient'altro.
    ── IL VOLUME ────────────────────────────────────────────────────────────────
    Questa catena audio NON HA un controllo di volume hardware. Il suono esce da
    SEC_MI2S_RX, attraversa l'I2S, il ponte ANX7625 e l'HDMI: i controlli chiamati
    «Volume» che il mixer ALSA espone - HPHL, HPHR, RX_RX* - appartengono al codec
    delle cuffie del SoC, che sta su un altro percors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
2026-09-09 Un anello solo, e la luce dello scatto diventa l'anello
    Il secondo Modulino Pixels — quello che faceva da flash per la camera — non c'e'
    piu'. Restano due moduli: l'anello alla base della bottiglia e il sensore di
    distanza, tutti e due all'indirizzo di fabbrica.
    Sparisce con lui il passo piu' fragile del montaggio. I Pixels nascono TUTTI a
    0x36, quindi il secondo andava riprogrammato una volta per sempre con uno sketch
    a parte, togliendo e ridando corrente perche' l'indirizzo nuovo si legge solo
    dopo — e da fuori i due moduli restano identici, cosi' chi scambiava i cavetti si
    ritrovava il flash sotto la bottiglia e l'anello puntato sull'etichetta.
    L'etichetta si illumina lo stesso: l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
2026-09-09 Un numero di protocollo, perche' i bit hanno cambiato significato
    Il rilievo piu' tagliente della verifica, e riguarda proprio la board com'e'
    adesso: il firmware caricato e' ancora quello con due Pixels.
    Quando il secondo modulo e' stato tolto, il bit 2 di `moduli()` e' passato da
    "flash" a "sensore" mentre il sensore lasciava il bit 4. Un Linux nuovo che
    interroga quell'MCU direbbe "sensore presente" con il flash collegato, e
    "sensore assente" con il sensore collegato. E' il guasto peggiore che si possa
    avere con i cavetti in mano - il montaggio e' giusto e il dispositivo dice di no
    - ed e' silenzioso: nessuno degli strumenti se ne sarebbe accorto.
    Ora lo sketch dichiara `versione()`, e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
2026-09-09 Il protocollo si vede dal vetro, e il passo 1 lo controlla
    Il controllo del passo 1 era `Ponte().disponibile`, e con il firmware di prima
    risponde True: chiama `distanza`, che quel firmware ha. Chi lo seguiva alla
    lettera saltava il caricamento e finiva dritto nel disallineamento dei bit -
    proprio il caso che il numero di protocollo serve a evitare. Ora il passo chiede
    tutte e due le cose, e va bene solo se dice `True` e `2`.
    Lo stato tecnico riporta protocollo e moduli visti. Non e' un dettaglio da
    sviluppatore: quella pagina si apre DAL VETRO tenendo premuto l'angolo, senza
    tastiera, ed e' l'unico modo di sapere con le mani sui cavetti se il dispositivo
    vede quello che si e' appena colleg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
2026-09-09 Il firmware compila, e adesso compila anche senza la board
    Verificato: lo sketch a un anello solo compila pulito. Era l'unico punto
    rimasto in sospeso, con la board staccata.
    Per farlo si e' installato il core arduino:zephyr sul PC - 1,2 GB una volta
    sola - e la ricetta e' ora nel README del firmware. Serve piu' spesso di
    quanto sembri: la board e' un pezzo solo, si stacca, e un firmware che non
    compila non lo si scopre volentieri con i Modulino gia' in mano.
    E i numeri non tornano con quelli misurati sulla board: 115.864 byte qui contro
    33.000 li', su tetti diversi - 786.432 contro 1.966.080. Non e' un errore di
    misura, sono due catene che partizionano diversamente. Il commento in cima al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
2026-09-09 Perche' il firmware si carica solo a mano, scritto una volta per tutte
    Il caricamento chiede la password dell'utente `arduino` e non c'e' modo di
    evitarlo: l'upload passa da `remoteocd`, che apre una connessione SSH verso la
    board e ci esegue OpenOCD, e quel programma accetta SOLO la password - `ssh:
    unable to authenticate, attempted methods [none password]`. Una chiave gia'
    configurata non serve, e `--upload-field password=` vuoto viene rifiutato.
    Provati tutti e tre.
    La guida diceva «puo' chiedere la password», che lasciava sperare in una via
    non interattiva e faceva riprovare. Ora dice perche', e che la compilazione
    invece non chiede niente e si puo' fare prima.
    E il mistero delle due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
2026-09-09 I moduli si cercano solo all'accensione, e l'anello respira aspettando Linux
    Il dispositivo si monta una volta e non si tocca piu': i Modulino sono avvitati
    dentro la scocca. Cercarli anche dopo, per poterli attaccare a caldo, non serve
    a niente e costa carissimo - la ricerca a caldo e' proprio cio' che bloccava il
    microcontrollore. Ora si cerca solo nella finestra d'accensione, otto secondi, e
    dopo non si rientra mai piu' nel driver del sensore.
    L'anello respira dall'istante in cui il microcontrollore e' pronto, che sono
    millisecondi, fino al primo comando da Linux, che arriva dopo una cinquantina di
    secondi. In mezzo c'era il buio: un dispositivo appena acceso che non fa niente
    sembra rot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
2026-09-09 Il bus si sblocca da solo, e il dispositivo dice cosa c'e' attaccato
    Il sintomo che non tornava era l'anello che non pulsava PIU' NEMMENO LUI. Il
    respiro parte dopo aver interrogato l'anello: se non parte mai, a bloccarsi e' la
    primissima transazione I2C. Non era il driver del sensore, era il BUS.
    L'I2C ha un modo di rompersi che nessun timeout risolve: un dispositivo resettato
    a meta' di un byte resta convinto di star trasmettendo e tiene SDA a zero. Da li'
    non passa piu' niente, verso nessuno. Ricaricare il firmware non bastava - resetta
    il microcontrollore, non il modulo che tiene giu' la linea - e serviva togliere
    corrente a tutto. Ora `i2c_recover_bus()` di Zephyr fa la manovra previst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
2026-09-09 Un mirino, per mettere la camera nel punto giusto
    Dallo schermo del dispositivo non si vede cosa inquadra la camera, e la messa a
    fuoco e' fissa: si aggiusta spostando la camera, e senza vedere il risultato si
    procede a tentoni. `scripts/mirino.py` trasmette il video dalla board al PC.
    Non mostra il fotogramma e basta: mostra le tre cose che decidono se l'etichetta
    verra' letta.
    Il RIQUADRO del 58% centrale, disegnato dove sta davvero: fuori di li'
    l'obiettivo da 130 gradi distorce, e quello che ci finisce non viene mai letto.
    Con le due mezzerie, per centrare l'etichetta senza righello.
    La NITIDEZZA dal vivo, ed e' calcolata DENTRO il ritaglio, non sull'immagine
    intera: e' la stessa vari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
2026-09-09 Il blocco era un puntatore nullo, non il driver del sensore
    Per tre giri di banco la causa e' stata cercata nel posto sbagliato. Il driver
    del VL53L4CD ritenta i trasferimenti I2C falliti con un `do {...} while (status)`
    senza uscita, ed era il sospettato ovvio. Ma riscrivere il sensore da capo e
    aggiungere il recupero del bus non ha cambiato NIENTE, e quello avrebbe dovuto
    far sospettare la diagnosi molto prima.
    Il guasto stava in Arduino_Modulino, ed e' dimostrabile leggendo il binario.
    `ModulinoClass` non ha costruttore: il suo unico campo, il puntatore al bus, lo
    scrive solo `ModulinoClass::begin()`. L'oggetto globale finisce in .bss, che
    l'avvio azzera. Questo sketch non ha MAI chiamat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
2026-09-09 Il respiro torna continuo, il sensore vede a dieci centimetri, e il mirino legge
    ── LA PULSAZIONE ────────────────────────────────────────────────────────────
    Era "digitale" per un motivo esatto: il registro di luminosita' del modulo e' a
    CINQUE bit, e fra il minimo e il massimo di un'attesa discreta - 3 e 26 su cento
    - restano NOVE GRADINI in tutto. A venti aggiornamenti al secondo si vedevano uno
    per uno.
    Ora si modula il COLORE, che e' a otto bit per canale: 256 passi invece di nove,
    ambra scalata in proporzione sui tre canali, quindi la tinta non cambia. E un
    fond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
2026-09-09 La schermata torna all'invito, e l'audio non si tronca piu'
    ── IL RIPRODUTTORE CHE RESTAVA LI' ──────────────────────────────────────────
    Finito il racconto si restava sulla schermata del racconto per SEMPRE, con il
    riproduttore in vista e tutti i pulsanti inerti, finche' qualcuno non toglieva la
    bottiglia: `DURATE_S[CONCLUSO]` era `None`. A tavola quella schermata non dice
    niente e non fa niente - e' il dispositivo che sembra piantato.
    Ora CONCLUSO dura quattro secondi - il tempo che l'ultima frase si posi, perche'
    sparire nell'istante in cui la voce tace e' brusco - e poi si torna all'invito.
    E qui n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
2026-09-09 L'OCR non era scarso: gli si dava il testo storto
    Le etichette non venivano riconosciute anche a luce e nitidezza ottime, e la
    domanda era se cambiare strumento. La risposta e' no, ed e' venuta da una
    misura su tre scatti veri invece che da un'ipotesi.
    Guardando lo scatto si vede subito: la bottiglia e' cilindrica, appoggiata, e la
    camera la guarda dal basso e di sbieco. Su «NERO D'AVOLA / SICILIA», scritto
    lungo l'asse, il testo arriva nel fotogramma RUOTATO DI NOVANTA GRADI.
    E il classificatore di orientamento era spento, con questa motivazione scritta
    nel codice: «serve quando il testo puo' essere capovolto. Qui non puo': la
    bottiglia sta in piedi sul supporto». Vera l'osservazione,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
2026-09-09 Il cambio lingua taglia, non accoda
    Toccare una bandierina mentre parla l'altra vuol dire aver cambiato idea:
    sentirsi finire la frase di prima, e solo dopo quella chiesta, fa sembrare il
    tocco perso. Ora si taglia cio' che non e' ancora uscito e si riparte subito.
    E' la seconda volta che si sceglie di interrompere, e la prima era andata male -
    gli annunci si tagliavano a vicenda e non si sentiva NIENTE, come un guasto
    dell'amplificatore. Ma la causa non era l'interruzione: era che il flusso audio
    si apriva e chiudeva a ogni frase, e il DSP di questa board impiega due secondi
    ad avviarsi, dentro i quali una frase da un secondo spariva del tutto. Da quando
    il flusso resta aperto quel costo n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
2026-09-09 La camera si raddrizza, la posa si allunga, e chi non e' riconosciuto si segnala
    ── LA ROTAZIONE ─────────────────────────────────────────────────────────────
    La camera e' montata ruotata di 90 gradi, ed e' la sua posizione GIUSTA: una
    bottiglia e' alta e stretta, e un sensore 16:9 girato di lato la inquadra per il
    lungo. Ma il fotogramma che ne esce ha il testo dell'etichetta coricato, e un
    riconoscitore di testo lavora su righe orizzontali.
    Ora si raddrizza prima di guardarlo, e prima di ritagliarlo - il ritaglio e'
    centrato, e su un'immagine coricata terrebbe la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
2026-09-09 Una finestra sui registri del sensore, per smettere di ipotizzare
    Il sensore si avvia (`stato_tof` = 0, entrambi i moduli visti sul bus) e legge
    `0 mm` fisso: dodici letture identiche, e muovendo una mano sopra non cambia
    niente. Zero esatto e senza rumore non e' una misura, e `distanza()` dice quanti
    millimetri ma non dice PERCHE' quando il numero e' assurdo.
    `registro_tof(n)` apre il sensore e mostra cosa risponde davvero: misura pronta,
    stato della misura, SPAD attivi, distanza, e i due registri dell'interrupt.
    `scripts/bus.py --sensore` li scorre mentre si muove una mano davanti. Serviva
    questo, non un'altra ipotesi: la prossima mossa dipende da quale dei numeri e'
    sbagliato, e sono sei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
2026-09-09 Il sensore misura, e i numeri sporchi erano due lettori sullo stesso bus
    L'ordine dell'interrupt era la correzione giusta: azzerarlo PRIMA di leggere il
    risultato, non dopo. Il sensore ora misura davvero - 33, 39, 46, 53, 70, 91, 110,
    136, 155, 192, 203 mm mentre una mano si muove sopra.
    Restavano numeri sporchi a intermittenza, e la causa si legge nei dati: 2313
    e' 0x0909, il byte di stato ripetuto; 4354 e' 0x1102, un byte del registro
    della polarita' seguito da un altro. Non erano misure sbagliate, erano
    risposte di una transazione arrivate a chi ne aveva chiesta un'altra.
    I gestori registrati con `Bridge.provide()` NON girano nel loop: la libreria
    crea un thread suo, chiamato "bridge".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
2026-09-09 Zero non e' una distanza: e' il modo in cui il sensore dice «non c'e' niente»
    I numeri sono puliti - il mutex sul bus ha risolto - e il difetto si legge
    direttamente nei dati raccolti al banco, con la mano che entra ed esce dal cono:
    niente davanti distanza 0 SPAD 52368, sempre lo stesso
    mano davanti 25..176 mm SPAD 392..51528, variabili
    Lo stato resta 9 - «misura buona» - in tutti e due i casi, e gli SPAD non sono
    mai zero: nessuno dei due controlli che c'erano se ne accorgeva. E fisicamente
    uno zero non puo' essere vero: il VL53L4CD non misura sotto il centimetro, e un
    oggetto appoggiato sulla finestrella darebbe qualche millimetro e uno stato di
    errore, non z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
2026-09-09 Un'etichetta senza produttore non è di nessun produttore
    Su una bottiglia c'è scritto «Primitivo di Manduria» e basta. Quel vino lo
    fanno centinaia di aziende: dire che è del viticoltore A invece che del B non
    è un'approssimazione, è un'invenzione detta ad alta voce a un tavolo.
    Il riconoscitore lo faceva. Su 1200 etichette costruite dalle tipologie del
    database — lunghe abbastanza da non essere protette dal tetto sulle parole —
    ne attribuiva 21 a una cantina, e una la dichiarava CERTA: «Brunello di
    Montalcino» dato all'azienda «Vigna Italia» con 100, perché la parola «vigna»
    dell'etichetta, che è del disciplinare, le faceva da firma.
    La causa: la conferma del produttore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
2026-09-09 La barra tornava indietro, e non si poteva chiudere senza togliere la bottiglia
    Due modifiche, e cinque difetti trovati per strada.
    ## La barra
    Il client mostrava `posizione / durata`, dove `durata` è *quanto è già stato
    sintetizzato*. Ma la sintesi corre al doppio del tempo reale, quindi per tutta
    la prima metà del racconto quel denominatore cresceva quasi al doppio della
    velocità del numeratore: dentro una frase la barra saliva, all'arrivo della
    frase dopo precipitava.
    Misurato su un racconto ricomposto da frasi con audio vero, otto frasi per
    16,8 secondi: sette arretramenti, il peggiore di 43,9 punti. E a due secondi
    dall'inizio segnava già il 56 %, perché con una sola frase sin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
2026-09-14 Il riconoscitore reggeva solo un database che conoscesse per intero
    L'indice di ricerca vive nel database, e il database si rigenera; il codice si
    aggiorna col firmware. I due cicli di vita non coincidono.
    Fondendo l'archivio dei vini italiani con quello del dispositivo, l'indice
    ricostruito conteneva due ambiti nuovi — le tipologie del registro UE e i
    prodotti da scaffale con il loro codice a barre — che nessuna parte di questo
    codice sa comporre in fatti. Provato sul database vero:
    tipologia_ue -> KeyError: 'tipologia_ue'
    gdo -> KeyError: 'gdo'
    E non è un'eccezione qualsiasi: `_componi` gira nel thread di lavoro, quindi
    diventa una schermata di guasto davanti all'o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
2026-09-14 Il disciplinare parla italiano, e il dispositivo racconta in due lingue
    Il registro UE porta le tre descrizioni ufficiali di ogni tipologia — colore,
    odore, sapore. Sono la cosa piu' preziosa dell'archivio proprio perche' non le
    abbiamo scritte noi. Sono 6.363, e sono tutte e sole in italiano: in inglese
    quella parte del racconto non c'era.
    A mano non si traducono: 3.124 valori distinti. Ma i valori distinti non sono
    materiale distinto. Spezzandoli sui separatori restano 15.144 frammenti di
    2.405 forme, e quelle forme sono la stessa manciata di parole ricombinata —
    «giallo paglierino», «giallo paglierino piu' o meno intenso», «giallo
    paglierino con riflessi verdognoli», «dal gial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
2026-09-14 Due registri senza una chiave in comune, e un PDF che ha perso le righe
    Il registro UE porta le tre descrizioni ufficiali di ogni tipologia - colore,
    odore, sapore - scritte dal consorzio. Sul dispositivo non arrivavano affatto:
    il riconoscitore non leggeva nemmeno quella tabella.
    Farcele arrivare e' lo stesso problema del produttore, in un'altra forma. Le
    tipologie vengono da figshare, le citazioni dal documento unico eAmbrosia, e le
    due fonti non hanno una chiave in comune. Accostarle per somiglianza del nome
    sembra ovvio e sbaglia nel modo peggiore: «Trentino Manzoni Bianco» si prende
    la descrizione di «Trentino Bianco» con punteggio pieno, perche' le parole ci
    sono tutte. Misurato: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
2026-09-14 Il nome identico non e' una somiglianza: e' la risposta
    Fra le descrizioni rimaste in ballo per «Amelia Bianco» c'era una riga che si
    chiamava «Amelia Bianco». Il riconoscitore non la vedeva: restringeva per
    vitigno e qualificatori, non trovava un accordo, e taceva - avendo sotto gli
    occhi la risposta scritta in chiaro.
    Il nome identico vale piu' di ogni restrizione, ma solo se e' un nome
    affidabile. Uno ricostruito dalla denominazione o numerato coincide per
    costruzione: «Amelia Bianco» e «Amelia Bianco (2)» si somigliano perche' nessuno
    dei due dice niente, non perche' siano lo stesso vino.
    tipologie che ricevono le citazioni 2.280 -> 2.308 / 4.301 53,7%
    attribuite a un v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
2026-09-15 Le uve appassite fanno un altro vino, non lo stesso vino piu' dolce
    «Cinque Terre Costa de Campu Riserva» e' un bianco secco. Si prendeva la
    descrizione dello «Sciacchetra' Riserva», che e' un passito: stessa
    denominazione, stesso colore, e nel nome nessuna parola che facesse da freno
    finche' «sciacchetra» non e' stata messa in un elenco. I nomi di menzione
    valgono quanto gli aggettivi - e' il vino a essere diverso, non il modo di
    chiamarlo.
    Ora passito, liquoroso, stramature, vendemmia tardiva, Sciacchetra', Recioto,
    Amarone, Vin Santo, Sforzato e Occhio di Pernice escludono in partenza, non
    rimandano in fondo alla cascata.
    tipologie che ricevono le citazioni 2.308 -> 2.223 /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
2026-09-15 Le parole del consorzio non si sentivano: il racconto era gia' scritto
    Le citazioni del disciplinare arrivavano ai Fatti ma non a un tavolo. Il
    narratore preferisce un testo gia' in archivio a qualunque altra cosa, e i
    9.660 racconti da template erano stati scritti prima che le citazioni
    esistessero: il 100% delle tipologie che ne avevano una aveva anche un racconto
    che la scavalcava. Proprio il caso della bottiglia senza produttore - quello per
    cui e' nata la regola del produttore - era quello che non le usava.
    Ora entrano nel corpo del racconto, e prima dei tratti generici. L'ordine non e'
    estetico: «rosso rubino intenso con lievi sfumature violacee» e' la descrizione
    sensoriale vera di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
2026-09-15 Ogni token del prompt e' sessanta millisecondi di silenzio
    Misurato sul tokenizzatore di Qwen e sulla board: il blocco dei fatti costa 230
    token, il prefill va a 16,25 token al secondo, e i fatti NON si possono mettere
    in cache perche' cambiano a ogni bottiglia. Sono quattordici secondi prima che
    il modello scriva la prima lettera - e quattordici secondi davanti a un ospite
    non sono un'attesa, sono un guasto.
    `blocco_compatto` porta gli stessi fatti in 115 token, sette secondi. Non e' il
    blocco esteso abbreviato: e' lo stesso contenuto senza le etichette, che a un
    modello addestrato su questa forma non servono. Il blocco esteso resta per il
    modello generico, che le etichette le legge davver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
2026-09-16 Cio' che la verifica non vede diventa un'abitudine del modello
    Quaranta testi del modello addestrato, riletti da quattro angolazioni e poi
    verificati con codice sul corpus del maestro. Passavano tutti la verifica del
    dispositivo, e portavano quattro classi di invenzione:
    «Il disciplinare lo vuole rosso» senza nessuna citazione nei fatti
    «tredici gradi e mezzo» di un vino da 12,5%
    «da servire a diciassette gradi» con i fatti che dicono 16-18
    «ideale su crostacei» con crostacei da nessuna parte
    «un grande vitigno siciliano» con l'origine da nessuna parte
    La prima e' la peggiore: attribuisce a un ente pubblico parole che non ha
    sc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
2026-09-17 Un ingresso che non contiene cio' che il testo dice insegna a inventare
    `blocco_compatto` tagliava la nota sul vitigno (40 token) e accorciava vitigni,
    abbinamenti e note sensoriali a tre o quattro voci. Sembrava gratis: il
    racconto la nota la dice comunque, dal template.
    Non era gratis. Il corpus d'addestramento e' scritto da un modello che il
    blocco ESTESO lo vede tutto, e misurando: 491 esempi su 550 (l'89%) usavano
    parole della nota che l'ingresso non portava, e 162 su 650 (il 25%) nominavano
    un vitigno o un abbinamento che i tetti avevano tolto. Per nove esempi su
    dieci lo studente veniva addestrato a dire cose che il suo ingresso non
    contiene, e l'unico modo di produrle e' inventarle: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
2026-09-17 Un interruttore per le descrizioni generate, in fondo a un gesto di tre secondi
    Il modello girava tre volte su seicento. Non per un difetto: la cascata di
    `racconta` e' ordinata per quanto si sa della bottiglia, e un testo gia'
    scritto o un template vero per costruzione arrivano sempre prima. Chi usa il
    dispositivo non lo vede mai lavorare.
    Ora c'e' un interruttore. Acceso, il modello va per PRIMO e scrive il racconto
    per questa bottiglia; spento, si legge il testo gia' pronto. Predefinito:
    spento - un dispositivo appena acceso deve rispondere subito.
    Non e' una scorciatoia sulla verita'. Quello che il modello scrive passa dalla
    stessa verifica di sempre, e se inventa due volte di fila si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
2026-09-17 Un controllo che grida sempre non e' severo: e' spento
    Passando i 9.660 racconti gia' scritti dalla verifica del dispositivo ne
    bocciava 3.401. Nessuno dei tre difetti stava nei testi.
    Il primo: i fatti si componevano SEMPRE in italiano, e un racconto inglese
    veniva confrontato con parole italiane. «Tuscany» non sta in un blocco che dice
    «Toscana», e nemmeno «Italy», «Piedmont», «Bordeaux», «Mediterranean». Da solo
    spiegava quasi tutte le bocciature. Ora `verifica` prende la lingua, e con lei
    prende anche le schede, le note sensoriali e gli abbinamenti in quella lingua.
    Il secondo: il controllo del colore gridava al rosso su un vino bianco quando
    la parola incriminata stava DEN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
2026-09-17 Un modello affinato su una forma e interrogato con un'altra non l'hai affinato
    Sulla board il percorso generato girava, ma male: 63,8 secondi invece dei 27
    misurati al banco, e la prosa tornata sgrammaticata - «Il Abruzzo Spumante
    Bianco Charmat e' un solo vitigno». Il dispositivo mandava allo studente il
    prompt del MAESTRO: 458 parole di istruzioni piu' il blocco esteso, cioe' la
    forma su cui lo studente non e' mai stato addestrato.
    Lo studente vuole quello che ha visto in addestramento: una riga di istruzione
    e i fatti compatti, nel formato di chat di Qwen. Mille caratteri in meno, e le
    regole non gli servono perche' le ha imparate.
    con il prompt sbagliato 63,8 s prosa sgrammatic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
2026-09-17 Una frase detta non si riprende: si verifica prima di dirla
    Con le descrizioni generate accese, sulla board passano dodici secondi di
    prefill prima che esca la prima lettera - e sono dodici secondi di silenzio
    davanti a un ospite che ha appena appoggiato una bottiglia.
    `racconta_a_frasi` da' le frasi una per volta, appena sono pronte. La prima e'
    l'APERTURA, che e' un template: nasce dai fatti, e' pronta in millisecondi e
    dice gia' qualcosa di vero - che bottiglia si ha davanti e quanto se ne e'
    sicuri. Mentre la voce la pronuncia, il modello lavora.
    L'apertura e' anche l'unica frase che il modello non scrive mai, perche'
    dipende dalla CERTEZZA e quella si conosce solo al momento. Dirla no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
2026-09-17 Chiedere di scegliere fra tre bottiglie che l'etichetta non distingue
    Sull'etichetta c'e' scritto «Cerasuolo d'Abruzzo» e basta. Il dispositivo
    mostrava tre candidati - Filari, Lepore, Valori - e chiedeva all'ospite di
    scegliere.
    Quella domanda non ha risposta. La bottiglia non dice di chi e', e nessuno al
    tavolo lo sa meglio di lei: chiedere sposta su un ospite una scelta che il
    riconoscitore ha appena dichiarato impossibile un secondo prima, quando la
    regola del produttore l'ha fatto scendere al vino generico. E qualunque cosa
    l'ospite tocchi, il dispositivo dira' un nome di cantina che non ha letto.
    Un candidato aggiunge qualcosa solo se porta a un vino DIVERSO. Il criterio e'
    la cate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
2026-09-17 Un candidato che nomina una cantina che non abbiamo letto e' una tentazione
    Il primo criterio - la catena di ripiego - non bastava, e il caso che l'ha
    mostrato e' istruttivo: «Origine Cerasuolo d'Abruzzo» di Passione Natura in
    archivio sta sotto Montepulciano d'Abruzzo, non sotto Cerasuolo. La sua catena
    non passa da dove siamo, quindi passava il filtro - ma a un tavolo quella riga
    si legge come lo stesso vino con una cantina appiccicata.
    Il criterio che morde e' piu' semplice: se non stiamo nominando un produttore,
    un candidato che ne nomina uno non e' un'alternativa. Qualunque riga l'ospite
    tocchi, il dispositivo stamperebbe il nome di un'azienda che non ha letto,
    cioe' proprio cio' che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
2026-09-17 Le scuse sulla nitidezza raccontano la nostra fatica, non il vino
    «L'etichetta non e' nitida», «Non riesco a leggere l'etichetta con certezza,
    ma...», «Del produttore non sono sicuro, ma il vitigno si'». Sei aperture su
    otto cominciavano scusandosi di come era andata la lettura - che e' un
    problema nostro, e a un tavolo non interessa a nessuno.
    prima L'etichetta non è nitida. Potrebbe essere un Cerasuolo d'Abruzzo.
    ora Questo è un Cerasuolo d'Abruzzo.
    Si puo' dire cosi' perche' e' vero: da quando un produttore che non si e'
    letto non si nomina piu' - nemmeno fra i candidati - cio' che resta da dire e'
    il vino, e quello lo si dice bene. L'esitazione difendeva da un'afferma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
2026-09-17 Un verso sbagliato non degrada la lettura dell'etichetta: la annulla
    Il dispositivo «non riconosceva le bottiglie» nella scocca stampata. Non era
    l'illuminazione, ne' la messa a fuoco, ne' il riconoscitore: era `rotazione =
    90`, rimasta dal banco, dove la camera stava girata di lato. Nella scocca
    guarda la bottiglia di fianco e il testo nel fotogramma nativo e' gia'
    orizzontale; raddrizzarlo lo corica.
    Misurato sulla stessa bottiglia e sullo stesso fotogramma, dando all'OCR i
    quattro versi:
    0° ULISS · CERASUOLO · D'ABRUZZO riconosciuto, sicurezza 87
    90° D'ABRUZZC niente
    180° 3IMER · DRZZZO · CEAVOLO niente
    270° 3引8到3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
2026-09-17 La camera vede la bottiglia meglio di quanto il sensore la misuri
    Il sensore di distanza e' l'attrezzo sbagliato per dire se c'e' una bottiglia:
    il suo fondo e' quasi speculare, e appena non e' centrata il lobo riflesso esce
    dal cono di ricezione e la misura salta. Il modulo lo dichiarava gia', e ci
    aveva costruito sopra un'isteresi asimmetrica per conviverci.
    La camera invece la bottiglia la vede, e la vede grande: a dieci centimetri
    dalla lente occupa la fascia centrale del fotogramma da un bordo all'altro.
    Questo commit mette il pezzo che serve a guardarla; il ciclo che lo usera' e'
    nel prossimo.
    Non si riconosce «una bottiglia»: si riconosce che al posto della stanza c'e'
    qualcosa d'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
2026-09-17 Il sensore di distanza non decide piu' quando c'e' una bottiglia
    Adesso lo decide la camera. Il ciclo di sorveglianza non legge piu' il ToF:
    guarda il piatto due volte al secondo, e due sbirciate d'accordo fanno partire
    la scansione. Il battito resta a 0,15 s perche' deve far scadere i timer, ma
    guardare otto volte al secondo non serve a nessuno.
    Il `Presenza` del ponte se ne va: non lo guidava piu' nessuno, e due classi di
    presenza di cui una morta sono peggio di una sola. `distanza_mm` resta, la usa
    `scripts/bus.py` per chi ha i cavetti in mano, e il Modulino resta in catena -
    `disponibile` continua a interrogarlo, non perche' serva il numero ma perche'
    e' il metodo piu' innocuo che lo sk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
2026-09-17 La posa era fissa alla stanza in cui l'avevamo misurata
    Il dispositivo, acceso la sera con la luce della stanza spenta, non leggeva
    piu' niente. Non era l'OCR, non era il verso del fotogramma, non era la messa a
    fuoco: era il tempo di posa, 900, scelto in una stanza in penombra ma pur
    sempre illuminata. Misurato nella scocca, anello bianco, luce di sala SPENTA -
    cioe' la condizione normale di un ristorante a cena:
    900 luce 47 niente
    1500 luce 62 niente
    2200 luce 76 ULIEET · TEITLITHE
    3000 luce 88 ULIGSA · TENUTH · CERASUOLO · D'ABRUZZO
    4000 luce 99 ULISSE · TENLITA · CERASUOLO · D'ABRUZZO
    A 900 non si legge NIENTE. A 3000 compare la denominaz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
2026-09-17 Contare i fotogrammi non bastava: la posa va guardata arrivare
    Il commit prima buttava tre fotogrammi dopo ogni ritocco, perche' tre e' il
    ritardo misurato con cui il driver applica la posa nuova. Sul banco andava. Nel
    servizio no, e la differenza e' che li' lo stream sta fermo fra una sbirciata e
    l'altra: il fotogramma dopo i tre scarti tornava ancora con la posa vecchia.
    Allora la ricerca rimisurava lo stesso numero, correggeva una seconda volta
    nello stesso verso e finiva contro il tetto. Qualunque fosse la luce. E
    sembrava perfino funzionare, perche' al buio il tetto e' la risposta giusta:
    posa 900 -> 4000 (luce 47) 44, 47, 47 - tre misure, una sola vera
    Aspettare che la luce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
2026-09-17 I tempi scritti in giro erano quelli di prima della posa cercata
    Tre punti dicevano «circa 1,7 secondi» per la raffica, e «~3,8 s» per lo
    scatto piu' l'OCR. Erano misure vere, prese in una stanza illuminata e con la
    posa fissa a 900. Con la posa che si cerca, e al buio, sono altre.
    Misurato nel servizio, al buio, bottiglia posata:
    scatto con la posa gia' giusta 2,0 s
    scatto con la luce cambiata 4 - 8,5 s
    OCR 6,8 - 7,7 s
    Il numero che peggiora e' l'OCR, e peggiora per una ragione: la posa piu'
    lunga schiarisce anche cio' che sta dietro la bottiglia, e il rilevatore trova
    piu' regioni di testo da passare al modello. In una s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
2026-09-18 Guardare cosa vede, e ricordare cosa ha fatto
    Due cose che mancavano per capire i guasti da lontano, e che hanno la stessa
    radice: quando qualcosa non funziona in sala, non c'e' modo di sapere perche'.
    IL MIRINO, SUL VETRO. C'era gia', come `scripts/mirino.py`, e chiedeva tre
    cose che in sala non ci sono: fermare il servizio, un PC sulla stessa rete e
    un browser. Ora si accende dal pannello delle impostazioni - lo stesso da cui
    si accendono le descrizioni generate - e si vede sullo schermo del
    dispositivo. La logica e' la stessa, spostata in `amelie.mirino`: una copia
    sola, perche' due copie divergono e quella che diverge e' sempre quella che
    sta sul dispositivo in sala.
    Accendendolo il di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
2026-09-18 Quaranta righe non sono un'etichetta girata male: sono una parete
    Il mirino, appena acceso, ha mostrato la prima cosa che doveva mostrare, e non
    era sul mirino. Con la bottiglia tolta e un calendario dietro al piatto, l'OCR
    trova trentotto righe di numeri e ci mette 39 SECONDI, perche' ogni regione
    trovata passa poi dal modello che la riconosce.
    Due conseguenze, tutte e due gia' successe nel giornale del dispositivo.
    Il ripiego che gira il fotogramma partiva. Le righe c'erano - quindi non era il
    caso «vuoto» - ma erano tutte cifre, e le cifre non contano come parole utili:
    raccolto povero, si prova un altro verso. Tre volte 39 secondi, per niente,
    perche' qualunque verso quella parete re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
2026-09-18 La camera torna di lato, dov'era il suo posto
    Una bottiglia e' alta e stretta, e un sensore 16:9 girato di fianco la inquadra
    per il lungo. Il montaggio nella scocca l'aveva rimessa dritta, e si vedeva: la
    denominazione cadeva sotto il bordo del ritaglio e il dispositivo raccontava il
    vino sbagliato - un Primitivo di Manduria per un Nero d'Avola, con il
    fotogramma nel giornale a mostrare «NERO D'AVOLA» tagliato via.
    I conti, con una bottiglia da 76 mm di diametro:
    largo alto tolleranza laterale
    camera dritta 200 mm 112 mm +-60 mm
    camera di lato 112 mm 200 mm +-18 mm
    Un'etichetta da vino e' alta un centinaio di millimetri piu' il collarino: 1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
2026-09-18 Se la bottiglia dice di che colore e', non si discute
    Due difetti trovati sul dispositivo con uno spumante rosa in mano, e sono lo
    stesso difetto visto da due lati: il colore scritto sull'etichetta non entrava
    in nessuna decisione.
    IL PRIMO. Su «Leggiadro · Brut Rose · METODO CLASSICO» il riconoscitore metteva
    primo «Asti Metodo Classico» all'86 % - che e' BIANCO, di Moscato, dolce - e la
    voce raccontava il Moscato d'Asti a chi aveva in mano un metodo classico
    rosato. I tre candidati offerti accanto erano gia' tutti Metodo Classico Rose':
    la risposta giusta era in lista, solo non per prima.
    Quando la bottiglia dichiara il proprio colore, quella parola non e' un indizio
    da pesare insi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
2026-09-18 Uno spumante non si serve alla temperatura della sua uva
    Il dispositivo ha consigliato di servire un Trentodoc rosato a QUINDICI-
    DICIASSETTE GRADI. Non l'ha inventato il modello: era scritto nei fatti che gli
    abbiamo dato, e il modello ha fatto il suo mestiere ripetendolo.
    Le schede in `data/vitigni.json` danno la temperatura del vino FERMO di
    quell'uva - 15-17 per il Pinot Nero, giusta per un Pinot Nero - e uno spumante
    di Pinot Nero se la portava dietro. Non e' un caso isolato: in archivio 819
    tipologie su 4.300 sono spumanti o frizzanti, piu' 212 fra passiti e liquorosi.
    Adesso la decide la CATEGORIA tutte le volte che il vino non e' fermo, e la
    categoria viene dal registro UE, che e'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
2026-09-18 Non si nomina cio' che non si e' letto
    E' la regola piu' importante del riconoscimento, e fino a qui non c'era. C'era
    per il PRODUTTORE - «se sull'etichetta c'e' scritto Primitivo di Manduria e
    basta, il dispositivo non puo' dire di chi e'» - ma non per tutto il resto.
    «Trento Rosato/Rose» somiglia moltissimo a «Brut Rose Metodo Classico»: due
    parole su tre in comune. Ma «Trento» sulla bottiglia non c'era, e Trento e' un
    posto. Dirlo vuol dire attribuire al vino un'origine che nessuno ha dichiarato,
    e farlo con la voce di chi sa.
    MISURATO, perche' la scelta della soglia non si fa a occhio. Su 139 etichette
    vere con la scheda nota, piu' 9 bottiglie fuori archivio:
    riconosciment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
2026-09-18 Il colore dichiarato si perdeva per strada
    Il vincolo del colore si applicava scegliendo fra i candidati, e li' finiva. Ma
    la cascata continua dopo: il produttore non letto fa scendere alla tipologia,
    la regola sul nome fa scendere ancora, e uno di quei gradini puo' essere di un
    altro colore.
    Visto sul dispositivo, etichetta vera: `TARVESIUM · PROSECCO ROSE · DOC ·
    MILLESIMATO2024 · EXTRA DRY`. Si scendeva a «Prosecco-Wine», che in archivio e'
    BIANCO, e la parola ROSE stampata sulla bottiglia era finita per strada.
    Ora, se alla fine di tutto il colore contraddice ancora, si cerca il fratello:
    fra le tipologie della STESSA denominazione si prende quella del colore giusto,
    se il suo no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
2026-09-18 All'accensione si guarda sempre, qualunque cosa dica il file
    Il dispositivo aveva salvato LA BOTTIGLIA come sfondo del piatto vuoto. Da
    quel momento il piatto gli sembrava vuoto con la bottiglia sopra: nessuna
    scansione partiva, e la via di scampo che c'era - tre letture a vuoto e lo
    sfondo si rimpara - sta in fondo alla scansione, quindi non partiva nemmeno
    quella. Cieco fino a che qualcuno non toglieva la bottiglia.
    Lo sfondo ricordato dice com'era il piatto l'ultima volta che il dispositivo ha
    CREDUTO fosse vuoto, e quella convinzione puo' essere sbagliata: basta che la
    bottiglia arrivi mentre lo sta imparando. Il file quindi si carica ancora - da'
    al rivelatore un punto di partenza per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
2026-09-18 Il riquadro che va all'OCR segue la bottiglia
    Un riquadro fisso non puo' andare bene per due bottiglie diverse: una renana
    alta e stretta e una borgognona larga non occupano la stessa parte del
    fotogramma, e un rettangolo buono per l'una o taglia l'altra o le lascia dentro
    mezza stanza - e la stanza il rilevatore la legge come testo.
    La sagoma viene da dove c'era gia': lo sfondo che il rivelatore di presenza
    impara guardando il piatto vuoto. I pixel cambiati SONO la bottiglia, perche' e'
    l'unica cosa che e' arrivata. Costa un millesimo di secondo su un'immagine che
    si calcola comunque.
    Tre cose misurate scrivendolo, e tutte e tre erano invisibili dal ragionamento.
    LE RIGHE NON SI MISURANO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
2026-09-18 Uscire dal mirino e' come accendersi: non si sa cosa c'e' davanti
    Spegnendo il mirino il dispositivo ricaricava lo sfondo ricordato e si
    convinceva che il piatto fosse vuoto. Con la bottiglia sopra. Ed e' il caso
    NORMALE, non un caso limite: chi tara l'inquadratura la bottiglia ce l'ha
    davanti per definizione - e' quello che sta inquadrando.
    Lo sfondo ricaricato dice com'era il piatto quando il dispositivo credeva fosse
    vuoto, che e' una convinzione vecchia di prima del mirino. Nel frattempo la
    camera stava facendo altro e il mondo davanti puo' essere cambiato: e' la
    stessa situazione dell'accensione, e si chiude allo stesso modo - si guarda.
    Ed e' anche quello che vuole chi ha appena spos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
2026-09-18 Una carta dei vini al posto dell'archivio
    Un CSV con due colonne - titolo e descrizione - dove ogni riga e' una
    denominazione e il suo racconto gia' scritto, da leggere com'e'. Niente
    cascata, niente composizione dai dati, niente modello: si riconosce il titolo e
    si legge la descrizione.
    Serve a vedere, su bottiglie vere, che effetto fa un testo scritto da una
    persona al posto di uno composto dai dati. Cinquecento voci, ottantasette
    parole l'una: sono gia' della lunghezza giusta per essere dette a voce.
    Quello che NON cambia e' la regola, e qui e' PIU' severa. Nell'archivio il veto
    riguarda le parole che IDENTIFICANO un vino; qui anche quelle che lo
    distinguono, perche' una carta ha «Cham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
2026-09-18 Tre modi di raccontare, e si sceglie dal vetro
    Era un interruttore a due posizioni - descrizioni generate si' o no - e i modi
    sono diventati tre. La differenza fra loro non e' di stile: e' DA DOVE VIENE
    quello che il dispositivo dice.
    archivio i dati del registro UE, composti in testo. Istantaneo.
    generativa gli stessi dati, ma il testo lo scrive il modello per QUELLA
    bottiglia. Costa decine di secondi.
    carta un file scritto a mano. Solo i vini che contiene, e per quelli
    parla chi le ha scritte.
    Un modo che il dispositivo non puo' servire NON SI MOSTRA: senza modello
    caricato sparisce la generativa, senza carta sparisce la carta. E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
2026-09-18 Cio' che la carta da' per scontato non si deve leggere
    Sul dispositivo, etichetta vera: l'OCR ha letto «Brunello» e tre frammenti di
    retroetichetta, e la regola ha scartato «Brunello di Montalcino DOCG» perche'
    «Montalcino» sul vetro non c'era. Corretta secondo la lettera, sbagliata di
    fatto: in carta NON ESISTE UN ALTRO BRUNELLO. Ogni voce che contiene quella
    parola contiene anche «Montalcino», e dirlo non aggiunge nessun rischio.
    Si e' vista perche' il giornale annota i titoli scartati, e li' dentro c'era
    proprio quello giusto, al 59 %.
    Quindi: una parola si puo' dire senza averla letta quando compare in TUTTE le
    voci che contengono quelle lette. Non e' un'eccezione scritta a man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
2026-09-18 Un archivio che non si rilegge trecento volte per una ricerca
    Cercare tre parole in archivio costava 396 ms, e ne spendeva 229 in
    interrogazioni SQL: 493 per ricerca, quasi tutte gia' fatte.
    Tre cause, tutte misurate col profilatore sul dispositivo.
    `ricerca` e' una tabella FTS5, e in FTS5 le colonne che non sono testo
    indicizzato sono UNINDEXED davvero: `WHERE ambito = ? AND ambito_id = ?`
    non ha nessun indice da usare e scandisce venticinquemila righe. Sono 45
    ms a chiamata, e la cascata la chiama quattro volte. Ora l'archivio si
    legge una volta e si tiene un dizionario.
    Il colore di un record e la sua tipologia venivano richiesti a ogni
    livello della cascata, per lo stesso record: memo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
2026-09-18 Si cerca il testo sul piccolo e lo si legge sul grande
    L'OCR costava 3960 ms su un ritaglio di bottiglia, e il parametro con
    cui si sarebbe dovuto ridurre non ha mai ridotto niente: da 736 a 160,
    tempi identici al millesimo.
    Il motivo sta nel pacchetto. Con `limit_type="min"` il ridimensionamento
    interviene solo `if min(h, w) < limit_side_len`, cioe' SOLO PER
    INGRANDIRE. Un ritaglio 756x1824 ha il lato corto sopra qualunque
    soglia, e arrivava alla rete intero. Il campo si chiamava `lato_massimo`
    e non era un massimo: era un minimo, e serviva a ingrandire.
    Da qui la forma nuova, in due fasi. Si cerca dove sta il testo su
    un'immagine rimpicciolita da noi, perche' il rilevatore costa in
    propo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
2026-09-18 La camera resta in moto, e lo scatto si prende invece di farlo
    Lo scatto costava settecento millesimi e li spendeva quasi tutti ad
    aspettare, tutti DOPO che la bottiglia era gia' li': 150 ms perche' la
    luce si assestasse, tre fotogrammi buttati per svuotare il buffer USB,
    la ricerca della posa, e i tre della raffica a 90 ms l'uno.
    Ora un guardiano tiene lo stream in moto. Non c'e' niente da svuotare e
    niente da assestare: il fotogramma buono e' quello che sta arrivando
    comunque. La posa si corregge un passo alla volta mentre il flusso
    scorre, invece di fermarsi ad aspettare che arrivi al sensore.
    L'assestamento della bottiglia si guarda invece di aspettarlo. Erano 600
    ms fissi, spesi sempr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
2026-09-18 Il guardiano guarda la luce una volta al secondo, non undici
    Misurare la luce vuol dire raddrizzare, ritagliare e convertire in
    grigio un fotogramma da due megapixel: quindici millesimi, e il
    guardiano lo faceva a ogni fotogramma. La luce di una sala non cambia
    undici volte al secondo.
2026-09-18 Il piatto vuoto lo dichiara il sensore, non lo deduce la camera
    Lo sfondo che il rivelatore ottico teneva era stato imparato CON UNA
    BOTTIGLIA DAVANTI. Da allora la differenza restava a zero, il riquadro
    dell'etichetta non si trovava piu', e all'OCR arrivava il ritaglio fisso
    con dentro mezza stanza: misurato sul dispositivo, tredici regioni di
    testo invece di cinque, e la rilevazione da 274 a 750 millesimi, perche'
    la post-elaborazione del rilevatore costa per regione trovata e le
    regioni di troppo erano il calendario appeso dietro il piatto.
    La correzione esisteva gia' ma era una via di scampo, e scattava solo
    dopo tre scansioni fallite di fila. Adesso e' la regola: quando il
    sensore di d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
2026-09-18 Al livello generico il modello non scrive, nemmeno se acceso
    GENERICO vuol dire: l'etichetta si e' letta benissimo e in archivio non
    c'e' niente che si possa nominare senza inventarlo, quindi si ripete
    SOLO cio' che c'e' scritto. Ogni parola viene dalla bottiglia, per
    costruzione.
    Dare quei quattro fatti a un modello e chiedergli una descrizione e'
    chiedergli di riempire il resto, e il resto se lo inventa. Visto sul
    dispositivo, su un Lambrusco Grasparossa: «Colore giallo, con sapore
    delicato e acidita' equilibrata. In bocca e' un vino di media
    struttura, con bella acidita' e buona acidita'.» Un rosso dichiarato
    giallo, una zona che non esiste, e l'acidita' detta due volte.
    `verifica` no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
2026-09-18 La pronuncia segue la lingua della voce
    Sentito sul dispositivo: in inglese «DOCG» diventava «denominazione di
    origine controllata e garantita», e la voce inglese lo compitava
    all'inglese. La tabella di pronuncia era una sola, italiana, e si
    applicava a qualunque voce.
    Ora ce n'e' una per lingua, scelta dal nome del modello vocale. In
    inglese le sigle si sciolgono nella loro forma inglese, quella delle
    etichette esportate. Le respellature fonetiche non ci sono di
    proposito: «sciardone'» serve a una voce italiana che leggerebbe
    «Chardonnay» all'italiana, mentre una voce inglese quel nome lo sa
    gia' dire.
2026-09-18 Quattro cose viste a schermo, e nessuna era un dettaglio
    «Garda Cabernet 2008» scritto sopra la descrizione di un Lambrusco
    Grasparossa. In modo carta i fatti dell'archivio non si aggiornavano
    mai, e il titolo veniva sempre da li': dal vino PRECEDENTE. Ora ogni
    riconoscimento azzera entrambe le vie - i fatti e la voce della carta -
    e il titolo viene da chi racconta davvero.
    L'inglese che dopo la prima riga tornava italiano, scritto e letto. La
    carta e' un CSV con la sola descrizione italiana; la prima frase la
    compone il lessico nella lingua giusta, il resto era il file com'e', e
    la voce inglese lo compitava. Ora la carta dichiara le lingue che parla
    - dalle colonne, `descrizione_en` e `t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
2026-09-18 Il modello linguistico si accende col modo, e il sensore decide solo di cio' che ha visto
    Due cose, tutte e due dal dispositivo acceso.
    `llama-server` fermo, senza nessuna richiesta, sta all'88% di un core -
    misurato - e sono i quattro core su cui l'OCR deve leggere un'etichetta
    in meno di un secondo. Con la generazione spenta dalle impostazioni quel
    core era regalato a nessuno: la rilevazione del testo passava da 274 a
    750 millesimi. Ora il servizio lo accende e lo spegne il modo di
    racconto, in un thread, e nessuno lo tira piu' su all'avvio. Se e'
    appena stato acceso si aspetta che risponda, con la scritta «sto
    scrivendo» gia' a schermo; se non risponde si racconta dall'archivio.
    E il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
2026-09-18 Quanta batteria resta, senza che la batteria lo dica
    Il power bank non espone niente e non si puo' aggiungere un filo. Si
    integra la potenza nel tempo: una base di 5 W - schermo, SoC a riposo,
    hub e camera in moto, anello e amplificatore - piu' 2,5 W a CPU piena,
    letta da /proc/stat, che e' l'unica misura vera che la board offre di
    quanto sta lavorando, e 0,6 W quando la voce suona.
    La capacita' e' 60 Wh su 99 nominali: la parte bassa di quello che un
    power bank da scaffale restituisce a 5 V. Conservativa, non di piu': una
    tacca vuota con tre ore davanti insegna a non guardarla.
    Si azzera da sola dopo una notte di fermo - il dispositivo si spegne
    staccando la corrente, e si ricarica di not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
2026-09-18 Il verificatore impara le bugie fatte di parole vere
    Dodici testi generati sul dispositivo, riletti uno per uno: cinque
    sbagliati, e la verifica li aveva promossi tutti. Non inventavano nomi -
    e' quello che controllava - inventavano rapporti fra nomi veri.
    «Sangiovese e Amarena, i vitigni piu' coltivati d'Italia», tre volte su
    dodici: l'amarena e' una nota olfattiva dei fatti, non un'uva. «Amarone
    della Valpolicella, un vitigno compagno dei Rondinella»: e' il vino.
    «Questa spumante» detto di un Amarone. E quattro testi tronchi a meta'
    frase: «Da servire fra i diciassette e i dici».
    Ora ogni nome proprio in un contesto da vitigno dev'essere un vitigno
    dei fatti; un vino fermo non puo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
2026-09-18 I documenti dicono quello che il dispositivo fa adesso
    Il modello non parte piu' al boot, l'anello non lampeggia per lo scatto,
    l'assestamento si misura invece di aspettarlo, e il sensore di distanza
    vede il vetro scuro ma non quello chiaro: il collaudo lo dice, con i
    tempi attesi per l'uno e per l'altro. E c'e' la riga della batteria.
2026-09-18 Le note olfattive non sono ne' uve ne' cibi
    Seconda rilettura dei testi generati, dopo la prima stretta: le note
    finivano nei posti delle uve e dei cibi, in minuscolo, dove il controllo
    sui nomi propri non guarda. «Nasce dall'incontro di mela verde e fiori
    bianchi, il vitigno Prosecco». «Da servire con amarena, prugna o tannino
    morbido». E «delicato, delicato», il modello che gira a vuoto.
    L'elenco delle uve finisce alla prima virgola o a un «con»: dopo comincia
    un'altra cosa, e «Nasce dal Sangiovese, con note di amarena» ha l'amarena
    al posto giusto.
2026-09-18 Il permesso di accendere il modello sta in una regola polkit, non in sudo
    L'applicazione gira sotto NoNewPrivileges=yes: `sudo -n systemctl start`
    falliva con exit 1, dentro un thread, e il modello restava com'era. Ora
    il comando e' `systemctl` e basta, e una regola polkit lascia all'utente
    arduino QUELLA unita' e nessun'altra. Verificato sul dispositivo:
    archivio -> spento, generativa -> acceso, e all'avvio segue il modo
    salvato.
    L'unit dell'applicazione porta le opzioni con cui il dispositivo va in
    servizio - modello disponibile, modello addestrato, carta dei vini.
    Senza `--con-modello` il modo «generativa» non si puo' scegliere e un
    modo salvato torna in silenzio all'archivio: e' succe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
2026-09-19 La batteria si vede dove si decide, e le impostazioni si chiudono con la X
    L'icona stava in basso a destra sulla scena, otto pixel: non si vedeva,
    e un'icona che non si vede e' una bugia per omissione. Ora sta nella
    riga «Batteria ricaricata», larga un dito, e toccare la riga la riporta
    a piena - che e' anche il ritorno visivo del tocco.
    La scritta «chiudi» appiccicata in fondo copriva l'ultima riga. Al suo
    posto la X in basso a sinistra, la stessa che interrompe un racconto:
    e' lo stesso gesto e sta nello stesso posto. L'elenco scorre sotto.
2026-09-19 Il racconto si compone dai fatti, breve, e ogni vino con le sue parole
    Il modo «archivio» diventa l'unico di cui si possa dire che non
    inventa, e lo diventa togliendogli le eccezioni: ne' il modello dal
    vivo ne' la cache - che e' lo stesso modello un giorno prima - arrivano
    piu' in bocca al dispositivo. Un Franciacorta in modo «archivio» diceva
    «Borgognone, ovunque nel mondo», dalla cache. Ora ogni frase nasce da un
    campo dell'archivio o da una citazione del disciplinare, dentro una
    forma del lessico. In modo «generativa» il modello resta, con la cache
    dietro, e la verifica davanti a tutti e due.
    Breve: al massimo quattro frasi dopo l'apertura, dove prima erano fino
    a sette. Da dove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
2026-09-19 Novantasei modi di dire la stessa cosa, e nessuno ne dice una in piu'
    Ogni frase del racconto composto ha ora tre o quattro forme equivalenti
    per lingua. Sono passate da una scrittura e da due revisioni
    indipendenti, per fedelta' ai fatti e per lingua, e poi da una rilettura
    a mano, una per una: via «Ecco il...», che a voce sintetica suona
    teatrale, e via i plurali che stonano con un vitigno solo. Le regole:
    stessi segnaposto, nessuna parola che affermi qualcosa del vino, niente
    colori, cibi, provenienze, bollicine, cifre, nomi propri; una frase, un
    punto, impersonale.
    Il tetto e' cinque frasi, apertura compresa. Il vitigno si nomina
    sempre, prima della sua scheda - «Questo e' un Valdini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
2026-09-19 La revisione del racconto composto: trentatre' segnalazioni, riprodotte sull'archivio vero
    Una revisione a quattro lenti - garanzia, correttezza, lingua, regressioni
    - sul racconto composto dai fatti, ogni segnalazione riprodotta sul
    database del dispositivo. Le vere stanno qui.
    La scheda del vitigno finiva attaccata al vino senza dire di quale uva
    parlava: «Questa bottiglia e' un Franciacorta. Borgognone, ovunque nel
    mondo.» Parole vere dell'archivio, soggetto sbagliato, in 1.699
    tipologie. Ora la scheda dice la sua uva: con un'uva sola si aggancia
    alla frase delle uve - «Nasce da Chardonnay: borgognone, ovunque nel
    mondo» - con piu' uve porta il nome davanti.
    Le citazioni del discipl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
2026-09-19 Lo stesso metro per ogni modello, e tre cose che il metro non vedeva
    `scripts/valuta_generativa.py`: gli stessi vini ogni volta, a parita' di
    seme, dai tre gradini che il dispositivo racconta; il modello si interroga
    via llama-server, sul PC o sul dispositivo, con la stessa catena del
    dispositivo - `prompt_addestrato` e `_ripulisci` comprese. Ogni testo passa
    da tre controlli: la `verifica`, le parole di contenuto fuori dai fatti,
    e l'ortografia contro un vocabolario italiano. E la «gabbia»: una
    grammatica costruita dai fatti della bottiglia piu' un lessico chiuso, per
    misurare quanto vale vincolare il modello alle sole parole ammesse.
    Serve a una cosa sola: sapere se un cambiamento rende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
2026-09-19 La temperatura misurata, e un nome che torna non e' una ripetizione
    Trenta vini, stesso modello: a 0,7 passano 18 su 30 con 1,2 parole
    fuori dai fatti a testo, a 0,2 passano 20 con 0,7. Un modello da mezzo
    miliardo non ha varieta' da spendere. E una penalita' leggera sulle
    ripetizioni, che era il difetto piu' frequente.
    La regola sulle coppie ripetute guardava la frase gia' senza maiuscole,
    e bocciava «Nasce dal Cabernet Sauvignon ... il Cabernet Sauvignon»:
    il vitigno detto due volte non e' il modello che gira a vuoto.
2026-09-19 La gabbia: il modello sceglie e combina, ma solo fra parole ammesse
    Una grammatica costruita per ogni bottiglia: le parole dei suoi fatti,
    piu' un lessico chiuso di parole di raccordo ricavato dai testi del
    corpus che passano la verifica attuale - 310 parole, viste almeno due
    volte - piu' cifre e punteggiatura. llama.cpp la applica a ogni token:
    il modello non puo' scrivere una parola che non stia li' dentro. Non e'
    un controllo a posteriori, e' un vincolo strutturale.
    Misurato con lo stesso metro, trenta vini, temperatura 0,2: senza gabbia
    passano 22 su 30 con 0,67 parole fuori dai fatti a testo; con la gabbia
    25 su 30 e 0,50. Un terzo di tempo in piu'. Quel che resta fuori sono i
    rapporti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
2026-09-19 La bottiglia c'e' se lo dice il sensore, e nessun altro
    Era una decisione a due voci, sensore e camera, con la camera a decidere
    quando il sensore taceva. E' finita cosi': un oggetto coperto a lungo
    sul sensore, poi tolto, e la camera che continuava a vedere «qualcosa»
    per sempre - il suo sfondo era stato imparato con l'oggetto davanti -
    mentre il sensore diceva, giustamente, che non c'era niente. Il
    dispositivo scandiva un piatto vuoto ogni sei secondi, senza fine, con
    la CPU a tre di carico.
    Ora la regola e' una sola. Il sensore vede qualcosa: si legge e si
    racconta. Non vede niente: non si cerca niente. La camera serve solo a
    dire DOVE sta l'etichetta e a imparare com'e' fatto il piatt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
2026-09-19 Il modello v6, il metro nei documenti, e una parola doppia tolta alla fonte
    Il registro porta cinque citazioni con una parola ripetuta di seguito -
    «leggermente erbaceo, erbaceo, secco» - e il racconto che le copiava,
    composto o scritto dal modello, veniva bocciato dalla verifica per una
    ripetizione che non era sua. Si toglie dove la citazione entra.
    E il documento sulla qualita' dice il modello attuale: v6, addestrato su
    un corpus rifatto col verificatore nuovo - 447 testi del maestro su
    2.046, piu' 446 composti dai fatti, meta' in inglese - e misurato con lo
    stesso metro del v4: 28 su 30 contro 22, in italiano; 30 su 30 in
    inglese, con la voce della composizione. La scelta - «archivio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
2026-09-19 Il colore di un vino e' un colore, e gli spumanti ritrovano il registro
    La colonna `tipo` di X-Wines mescola due cose: il colore e lo stile.
    «Red», «White», «Rosé» sono colori; «Sparkling» e «Dessert» no, e per
    2.948 vini su 19.602 - un vino su sette - finivano stampati nei fatti
    come «Colore: spumante». Il modello lo ripeteva fedelmente, ed e' uscito
    «di colore spumante» tre volte su trenta nella misura di riferimento.
    Peggio, e non si vedeva: `_disciplinare` accetta solo un colore vero, e
    quei vini non hanno MAI ricevuto una citazione del registro. Misurato:
    zero su centocinquanta spumanti e zero su centocinquanta dessert, contro
    il sessantuno per cento dei rossi. Sono i fa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
2026-09-19 La regione che nessuno leggeva, e tre difetti trovati su quasimila racconti
    Il campo `regione` sta in archivio per 375 denominazioni su 532 e non lo
    usava nessuno. E' il fatto che manca proprio dove il modello inventa -
    «Catarratto, un grande abruzzese del Piemonte» - e adesso arriva ai
    fatti di denominazioni, tipologie e vini, nel blocco esteso e nella riga
    compatta che il modello legge.
    Si dice anche nel racconto, ma solo quando c'e' poco altro: su 1.932
    record provati nelle due lingue, 227 non avevano ne' vitigni ne'
    citazioni ne' abbinamenti e il racconto era una frase sola, il nome e
    basta. Ora sono 168, e quelle che restano non hanno davvero nient'altro.
    Tre difetti trovati facendo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
2026-09-19 Il modello scrive solo quando il registro ha detto la sua
    Duecentodieci bottiglie stratificate - settantasette strati: livello,
    colore, stile, ricchezza dei fatti, presenza delle citazioni - passate
    dal modello v6 in italiano, in inglese e dentro la gabbia. Da li' due
    conclusioni, e una rovescia la conclusione precedente.
    **Il cancello.** Con la citazione del disciplinare il modello passa la
    verifica 84 volte su 85, il 98,8%; senza, 104 su 125, l'83%. E non e'
    solo il conteggio: letti a mano, i testi senza citazione sono quelli in
    cui inventa i piatti - «si serve bene con pesce, verdure e verdoli»,
    dove «verdoli» non e' nemmeno una parola - e mette i cibi al posto dei
    profumi. Quelli co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
2026-09-19 Il blocco inglese in inglese, e il colore che nessun vocabolario diceva
    Letti i testi inglesi che il modello scrive, due difetti nell'INGRESSO,
    non nell'uscita.
    Le etichette del blocco dei fatti erano italiane sempre - «Nome»,
    «Gradazione», «Temperatura di servizio» - con i valori tradotti: meta' e
    meta'. Un ingresso cosi' insegna che l'italiano e' la lingua delle
    etichette, e infatti nei testi inglesi ricompariva la forma del blocco
    con le etichette tradotte a orecchio: «Amarone della Valpolicella:
    Veneto · Disgust: Red with garnet notes · Taste: Fruity and dry». Ora le
    etichette hanno una serie per lingua, e le note sensoriali e la scheda
    del vitigno seguono la lingua come gia'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
2026-09-19 Un nome con una parola doppia non e' una ripetizione, e «vino» non e' una categoria
    «Il Sangiovese Sangiovese Predappio» di Noelia Ricci sta in archivio
    cosi', come «Pantelleria Pantelleria-Bianco»: la regola sulle parole
    attaccate guarda ora solo il minuscolo, che e' dove il modello gira a
    vuoto.
    E la categoria generica non entra piu' nella riga compatta: «Wine»
    tradotto fa «vino», e di quel vino non dice niente. Restano quelle che
    dicono qualcosa - spumante, passito, liquoroso.
2026-09-19 Che cosa ESCE dal dispositivo: centottanta bottiglie, zero sbagliate
    `scripts/prova_finale.py` misura il prodotto, non il modello. Chiama
    `Narratore.racconta` come lo chiama il dispositivo - il cancello, i due
    tentativi, la verifica davanti a ognuno, il testo pronto, la
    composizione che chiude - e guarda quel che ne esce.
    Su 180 bottiglie, italiano, modello v6:
    esce sbagliato 0 e dev'essere zero, per costruzione
    ammesse dal cancello 46 %
    di quelle, scrive il modello 98 % (80 su 82: i due che cadono
    scendono alla composizione)
    frasi in media 3,1
    parole fuori dai fatti 0,4 quando parla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
2026-09-19 In inglese la stessa frase diceva le uve e la regione
    «It comes from Glera/Prosecco» e «It comes from
    Conegliano-Valdobbiadene»: la stessa forma per due cose diverse. Chi
    legge non puo' distinguerle, e il modello che impara dai testi composti
    nemmeno - infatti metteva i luoghi dove vanno le uve. La frase della
    regione ora dice «si produce», che e' quello che vuol dire.
    L'ha trovato una regola nuova: il nome del vino o della sua
    denominazione messo fra le uve. Passava perche' quel nome STA nei fatti,
    e nessuno guardava in che posto fosse finito. Si flagga solo se
    nell'elenco non compare nessuna delle uve vere - «Brachetto d'Acqui»
    contiene il Brachetto, ed e' un modo legittimo di dir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
2026-09-20 «Si ottiene da Restivo», e Restivo e' il produttore
    Letto sul dispositivo, in tutte e due le lingue: il modello apre con la
    frase del lessico «Si ottiene da {vitigni}» e ci mette dentro il nome
    della cantina. Passava per due motivi:
    - la regola che guarda i nomi messi fra le uve conosceva il nome del
    vino, la tipologia e la denominazione, ma non la cantina;
    - «si ottiene da» non era fra i contesti che aprono un elenco di uve,
    anche se e' una frase che il lessico scrive e che il modello ha
    imparato da li'.
    Rileggendo con questa regola i testi gia' misurati dei due modelli:
    trentuno invenzioni di questo tipo passavano prima, tre adesso.
    Sui racconti composti - 4.664, due lingue -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
2026-09-20 In inglese l'intervallo si congiunge in inglese
    «Serve at 8 e 10 degrees»: il trattino fra due numeri si scioglie da
    sempre, ma con la congiunzione italiana, in qualunque lingua si stesse
    parlando. E' lo stesso difetto delle sigle, in piccolo.
    E in italiano il decimale vuole la virgola: «13.0%» si sente «tredici
    punto zero». Il separatore delle migliaia ha tre cifre dopo il punto e
    resta com'e'.
2026-09-20 Un Franciacorta Rosé non e' un Franciacorta
    La tipologia si aggancia al vino per somiglianza del nome, e se la
    denominazione ne ha una sola la si prendeva senza confrontare niente. Da
    quella tipologia vengono il colore, la categoria e la citazione del
    disciplinare: cioe' la descrizione di un altro vino, letta a voce con
    sicurezza.
    Il nome del vino il colore spesso lo dichiara - «Franciacorta Rosé»,
    «Lambrusco Frizzante Rosato Dolce» - ed e' quel che c'e' scritto
    sull'etichetta, che e' poi l'unica cosa che il dispositivo legge davvero.
    Adesso quella parola esclude le tipologie d'altro colore, e se non ne
    resta nessuna si tace. I nomi dei vitigni si tolgono prima di cercarla,
    perche' «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
2026-09-20 «It comes from Trentino-Alto Adige» dice da dove viene
    In inglese la stessa apertura serve alle uve e alla provenienza, e la
    regola che guarda i nomi messi fra le uve bocciava la seconda. Se nel
    pezzo c'e' la regione dei fatti si sta parlando di quella, e si lascia
    stare.
    Misurato sul corpus di addestramento riletto con le regole nuove: sette
    righe inglesi su 323 non passavano, adesso nessuna. Le invenzioni vere -
    il produttore o la denominazione detti come uva - restano prese: su
    migliaia di testi salvati dei due modelli nessuna sfugge, e sui racconti
    composti gli allarmi falsi restano zero.
2026-09-20 Una bollicina non e' il vino fermo che le somiglia
    Stessa forma del difetto del colore, un gradino piu' in la': la tipologia
    si aggancia al vino per somiglianza del nome, e «Prestige Collection Brut
    Prosecco Treviso» si prendeva «Prosecco-Wine» - il Prosecco fermo -
    perche' somiglia di piu' di «Prosecco Spumante», che sta nella stessa
    denominazione due righe sotto. Da quella tipologia vengono il colore e la
    categoria.
    In archivio: 1.045 bollicine agganciate a una tipologia ferma, 986 con
    citazione. Adesso sono 209 e 188, e quel che resta e' denominazioni che
    una tipologia con le bolle non ce l'hanno.
    Si preferisce, non si pretende, per la stessa ragione vista con il
    colore: restare s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
2026-09-20 Il registro non e' scritto per essere letto a voce
    Due difetti delle citazioni, tutti e due sentiti rileggendo a mano i
    racconti del modello.
    Trentanove righe cominciano col verbo - «é fresco, piacevole e armonico»
    - e la frase che le cita ce ne mette un altro davanti: «il gusto è é
    fresco». Il verbo lo mette chi cita, non la citazione.
    Altre centoventisei sono troncate a meta', con l'ultima parola appesa:
    «giallo paglierino più o meno intenso, il», «rosso rubino tendente al
    granato, ha un», «vinoso, fresco e». Il taglio viene dal documento di
    origine, e una frase che finisce su un articolo si sente subito.
    Si ripuliscono dove le citazioni si rendono utilizzabili, cosi' vale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
2026-09-20 «Nasce da Barbaresco», e «Si produce in Produttori di Manduria»
    Altri due, trovati rileggendo a mano i racconti dei casi difficili.
    Fra le aperture che introducono un elenco di uve c'erano «dal», «dalla»,
    «dall'», «dai» - non il «da» liscio. «Nasce da Barbaresco: rosso granato»
    passava, e Barbaresco e' il vino.
    E il nome della cantina finiva dove va il luogo: «Si produce in
    Produttori di Manduria». Il modello impara la frase «Si produce in
    {regione}» e, quando la regione nei fatti non c'e', la riempie col primo
    nome proprio che trova. Si guarda solo la cantina, e solo se nel pezzo la
    regione non c'e': una denominazione e' quasi sempre anche un luogo, e
    bocciare «si pro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
2026-09-20 «Di odore tico di moscato»: era «aromatico»
    Dieci citazioni del registro cominciano a meta' di una parola o a meta' di
    una frase, perche' il taglio del documento d'origine e' caduto li'. Si
    sentiva al tavolo, e la dicevano tutti e due i modelli, il che voleva dire
    che veniva dai dati.
    Si toglie il troncone, ma quel che resta deve reggere da solo: dopo «tico»
    puo' restare «colore giallo paglierino più o meno intenso, odore
    caratteristico e fragrante», che va benissimo, oppure «di moscato», che nel
    giro di frase diventa «di odore di moscato». Sotto i sedici caratteri si
    lascia perdere: il narratore ha comunque il resto dei fatti.
    E «ove prevalgono le note fruttate» non si recu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
2026-09-20 Il colore non si beve
    «In bocca è asciutto, armonico, di colore bianco e con acidità alta».
    «On the palate, bright ruby red». Il modello ha tre citazioni del
    disciplinare - colore, odore, sapore - e ogni tanto mette quella del
    colore nel giro di frase del gusto. Le parole sono tutte vere, il posto
    no, e la verifica non guardava in che posto fossero.
    Misurato sui racconti salvati: succede nel 3-9% dei testi scritti dal
    modello, in tutte e due le lingue e in tutte e due le versioni. Si
    guardano solo le parole che un colore lo sono e basta - «rubino»,
    «granato», «di colore X» - perche' «secco» e «pieno» in bocca ci stanno.
    Sui racconti composti, nessun allarme falso.
2026-09-20 «Nasce dal Friulano», e il vitigno era il Refosco
    Sette schede di vitigno si aprono con un aggettivo che e' anche il nome
    di un'altra uva: «Friulano, nella versione dal peduncolo rosso» sta per
    «del Friuli», ma il modello l'ha letta come si legge, e sul dispositivo
    e' uscito «Nasce dal Friulano». Lo stesso per «Calabrese» (Gaglioppo) e
    «Portoghese» (Verdelho). Le versioni inglesi lo dicevano gia' bene: «From
    Friuli, in its...».
    Si riapplicano con `build_db.py --solo-vitigni`, che e' li' per questo.
    E due cose del costruttore, trovate provandolo:
    - `main()` chiamava `costruisci_indice`, che non esiste piu': l'indice si
    rifa' in `scripts/reindicizza.py` da quando lo si e' vo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
2026-09-20 Le uve non sono il produttore, e la scheda non va sul vino
    Altri due nomi veri messi nel posto di un'altra cosa, letti rileggendo a
    mano i racconti inglesi.
    «This is the "Barbera del Monferrato" by Grignolino, Freisa, Dolcetto and
    Barbera»: quelle sono le uve, e quel record una cantina non ce l'ha
    nemmeno, e' una denominazione.
    «Morellino di Scansano: Italy's most planted grape and the soul of
    Tuscany»: quella e' la scheda del Sangiovese. La forma «{vitigno}:
    {scheda}» e' giusta, e la composizione la usa; qui davanti ai due punti
    c'era il nome del vino. Quando il vino si chiama come la sua uva - «Nero
    d'Avola» - non si dice niente, perche' li' e' giusto.
2026-09-20 Ogni voce dell'elenco dev'essere un'uva
    «Nasce dall'incontro di tre vitigni: Trebbiano, Toscano, Abruzzese e
    Soave», letto sul dispositivo. La scheda del Trebbiano dice che non e' un
    vitigno solo «ma una famiglia numerosa: il Toscano, l'Abruzzese, quello
    di Soave», e il modello ne ha fatto quattro uve di questo vino. Parole
    tutte vere, fatto falso: bastava che la parola stesse da qualche parte
    nei fatti perche' passasse.
    Adesso si guarda voce per voce, non parola per parola: «Brachetto
    d'Acqui» e' una voce sola e contiene il Brachetto, «Trebbiano, Toscano,
    Abruzzese e Soave» sono quattro voci e tre non sono uve.
    Tre cose restano fuori dal controllo, e sono tre allarmi falsi che si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
2026-09-20 La scheda del vitigno vale solo se e' attribuita
    «Nasce da Siciliano, chiamato Ansonica in Toscana dove è arrivato
    dall'isola»: e' la scheda dell'Inzolia messa dove vanno le uve, e
    «Siciliano» un vitigno non e'. Passava perche' il controllo toglieva di
    mezzo la scheda ovunque la trovasse.
    Adesso la toglie solo quando e' preceduta dai due punti, cioe' quando e'
    attribuita a qualcuno: «Trebbiano: Non un vitigno solo ma una
    famiglia...» e' la scheda del Trebbiano e non si giudica; la stessa
    frase dopo «Nasce da» e' un'affermazione, e si giudica.
    Quarantotto schede si aprono con un aggettivo di provenienza -
    «Piemontese, del Roero», «Toscano, storico compagno del Sangiovese» - ed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
2026-09-23 Il rilascio diventa una procedura, e l'unita' carica lo studente
    Il rilascio e' sempre stato una sequenza di comandi tenuta a mente e
    ricopiata a mano. Adesso e' `scripts/rilascio.sh`, e serve soprattutto a
    ogni unita' nuova: quel che non e' scritto non si ripete uguale.
    Tre cose che la sequenza tenuta a mente sbagliava, tutte trovate
    eseguendola davvero:
    - usava `rsync`, che sulla UNO Q non c'e'. Una riga di rsync in mezzo a
    uno script che si crede riuscito e' peggio di un errore: ora tutto
    passa da `scp`, e ogni file che conta si riconfronta con md5 dopo
    essere arrivato.
    - non copiava `data/lessico/frasi.json`, che e' dati e non codice e per
    questo si dimentica. Una board col cod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
2026-09-23 Spegnere il modello mentre scrive non deve costare un minuto e mezzo
    Il servizio del modello si accende e si spegne col modo, e a vuoto lo
    spegnimento e' istantaneo. Ma se arriva mentre il modello sta scrivendo,
    `llama-server` non risponde al SIGTERM finche' non ha finito: con il
    minuto e mezzo di default systemd lo lascia in «deactivating» per tutto
    quel tempo, poi lo ammazza, e l'unita' resta in stato «failed».
    Misurato sul dispositivo mandandoci contro una prova mentre il modo era
    «carta»: novanta secondi, e in quella finestra una richiesta di
    accensione sarebbe rimasta in coda.
    Quindici secondi bastano, e `KillMode=mixed` non aspetta i thread di
    lavoro: non c'e' niente da salvare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
2026-09-23 Il produttore letto sull'etichetta non si butta piu' via
    Letto sul dispositivo, su una bottiglia vera: «ALBAROSSA NEGROAMARO
    PALAMÀ VINICOLA DEL SALENTO». L'OCR legge «Palamà» benissimo in otto
    letture su dieci, in archivio ci sono tre soli vini di Palamà - e il
    dispositivo diceva «Questo è un Salento, indicazione geografica protetta.
    Si produce in Puglia». Due frasi, e la cosa piu' identificante
    dell'etichetta buttata.
    Il perche' e' nel punteggio. Il record giusto - «palama albarossa salice
    salentino rosso» - prende 35, perche' ha cinque parole e l'OCR ne legge
    una sola: il nome del vino e' in un carattere decorativo che non si legge
    mai. Un Negroamaro di un ALTRO produttore -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
2026-09-23 Il rilevatore guarda a 480, e «sopra costa e basta» non era vero
    Il numero era 320 e il commento diceva che sopra si paga senza guadagnare.
    Veniva da UN'etichetta: a 756 si leggevano le stesse righe di 320. Sulle
    139 vere, con l'OCR della board, non e' cosi':
    cantina letta nome letto riconoscimento tempo
    lato 320 112/139 72/139 87,1% 1,02 s
    lato 480 114/139 74/139 90,6% 1,32 s
    Trenta centesimi per tre punti e mezzo di riconoscimento, e i casi
    «sbagliato E dichiarato certo» restano zero in tutti e due. Su una
    bottiglia vera la differenza si sente: a 320 `APADOSEN · PALAMA ·
    SALENTO`, a 480 `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
2026-09-24 Un marchio solo, un carattere vero, un sistema per tutto il resto
    Il foglio di stile chiedeva EB Garamond da sempre, ma sulla prima unita'
    il pacchetto non c'era - preparata a mano prima che install.sh lo
    prevedesse - e sul vetro tutto usciva in DejaVu Serif. Il disegno non si
    era mai visto come era stato pensato. Adesso il carattere viaggia con la
    pagina, servito dall'applicazione su /fonts: ogni unita' e ogni
    anteprima mostrano la stessa cosa, qualunque pacchetto ci sia sotto.
    Sottoinsieme latino, pesi da 400 a 800, 119 KB il tondo e 135 il
    corsivo, licenza OFL accanto ai file.
    Il marchio: il nome e una goccia di vino al posto del puntino della i.
    Prima erano quattro mirini, una bottiglia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
2026-09-24 La bottiglia fuori archivio: che cosa si e' fatto, detto per intero
    «Questa bottiglia non è nel mio archivio: quello che le ho detto è
    scritto sull'etichetta» diventa «Questa bottiglia non è nel mio
    archivio; la descrizione è stata generata in autonomia sulla base dei
    dati e del catalogo a mia disposizione», e in inglese lo stesso.
    Passa la verifica del dispositivo, e sui 4.664 racconti composti le
    bocciature restano zero.
2026-09-24 Una bottiglia corretta a mano si riconosce la volta dopo
    Quando una bottiglia non e' in archivio, chi sta in sala potra'
    scriverne titolo e descrizione. Il dispositivo conserva la foto
    dell'etichetta, le parole che ne ha letto e il testo, e quando la
    bottiglia torna sul piatto la riconosce da quelle - prima dell'archivio,
    del modello e della carta, cioe' in qualunque modo di racconto - e la
    racconta con le parole di chi l'ha scritta.
    Riconoscerla e' la parte delicata: sbagliare qui vuol dire raccontare un
    vino con la descrizione di un altro. Due segnali, e nessuno basta da
    solo se non e' schiacciante: quante delle parole lette la volta scorsa
    si rileggono adesso, e quanti punti dell'etichet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
2026-09-24 La correzione si scrive dal vetro: il pulsante, l'editor, la tastiera
    Sulla bottiglia fuori archivio, sotto il titolo, compare «Correggi la
    descrizione»; su una gia' corretta, «Modifica la descrizione». Sta
    nell'intestazione e non in coda al racconto, dove stava prima: li'
    finiva sotto la sfumatura del testo, o fuori vista finche' il testo non
    scorreva fino in fondo. Compare insieme al testo, non prima, e ha il
    filetto e l'oro dei comandi. Si vede alto 60 pixel e si tocca alto 108:
    il bersaglio e' la scatola intera, perche' `rendiToccabile` agisce solo
    se il dito si alza dentro il riquadro dell'elemento.
    L'editor copre tutto lo schermo - lingue, volume e angolo delle
    impostazioni compre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
2026-09-24 La frase detta resta in vista, anche quando e' piu' alta dello schermo
    Sulla bottiglia fuori archivio l'ultima frase - «Questa bottiglia non è
    nel mio archivio; la descrizione è stata generata in autonomia...» - e'
    di quattro righe, e l'ultima non si leggeva mai. Tre cause, misurate
    nella pagina vera con Chromium:
    - la frase si centrava nella scatola del testo, che continua sotto i
    comandi: il centro vero della parte leggibile sta 88 pixel piu' in
    alto. Ora `segui()` la mette fra le due sfumature della maschera;
    - il fondo vuoto sotto il testo era alto 176 pixel, cioe' fin dove la
    sfumatura finisce: l'ultima riga del racconto non poteva salire oltre
    meta' dissolvenza. Ora e' 216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
2026-09-24 Salva non salvava: la rotta prendeva il corpo per un parametro della query
    Provato sul dispositivo, a tocchi veri sul touchscreen: la tastiera
    scriveva, «Salva» riceveva il tocco, e non succedeva niente - la riga
    sotto la barra si svuotava e l'editor restava aperto.
    La rotta dichiarava il corpo come `richiesta: Request`, con `Request`
    importato dentro `crea_app`. Con le annotazioni rimandate (`from
    __future__ import annotations`) FastAPI risolve il nome fra quelli del
    modulo, non lo trova, e lo tratta come un parametro della query
    obbligatorio: ogni salvataggio tornava 422. I test chiamavano i metodi
    dell'app direttamente, e passavano tutti.
    Ora il corpo e' un `dict` dichiarato con `Body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
2026-09-24 A racconto finito, dodici secondi per arrivare a «Correggi»
    Sulla bottiglia fuori archivio la frase che fa venire voglia di
    correggere e' l'ultima: «Questa bottiglia non è nel mio archivio...».
    Dopo, CONCLUSO durava due secondi e si tornava all'invito: visto sul
    dispositivo, il tocco sul pulsante e' arrivato sulla schermata d'attesa.
    Quando c'e' qualcosa da correggere o da modificare, il racconto finito
    resta a schermo dodici secondi, come la scelta fra i candidati. Per un
    vino dell'archivio non cambia niente. Mentre l'editor e' aperto il tempo
    non corre comunque: il battito non fa scadere niente.
2026-09-24 Il titolo della bottiglia fuori archivio senza articolo; il colore dove lo vuole l'inglese
    Sul dispositivo il titolo era «uno spumante rosato metodo classico,
    brut»: la stessa frase del racconto, articolo compreso. Il commento nel
    codice diceva gia' come doveva essere - «spumante rosato brut» - ma il
    lessico aveva poi messo l'articolo dentro le parole di base. Ora il
    titolo toglie l'articolo e prende la maiuscola: «Spumante rosato metodo
    classico, brut».
    In inglese il colore veniva accodato al nome: «a sparkling wine rosé
    metodo classico, brut». Adesso il posto del colore lo decide il lessico,
    con un segnaposto nelle parole di base - «uno spumante {colore}», «a
    {colore} sparklin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
2026-09-24 Il rilascio porta anche l'interfaccia, e ricarica il chiosco
    `rilascio.sh` copiava i moduli Python, il lessico, il database e i test,
    ma non `ui/static`: per due rilasci la board ha girato col server nuovo
    e la pagina vecchia, senza nessun errore - solo un'interfaccia che non
    cambiava, e il carattere che non c'era. Se ne sono accorti i test della
    pagina, che girano sulla board e hanno trovato l'index.html vecchio.
    Ora si copiano pagina, schermata d'avvio e carattere, verificati con
    md5, prima dei test. E dopo il riavvio del servizio si riavvia anche il
    chiosco: la pagina si carica una volta sola, e riavviato il server si
    riaggancia agli eventi restando quella di prima.
2026-09-24 Il chiosco dipinge a otto bit per colore
    Con --enable-low-end-device-mode Chromium usa riquadri RGBA4444: sedici
    livelli per canale. Nelle catture dello schermo della UNO Q ogni colore
    era un multiplo di 17 - la sfumatura bordeaux a gradini, l'oro spostato
    - e due riquadri vicini dello stesso nero uscivano di tono diverso:
    nell'editor della correzione un rettangolo verdastro in alto a destra.
    --disable-rgba-4444-textures tiene la modalita' leggera e riporta i
    riquadri a otto bit. Misurato sulla board: 494 colori distinti invece di
    una manciata, e la stessa memoria (processo GPU 156 MB contro 147,
    pagina 119 contro 127).
2026-09-24 I test delle rotte si saltano dove manca httpx
    Il client di prova di FastAPI vuole httpx, che nel venv della board non
    c'e': li' i tre test delle rotte davano errore invece di saltare. Sul PC
    girano come prima.
2026-09-24 Il cancella non si fermava piu': la tastiera si ricostruiva sotto il dito
    Sul dispositivo, aperta la tastiera, il cancella sembrava sempre premuto
    e non si riusciva a scrivere. Riprodotto in Chromium: un solo tocco su ⌫
    che svuota il campo, e «ciao» scritto un secondo dopo spariva lettera
    per lettera.
    La tastiera si ricostruiva a ogni cambio di maiuscola, e la maiuscola
    cambia anche sotto il dito: cancellando fino all'inizio del campo, o fino
    a dopo un punto, si riaccende da sola. Il ⌫ premuto spariva, il dito si
    alzava sul tasto nuovo, e il ripetitore del vecchio - quello che parte
    dopo 450 ms e cancella ogni 70 - non lo fermava piu' nessuno.
    Ora i tasti si costruiscono una volta pe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
2026-09-24 Un calice al posto della goccia, e la pagina d'attesa riscritta
    La goccia rossa al posto del puntino della i, da sola sul fondo scuro,
    faceva pensare a un'associazione di donatori di sangue. Il motivo adesso
    e' il vino nel bicchiere:
    - il marchio e' un calice a tulipano sopra il nome, disegnato a filo
    d'oro, col vino fino al punto piu' largo della coppa e un riflesso; la
    i torna col suo puntino;
    - i tre passi hanno ciascuno un'icona: la bottiglia, l'etichetta
    inquadrata, il calice che parla;
    - la lettura e' una bottiglia che si inclina e versa in un calice che si
    riempie; la scrittura ha il calicino che si riempie e si vuota; nella
    schermata d'avvio il vino ruota nel calice del ma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
2026-09-24 Il dubbio non si chiede piu': si dice il candidato meno specifico
    Con un riconoscimento dubbio compariva una schermata con fino a tre
    candidati, «Nessuno di questi» e dodici secondi per scegliere; quasi
    sempre nessuno toccava niente. La schermata non c'e' piu'.
    `Matcher.il_piu_generico` prende, fra il primo classificato e le
    alternative, quello di livello piu' generale - una denominazione invece
    di un vino preciso, il vitigno invece della denominazione - e a parita'
    di livello resta il primo. Se sono tutti vini di produttori diversi, il
    dubbio e' proprio la cantina: si scende allo stesso vino senza
    produttore, come quando la cantina non si legge. La sicurezza resta
    quella del dubbio e l'a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
2026-09-24 Il mirino si chiama «Debug camera»
    Nelle impostazioni e nei documenti, in italiano e in inglese. E' uno
    strumento per chi tara l'inquadratura, e il nome ora lo dice. Nel codice
    resta «mirino» (amelie.mirino, le rotte /mirino): rinominarlo avrebbe
    toccato decine di righe senza cambiare niente di quello che si vede.
2026-09-24 «Aggiungi correzioni»: si corregge ogni bottiglia, scegliendola fra quelle note
    Un interruttore nuovo nelle impostazioni, spento finche' qualcuno non lo
    accende e ricordato anche dopo un riavvio. Acceso, su OGNI racconto -
    riconosciuto o no - compare «Correggi la bottiglia» («Modifica la
    correzione» se lo e' gia'). Spento, nessun pulsante per correggere, mai:
    nemmeno sulla bottiglia fuori archivio, dove prima c'era sempre. Le
    correzioni salvate si riconoscono comunque. Cambia subito anche sul
    racconto a schermo; spegnendolo con l'editor aperto, l'editor si chiude.
    Nell'editor il titolo cerca: mentre lo si scrive, sotto la barra
    compaiono le bottiglie che il dispositivo conosce - prima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
2026-09-24 Dopo «Salva» si racconta subito il vino collegato; proposte allineate ai campi
    Due difetti visti sul dispositivo, provando l'editor col dito:
    - salvata una correzione collegata a un altro vino, il racconto che
    riparte era ancora la scheda di prima: un Asti collegato al Moscato
    d'Asti della carta veniva raccontato come Asti. Solo alla lettura
    successiva parlava la carta. Ora i fatti e la voce della carta si
    rifanno dal collegamento appena salvato, sulle righe lette all'apertura;
    - le pillole delle proposte erano centrate come la spiegazione, e quando
    non ci stavano uscivano dai due lati: la prima, la piu' pertinente, era
    tagliata. Ora partono dal bordo sinistro dei campi.
2026-09-24 Le proposte del titolo si scelgono al posto della descrizione
    Appena si comincia a scrivere il titolo, le bottiglie che il dispositivo
    conosce compaiono dove c'e' la descrizione, in caselle da toccare: tre
    colonne e due righe, cinque bottiglie con la loro provenienza e, per
    ultima, «Nessuna di queste». Quella dice quante proposte restano e passa
    alle cinque successive; finite, riporta alla descrizione per scriverla.
    Scelta una bottiglia, o passati alla descrizione, le caselle lasciano il
    posto al campo; riscrivendo il titolo tornano.
    Prima erano pillole sulla riga sopra il titolo: se ne vedevano quante ci
    stavano, e le altre uscivano dallo schermo senza modo di raggiungerle.
    Il server ne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
2026-09-24 La camera si fermava a posa 5000: tetto a 4500, e si riparte se resta muta
    Sul dispositivo, con la sala fattasi buia, la regolazione automatica ha
    portato la posa a 4902 e poi a 5000, il massimo che la camera dichiara,
    e undici secondi dopo non e' piu' arrivato un fotogramma. Ogni bottiglia
    finiva in guasto; riaprire lo stream non serviva, perche' ogni
    riapertura riapplicava 5000, e nemmeno un reset USB della camera. Solo
    spegnere e riaccendere la sbloccava.
    Misurato a camera sola, a servizio fermo, otto fotogrammi per posa: fino a
    4900 arrivano (lenti, uno al secondo circa), a 4999 e a 5000 nessuno in
    dodici secondi. Abbassata a mano la posa, la camera e' ripartita subito.
    - il tetto dell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
2026-09-24 «Ripristina il funzionamento»: il guasto che si ripete non chiede piu' di spegnere
    Un guasto isolato scade in sei secondi e torna all'invito. Quello che si
    ripete - la camera ferma, un lavoro che non torna e con cui `_avvia`
    dichiarava guasto a ogni bottiglia - finora si risolveva solo staccando
    la corrente. Ora:
    - `Amelie.ripristina` ferma racconto, annuncio ed editor; da' al lavoro in
    corso cinque secondi per uscire e poi lo lascia andare; rimette la
    camera come all'accensione; chiude e riapre l'uscita audio; riavvia il
    modello se il modo e' generativo; azzera i tentativi e torna all'invito,
    cosi' una bottiglia gia' sul piatto si rilegge;
    - si tocca dalle impostazioni, «Riprist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
2026-09-24 Il lavoro di prima si aspetta, invece di dichiarare subito guasto
    Visto sul dispositivo appena riavviato: la bottiglia «sparisce» per un
    istante durante la prima lettura (OCR da caricare, tre secondi di scatto)
    e torna; alla seconda lettura la prima sta ancora finendo, e `_avvia`
    dichiarava guasto al primo colpo. Ora il lavoro nuovo aspetta quello di
    prima fino a otto secondi, in un thread per non fermare il battito, e
    parte; se nel frattempo la bottiglia e' stata tolta non parte affatto;
    solo se quello di prima non finisce e' un guasto.
    E «altre {n}» si manda alla pagina col segnaposto intatto: il lessico
    avvisava a ogni messaggio di lingua che mancava `n`.
2026-09-25 La carta riconosce il titolo anche quando l'etichetta si legge a pezzi
    Sul dispositivo in modo carta, un Lambrusco tenuto in mano davanti alla
    camera non veniva mai riconosciuto: «LAMBRUSCO / PAROSSA DI CASTELVETN»
    faceva 54 con «Lambrusco Grasparossa di Castelvetro DOC», e la soglia
    e' 55. Ogni parola del titolo era sul vetro, ma il vetro curvo se ne
    mangiava un pezzo, e `token_set_ratio` e' tutto-o-niente sulle parole.
    Ora la somiglianza si misura anche parola per parola, come fa gia'
    l'archivio, ma solo a tre condizioni: il titolo ha almeno due parole, le
    ritrova tutte, e almeno una e' letta esatta. E il pezzo di parola deve
    somigliare almeno 75, piu' dei 70 della regola sulle parole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
2026-09-25 Quando una riga tocca il bordo del ritaglio, si rilegge piu' largo
    Le foto delle scansioni con le bottiglie tenute in mano davanti alla
    camera dicono tutte la stessa cosa: l'etichetta usciva dal ritaglio.
    «LAMBRUSCO GRASPAROSSA DI CASTELVETRO» arrivava all'OCR come «SPAROSSA
    DI CAS», l'Asti come «STI». In 37 delle 65 scansioni che hanno letto
    qualcosa, una riga di parole toccava il bordo. Due cause:
    - il riquadro della sagoma si STRINGEVA del 6 % ai lati, perche' il bordo
    del vetro sembrava da buttare: erano proprio le lettere che mancavano;
    - con una mano che regge il collo, la sagoma puo' finire spostata di lato,
    e il ritaglio prendeva mano e sfondo lasciando fuori mezza etichet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
2026-09-25 Lo scatto al volo aspetta fino a un secondo un fotogramma fermo
    Era un quarto di secondo, due o tre fotogrammi: bastava finche' le
    bottiglie si posavano. Con le bottiglie tenute in mano, in un quarto di
    secondo non arrivava nessun fotogramma fermo: si leggeva il migliore dei
    mossi. Su tre scansioni dell'Asti, «ASTI» grande come meta' etichetta e
    nemmeno una riga trovata; provate CLAHE piu' forte, gamma, nitidezza,
    grigio e scale diverse del rilevatore, e nessuna la recupera: non e'
    l'immagine da correggere, e' il fotogramma da scegliere.
    Il secondo e' un tetto, non un costo: ci si ferma al primo fotogramma
    nitido, e una bottiglia posata lo da' subito. Si paga solo quando la scena
    non arri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
2026-09-25 Castelvetro basta per il Grasparossa, Toscana non basta per il Vermentino
    Sul dispositivo, in modo carta: «CORTE DEL BORGO · OSSA DI CASTELVETRO ·
    AMBRUSCO» non veniva riconosciuto. «Castelvetro» e' scritto per intero e
    in carta sta in una voce sola, ma due cose lo buttavano via.
    «del» di «CORTE DEL BORGO» sta in venti voci, e l'intersezione con cui
    `_implicate` trova le parole date per scontate finiva vuota. Articoli e
    preposizioni ora non restringono la famiglia: `PAROLE_DI_LEGAME`.
    E la somiglianza non sapeva delle parole implicate. Ora una parola data
    per scontata conta come un pezzo appena sufficiente, ma solo se almeno
    due parole del titolo si sono ritrovate davvero, e se q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
2026-09-25 La home dice «Scegli, Posa, Ascolta», e il vino nel calice ondeggia
    Le tre frasi della schermata d'attesa sono queste, una riga per passo
    col verbo in grassetto d'oro:
    Scegli una bottiglia Choose a bottle
    Posa la bottiglia su Amelie Place the bottle on Amelie
    Ascolta la sua storia Listen to its story
    Il messaggio «lingua» manda per ogni passo il verbo e il resto, e la
    pagina li compone; «invito» e le vecchie frasi in due righe non ci sono
    piu'. E' l'unico punto in cui lo schermo da' del tu: un'insegna, non una
    frase rivolta a qualcuno, e il lessico lo annota. Le icone seguono le
    frasi: tre bottiglie con quella scelta in mezzo, la bottiglia p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
2026-09-25 Una bottiglia non riconosciuta si puo' insegnare, e la descrizione chiede l'altra lingua
    Tre cose, tutte attorno all'editor delle correzioni.
    «Mi aiuti a riconoscerla». Quando la bottiglia non si riconosce, il
    pulsante compare sulla schermata «Provi a girare l'etichetta verso di
    me?», fra un tentativo e l'altro, e su quella che arriva a tentativi
    finiti, «Non ho riconosciuto questa bottiglia.». Apre lo stesso editor
    col titolo vuoto; salvando, la bottiglia si racconta subito e la volta
    dopo si riconosce. Solo con «Aggiungi correzioni» acceso, come il
    pulsante del racconto, e solo se dall'etichetta si e' letta almeno una
    parola: una correzione si ritrova dalle parole e dalla foto ins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
2026-09-25 La bottiglia cambiata a racconto in corso si legge subito, e se e' un'altra si racconta
    Quando la bottiglia sul piatto viene sollevata e sostituita con
    un'altra, la descrizione deve cambiare subito, e per non far pesare
    l'attesa la nuova si comincia a leggere mentre si sta ancora parlando
    della vecchia. Prima si leggeva solo a racconto finito, anche dopo
    minuti.
    Ma sollevarla per versare e rimetterla e' il gesto piu' comune di un
    tavolo, e li' il racconto non deve interrompersi. Quindi si decide prima
    di interrompere, e la regola e' misurata su 75 scansioni vere di cinque
    bottiglie, confrontando la zona dell'etichetta di una foto con l'intera
    foto dell'altra:
    - la foto dice «e' la stessa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
2026-09-25 Il vitigno «na» del registro non si racconta piu'
    Visto sul dispositivo, su un Garda Cabernet: «Si ottiene da na.».
    Nell'archivio «na» e' un vitigno, ed e' un buco del registro: collegato
    a 691 tipologie, a volte come principale - il Garda Cabernet ce l'ha
    come unico - e 48 racconti pronti dicono «Nasce da na.» o «It is made
    from na.».
    Il database non si ricostruisce dal repo, quindi si scarta qui: le tre
    interrogazioni del matcher che leggono i vitigni escludono
    `VITIGNI_FINTI`, e il narratore salta i racconti pronti che ne nominano
    uno, come salta quelli che inventano. Il Garda Cabernet ora si racconta
    «Si tratta di un Garda Cabernet. Si produce in Veneto...», senza uva.
2026-09-25 Il vino del calice torna fermo: costava un core a schermata ferma
    Misurato sulla board, con la home in attesa: Chromium al 31 % di un core
    senza animazione, al 107-116 % con il vino che ondeggiava. Una
    trasformazione dentro un SVG non va al compositore e si ridisegna a ogni
    fotogramma. A scatti, cinque ridisegni al secondo, si scendeva al 35 %:
    un 5 % sempre acceso sulla schermata che resta accesa tutta la sera, a
    batteria. Il vino torna fermo, e il test ora controlla che il calice
    della home non abbia animazioni.
2026-09-26 Il database si ricostruisce dal repository, e l'installazione parte da una UNO Q nuova
    Il database dei vini si costruisce con `python3 data/build_db.py` dalle sole
    sorgenti ridistribuibili in data/sources: figshare, X-Wines, il registro UE
    delle indicazioni geografiche con i documenti unici (senza i recapiti
    personali) e l'elenco delle DOCG. Niente premi delle guide, indici da
    rivenditori o dati della grande distribuzione. Si distribuisce sotto ODbL.
    Il costruttore scrive su un file a parte e lo sostituisce solo a fine
    riuscita, attacca i vitigni alla tipologia giusta anche con le righe doppie
    della fonte, e prende la grafia delle denominazioni per le tipologie.
    scripts/install.sh porta una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
2026-09-26 Guida completa in italiano e in inglese, file di stampa e schema dei collegamenti
    Il README e' anche l'articolo per Arduino Project Hub: un solo livello di
    titoli, niente tabelle, elenchi piatti, collegamenti assoluti. Racconta come
    costruire Amelie da zero: i componenti, i pezzi da stampare, i collegamenti,
    la preparazione della UNO Q, l'installazione, il montaggio, il collaudo e
    l'uso. README.it.md e' la stessa guida in italiano.
    docs/it e docs/en, le stesse otto guide nelle due lingue:
    - 01 preparare la UNO Q;
    - 02 installare il software;
    - 03 montare, con la viteria pezzo per pezzo e l'ordine delle fasi;
    - 04 collaudare;
    - 05 usare;
    - 06 come si riconosce un'etichetta;
    - 07 come si racc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
2026-09-26 L'installatore chiede la password solo se sudo la vuole davvero
    `sudo -v` la chiede anche a chi ha sudo senza password, se una qualunque
    regola la richiede: con `sudo -n true` prima, un'installazione lanciata
    senza terminale non si ferma al primo passo. Provato aggiornando un
    dispositivo gia' in servizio: i dodici passi, il database rifatto sulla
    board, il firmware caricato, e dopo il riavvio il collaudo senza voci
    gravi e 978 test verdi sulla board.
    Nelle guide, per non dipendere dalla connessione SSH si consiglia tmux:
    senza terminale sudo non puo' chiedere la password. Il README dice quando
    la lingua torna a quella di casa: a racconto finito, tolta la bottiglia.
2026-10-06 Carta dei vini da Excel, lingua dopo Annulla, racconto generico coerente
    - La carta dei vini si legge anche come la salva un foglio di calcolo: con
    il BOM in testa, separata da punto e virgola, o in Windows-1252. Un file
    che non si riesce a leggere lascia il dispositivo sull'archivio invece di
    fermare il servizio.
    - Tornando in attesa con il piatto vuoto la lingua torna a quella di casa
    anche dopo Annulla: chi ha sollevato la bottiglia per versare e poi ha
    annullato ha lasciato il tavolo libero.
    - Un'etichetta da cui esce solo un dosaggio («Brut») chiede di girare
    l'etichetta e non aggiunge che la bottiglia non e' in archivio.
    - «Cosa trova» nella Debug camera prende il color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
2026-10-06 Guida e documentazione riviste: link d'acquisto, UNO Q di fabbrica, inglese britannico
    - Il README, in inglese e in italiano, porta i link d'acquisto di ogni
    componente e le descrizioni verificate sui prodotti: il cavo con
    l'interruttore ha la sola spina USB-C a 90°, la prolunga di ricarica si
    vende in coppia, le casse hanno il volume sul cavo, i cavi Qwiic sono nelle
    confezioni dei Modulino, il cavo del touch in quella del power bank.
    - Preparare la UNO Q parte da una board di fabbrica: la password va cambiata
    alla prima configurazione, la modalita' rete e l'SSH sono spenti e vanno
    accesi; nome, Wi-Fi e aggiornamenti si fanno senza sudo.
    - Ogni guida e' stata confrontata con il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
2026-10-06 La diagnostica controlla che la camera dia fotogrammi, non solo che ci sia
    /stato aggiunge fotogramma_s, i secondi dall'ultimo fotogramma ricevuto:
    camera resta vero anche col cavo staccato. La diagnostica lo legge a
    riposo, e la guida spiega le due voci nuove.
2026-10-06 Commenti: le denominazioni con la regione in archivio sono 376
2026-10-09 Microcontrollore, cache della voce e router: tre guasti e i loro rimedi
    - Il firmware si carica insieme al loader del core, con scripts/firmware.sh.
    Sketch e loader devono essere della stessa versione: App Lab, aggiornandosi,
    porta il suo loader, e uno sketch compilato con un altro core finisce dove
    il loader non guarda. Il caricamento riesce e il microcontrollore tace:
    niente luce, e senza sensore di distanza nessuna bottiglia. Il core passa
    alla 1.0.0, lo stesso di App Lab, e il firmware si dichiara caricato solo
    quando il microcontrollore risponde. install.sh lo lancia al passo 9 e, se
    il microcontrollore non risponde, prosegue e lo ricorda in fondo.
    - La cache della voce so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
2026-10-09 Dopo una pausa la voce riparte voce, non fruscio
    La pausa riavvolge di quanto e' gia' inviato e non ancora sentito, circa 0,65
    secondi: a 22050 Hz sono 28.665 byte, un numero dispari, e la coda e' sempre
    pari. La ripresa partiva da meta' campione, ogni campione si leggeva a cavallo
    di due, e invece della voce si sentiva un fruscio forte e spezzettato; la pausa
    dopo riallineava, e cosi' via, una volta si' e una no. Ora ogni posizione
    calcolata da un tempo - la pausa e il salto - si riporta all'inizio del suo
    campione, e la sintesi scarta un eventuale byte spaiato in fondo a una frase.
2026-10-09 Luce bianca e gialla al massimo, rossa per un guasto o a batteria scarica; la posa segue la sala
    L'anello resta acceso, LED bianchi e gialli alternati alla luminosità
    massima, mentre Amelie aspetta, legge e racconta: la stessa luce in attesa
    e durante lo scatto, così la posa trovata a riposo vale per la bottiglia.
    Diventa rosso per un guasto, e in attesa quando la stima della batteria
    scende sotto il 15%. Il microcontrollore ha un metodo nuovo, set_luce, e il
    protocollo sale a 3; la diagnostica legge dal codice quello atteso.
    La camera regola la posa in background ogni mezzo secondo, con un passo
    smorzato che stima sulla scena come la luce risponde alla posa: segue la
    sala senza oscillare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
2026-10-09 Le foto di Amelie nelle guide e nei README
    Dieci foto del montaggio e dei dispositivi finiti, in docs/images/foto, al
    posto del disegno d'insieme: nei README, nella guida al montaggio passo per
    passo e in apertura della guida all'uso.
2026-10-09 Il chiosco riparte anche dopo un cambio di nome della board, e la diagnostica guarda lo schermo
    Chromium lascia il blocco del profilo intestato al nome della board: dopo
    `arduino-app-cli system set-name` lo credeva di un altro computer e restava
    fermo su un avviso al posto di Amelie. Lo script del chiosco toglie il blocco
    prima di partire.
    /stato dice quante pagine sono collegate agli eventi, e la diagnostica avvisa
    quando nessuno schermo mostra l'applicazione: il servizio del chiosco
    risultava attivo anche con l'avviso davanti.
2026-10-09 Commenti: la luce dello scatto è quella di sempre, accesa dallo stato
2026-10-12 Il codice passa alla licenza MIT
    Il codice sorgente (src, scripts, firmware, data/*.py, tests) era sotto
    GPL-3.0 o successiva ed è ora sotto licenza MIT. Documentazione, immagini e
    file di stampa restano CC BY 4.0, il database ODbL 1.0, il modello
    Apache-2.0. Le attribuzioni spiegano che Piper, la voce, resta GPL-3.0: non
    è nel repository, lo installa install.sh, e chi distribuisce un dispositivo
    con Piper ne rispetta la licenza.
